ahm-adsaad/sdp-sensor-nodes/poster/poster-sustainability.html

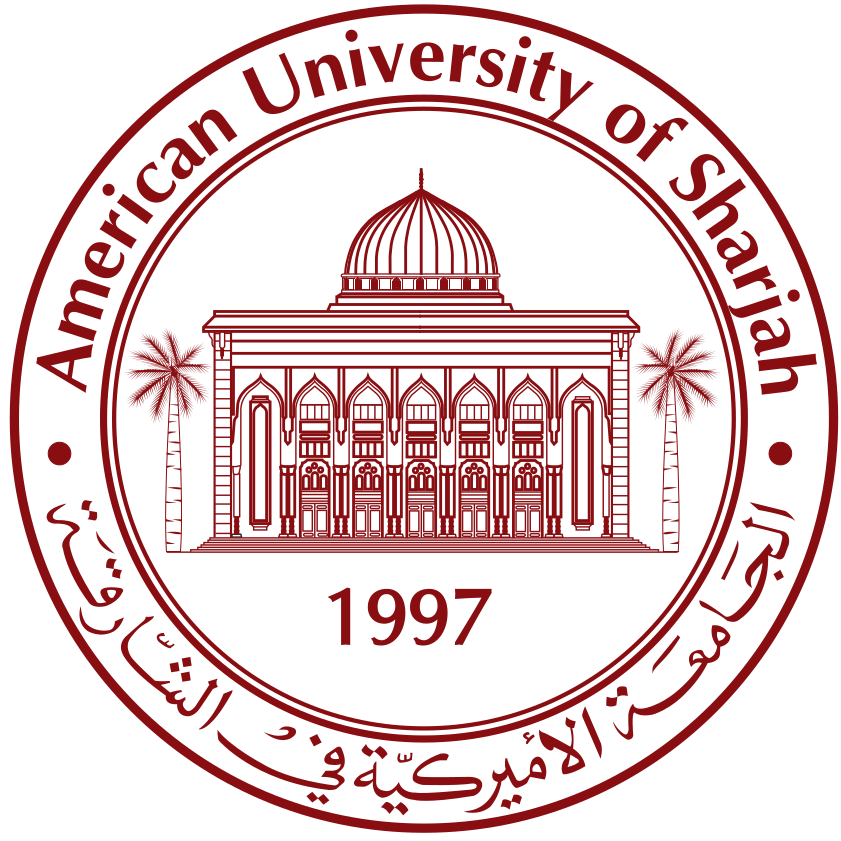
[picture p1: poster/assets/aus-seal.png]
American University of Sharjah seal


# A Practical Implementation of a Virtualized Energy Harvesting IoT

Ahmad Saad, Abdulrahman Hanifa, Mohammad Alatrash, Abdalrahman Al-Zaharna

Advisor: Dr. Anastassia Gharib
Department of Computer Science and Engineering, American University of Sharjah

## I. The Battery Problem

Sensor networks monitor the environment in many applications, but battery-powered deployments need periodic battery replacement, which hinders scalable long-term operation.

Most deployed sensor nodes run on batteries or a grid connection. Batteries degrade, and replacing them can be costly or dangerous [1]; nodes are often discarded once their batteries are depleted, even when the hardware still works.

As IoT deployments grow, so does the need for batteries, and periodic battery maintenance limits how far monitoring networks can scale and how sustainable they are.

Solar energy harvesting (EH) lets nodes recharge from ambient sources and extends network lifetime [2], but harvested energy is intermittent [3].

EH, node virtualization and dynamic task assignment have been explored separately; few works implement them together in hardware.

Goal: sustainable power without battery replacement, with every sensing task matched to the energy the nodes have stored.

## II. Battery vs. Harvesting

| Battery or grid node | Solar EH node, this work
Energy | Disposable battery or a grid connection | Ambient sunlight through a solar panel
Storage | Rechargeable battery: thousands of cycles [4] | Supercapacitor: millions of cycles [4], wide temperature range [5]
Upkeep | Periodic battery replacement | No battery to replace, lower maintenance cost [6]
Hazardous sites | Workers visit industrial, remote and high-rise sites | Fewer site visits: lower operating cost, safer workers
End of life | Often discarded with working hardware | Less battery and electronic waste
Grid | Grid-connected nodes need a power line | Grid-free nodes; one gateway covers power- and cellular-limited sites

## III. System Model

## IV. Resilience for Sharjah

Theme | Where the network serves
Resilient energy systems | Solar nodes with no grid dependency keep sensing where power access is limited
Water security | Remote wastewater plants: hazardous gases, temperature and humidity; water management
Climate and environmental resilience | Greenhouses in UAE sustainable cities: humidity and CO2
Smart and sustainable cities | Smart-city development such as Sharjah Sustainable City [7] and Masdar City [8]
Critical infrastructure | Industrial sites, remote infrastructure and high-rise installations, where access is difficult or unsafe

Energy-aware task assignment on battery-free nodes lays the groundwork for the large-scale adoption of sustainable IoT, enabling more resilient, efficient and environmentally conscious urban infrastructure.

## V. Energy-Aware Node

Harvesting charges the supercapacitor whatever the MCU state. A node sleeps, wakes to listen for tasks, powers its sensors through a load switch only while a task runs, then transmits readings with its energy status.

Virtualization lets one node serve different sensing tasks over time, so each node is used efficiently [9].

## VI. Energy-Aware Task Assignment

Each round, the VPS checks that the nodes’ stored energy ei covers every submitted task ej plus a reserve es=egas+etemp kept for future immediate tasks:

∑j∈Timm∪Tnonej+es≤∑i=1Sei (1)

If (1) fails, only immediate tasks enter. A MILP then favours costly tasks on nodes with a high remaining-energy share Pi, giving each task at most one node and keeping each node within its stored energy.

A two-phase heuristic is also defined: Phase 1 places each immediate task on the highest-energy node that can afford it; Phase 2 packs non-immediate tasks onto fewer nodes to reduce communication overhead, while each node keeps a reserve θ=egas+etemp. Unassigned tasks can be reconsidered once nodes report newly harvested energy.

Safety: a node must not start a task its stored energy cannot cover, and refuses high-power tasks when its supercapacitor runs low.

## VII. Low-Power Design Choices

Part | Chosen | Over | Deciding figure
MCU | ATmega4809 | ESP32 | 0.1 µA power-down [10] vs 10 µA deep sleep, RAM lost [11]
PMIC | AEM10330 | BQ25570 | Cold start from 275 mV [12] vs 600 mV [13]
Gas | ENS160 | SGP30 | 29 mA vs 48.8 mA active [14], [15]
Radio | LoRaWAN | BLE, Zigbee | 15 km line of sight vs 60 m and 75 m per hop [16]

## VIII. Evaluation Plan

Requirement | Target
Node to dashboard delay | ≤ 10 s
Data delivered, node to server | ≥ 95 %
Average node power when idle | < 10 mW
Nodes served at once, no packet loss | ≥ 4
Server and dashboard uptime | ≥ 95 %

The PPK2 will profile every node mode to confirm sustainable operation during sunlight hours; the scheme will be judged on task completion rate, latency and network lifetime.

## References

1. C. Delgado, J. M. Sanz, C. Blondia, J. Famaey, “Batteryless LoRaWAN communications using energy harvesting: Modeling and characterization,” IEEE Internet Things J., vol. 8, no. 4, 2021.
2. A. Singh, S. Redhu, B. Beferull-Lozano, R. M. Hegde, “Network-aware RF-energy harvesting for designing energy efficient IoT networks,” Internet of Things, vol. 22, 2023.
3. D. Ma, G. Lan, M. Hassan, W. Hu, S. K. Das, “Sensing, computing, and communications for energy harvesting IoTs: A survey,” IEEE Commun. Surv. Tutor., vol. 22, no. 2, 2020.
4. U. Tiwari, “What is the difference between supercapacitors and batteries?” 2024.
5. P. Matthews, “Supercapacitors vs. batteries: A comparison in energy storage solutions,” Knowles Precision Devices, 2024.
6. G. Avallone et al., “A comparative evaluation of IoT electronic solutions for energy harvesting,” Nano Express, vol. 5, no. 3, 2024.
7. Sharjah Sustainable City, “Sharjah Sustainable City reimagines future, vows healthy environment, sustainable development.”
8. Masdar City, “Net zero by 2050.”
9. I. Khan, F. Belqasmi, R. Glitho, N. Crespi, M. Morrow, P. Polakos, “Wireless sensor network virtualization: A survey,” IEEE Commun. Surv. Tutor., vol. 18, no. 1, 2016.
10. Microchip, ATmega4808/4809 Data Sheet, DS40002173C, 2021.
11. Espressif, ESP32 Series Datasheet, 2025.
12. e-peas, AEM10330 Datasheet, 2024.
13. Texas Instruments, BQ25570 Nano Power Boost Charger and Buck Converter for Energy Harvester Powered Applications, 2019.
14. ScioSense, ENS160 Digital Metal-Oxide Multi-Gas Sensor Datasheet, 2023.
15. Sensirion, SGP30 Indoor Air Quality Sensor Datasheet, 2020.
16. S. Sadowski, P. Spachos, “RSSI-based indoor localization with the Internet of Things,” IEEE Access, vol. 6, 2018.

We thank Dr. Zaid Haymoor for guidance on the hardware implementation.
