ahm-adsaad/sdp-sensor-nodes/poster/poster.html

American University of Sharjah seal

# A Practical Implementation of a Virtualized Energy Harvesting IoT

Ahmad Saad, Abdulrahman Hanifa, Mohammad Alatrash, Abdalrahman Al-Zaharna

Advisor: Dr. Anastassia Gharib
Department of Computer Science and Engineering, American University of Sharjah

## I. Motivation

Battery-powered sensor nodes need periodic battery replacement, which hinders scalable long-term operation; batteries degrade, and replacing them can be costly or dangerous [1]. Energy harvesting (EH) removes the battery, but harvested energy is intermittent.

EH, sensor-node virtualization and dynamic task assignment have been studied separately; few works implement them together in hardware.

Work | Covers | Lacks
[2] | Solar EH, deployed six months | One sensor per node
[3] | Solar EH, node virtualization | Reconfiguration across task types
[4] | Solar EH, task scheduling | Tasks fixed in advance
[5] | Virtualization, dynamic task arrival | Energy harvesting
Ours | Solar EH, node virtualization and dynamic task assignment on custom nodes

Goal: use harvested energy efficiently, maximize the task completion rate and minimize latency.

## II. System Model

## III. Sensor Node

Three power domains: 3V3_IN from the PMIC, joined to the core 3V3 rail through a header for the Nordic PPK2 power profiler, and VCC_SENS, which the load switch cuts during sleep to remove sensor quiescent draw.

## IV. Node Operation

Harvesting charges the supercapacitor whatever the MCU state. A node sleeps, wakes periodically to listen for tasks, powers its sensors only while a task runs, and transmits readings with its energy status before sleeping again.

## V. Task Assignment

### A. MILP

Each round, the VPS checks that the nodes’ stored energy ei covers every submitted task ej plus a reserve es=egas+etemp kept for future immediate tasks:

∑j∈Timm∪Tnonej+es≤∑i=1Sei (1)

If (1) fails, only immediate tasks enter. The MILP then favours costly tasks on nodes with a high remaining-energy share Pi:

max∑i=1S∑j=1TxijejPi (2)

s.t. ∑i=1Sxij≤1,∀j (3)

∑j=1Txijej≤ei,∀i (4)

with xij∈{0,1} set when task j goes to node i. Constraint (3) gives each task at most one node; (4) keeps each node within its stored energy.

### B. Heuristic

Phase 1 places each immediate task on the highest-energy node that can afford it. Phase 2 packs non-immediate tasks onto fewer nodes to reduce communication overhead, while each node keeps a reserve θ=egas+etemp.

Input: nodes S, tasks Timm, Tnon, cost C(t), reserve θ

1. sort Timm, Tnon by C(t), descending
2. for t ∈ Timm doPhase 1
3. sort S by energy E(s), descending
4. for s ∈ S do
5. if E(s) ≥ C(t) then
6. assign(s, t); E(s) −= C(t); break
7. sort S by E(s), descendingPhase 2
8. for s ∈ S do
9. for t ∈ Tnon do
10. if E(s) − C(t) ≥ θ then
11. assign(s, t); E(s) −= C(t)
12. return S and the unassigned tasks

Unassigned tasks can be reconsidered once nodes report newly harvested energy.

## VI. Design Choices

Part | Chosen | Over | Deciding figure
MCU | ATmega4809 | ESP32 | 0.1 µA power-down [6] vs 10 µA deep sleep, RAM lost [7]
PMIC | AEM10330 | BQ25570 | Cold start from 275 mV [8] vs 600 mV [9]
Storage | Supercapacitor | Battery | Millions vs thousands of charge cycles [10]
Gas | ENS160 | SGP30 | 29 mA vs 48.8 mA active [11], [12]
Radio | LoRaWAN | BLE, Zigbee | 15 km line of sight vs 60 m and 75 m per hop [13]

### Standards

LoRaWAN 1.0.4 Class A; ETSI EN 300 220-2 for 868 MHz, as required by the UAE TDRA; MQTT 3.1.1; TLS 1.3 between gateway and VPS; RoHS 2011/65/EU; IPC-2221; IEEE C95.1; ISO/IEC 14882; ISO 9241-11.

## VII. Evaluation Plan

Requirement | Target
Node to dashboard delay | ≤ 10 s
Data delivered, node to server | ≥ 95 %
Average node power when idle | < 10 mW
Nodes served at once, no packet loss | ≥ 4
Server and dashboard uptime | ≥ 95 %

The PPK2 will profile each mode: sleep, wake, SHT41 and ENS160 reads, LoRa Tx and Rx. The network will be judged on packet delivery ratio and energy per transmission; the scheme on task completion rate, latency, task distribution and network lifetime. Safety: a node must not start a task its stored energy cannot cover.

## VIII. Toward Resilient Infrastructure

- Grid-independent nodes and a single long-range gateway suit power- and cellular-limited sites: hazardous gases, temperature and humidity at remote wastewater plants, or humidity and CO2 in greenhouses.
- Fewer battery replacements at hard-to-reach or hazardous sites lower maintenance cost, keep workers safer and cut battery waste.
- Supports sustainable-city development such as Sharjah Sustainable City.

## References

1. C. Delgado, J. M. Sanz, C. Blondia, J. Famaey, “Batteryless LoRaWAN communications using energy harvesting: Modeling and characterization,” IEEE Internet Things J., vol. 8, no. 4, 2021.
2. K. Malek et al., “Design and implementation of sustainable solar energy harvesting for low-cost remote sensors equipped with real-time monitoring systems,” J. Infrastruct. Intell. Resil., vol. 2, no. 3, 2023.
3. L. Zhang, K.-W. Chin, M. Ros, “On virtualizing targets coverage in energy harvesting IoT systems,” IEEE Internet Things J., vol. 11, no. 2, 2024.
4. Y. Cui, K.-W. Chin, S. Soh, M. Ros, “Novel task scheduling approaches in energy sharing solar-powered IoT networks,” IEEE Internet Things J., vol. 10, no. 12, 2023.
5. V. Maleki Raee, A. Ebrahimzadeh, R. H. Glitho, H. Elbiaze, “Ensuring energy efficiency when dynamically assigning tasks in virtualized wireless sensor networks,” IEEE Trans. Green Commun. Netw., vol. 6, no. 1, 2022.
6. Microchip, ATmega4808/4809 Data Sheet, DS40002173C, 2021.
7. Espressif, ESP32 Series Datasheet, 2025.
8. e-peas, AEM10330 Datasheet, 2024.
9. Texas Instruments, BQ25570 Nano Power Boost Charger and Buck Converter for Energy Harvester Powered Applications, 2019.
10. U. Tiwari, “What is the difference between supercapacitors and batteries?” 2024.
11. ScioSense, ENS160 Digital Metal-Oxide Multi-Gas Sensor Datasheet, 2023.
12. Sensirion, SGP30 Indoor Air Quality Sensor Datasheet, 2020.
13. S. Sadowski, P. Spachos, “RSSI-based indoor localization with the Internet of Things,” IEEE Access, vol. 6, 2018.

We thank Dr. Zaid Haymoor for guidance on the hardware implementation.
