ahm-adsaad/sdp-sensor-nodes/enclosure/out/renders/body_back.png

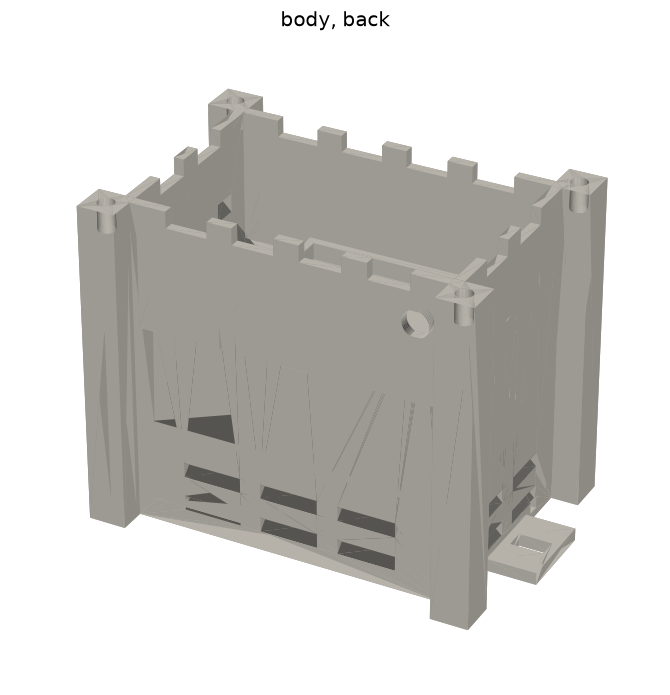
enclosure/out/renders/body_back.png
