ahm-adsaad/sdp-sensor-nodes/enclosure/out/renders/body_front.png

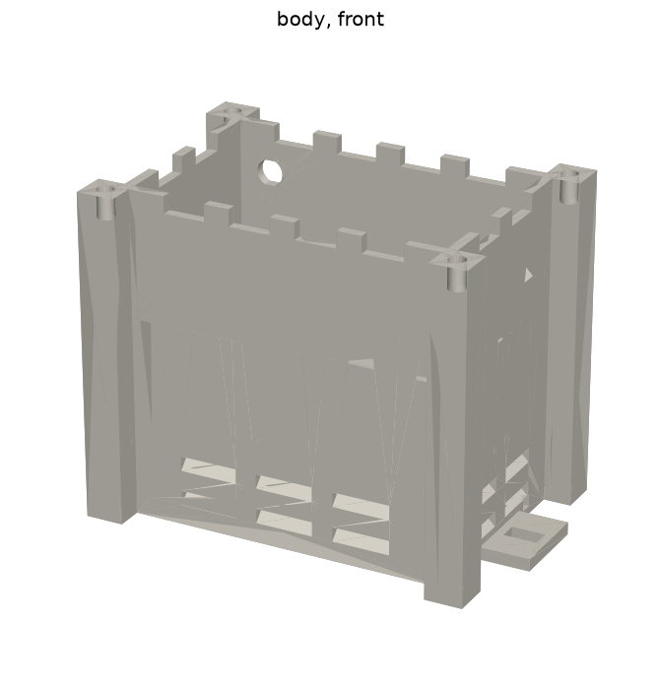
enclosure/out/renders/body_front.png
