ahm-adsaad/sdp-sensor-nodes/enclosure/out/renders/body_top.png

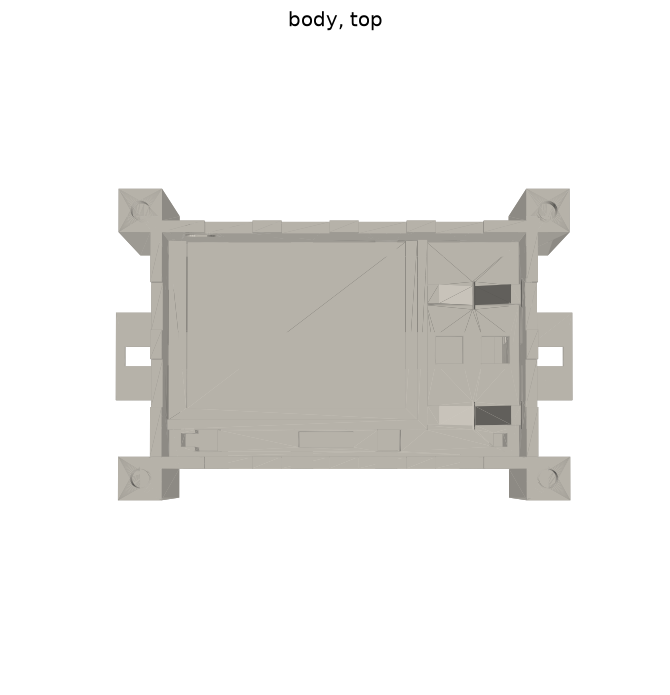
enclosure/out/renders/body_top.png
