ahm-adsaad/sdp-sensor-nodes/enclosure/out/renders/body_under.png

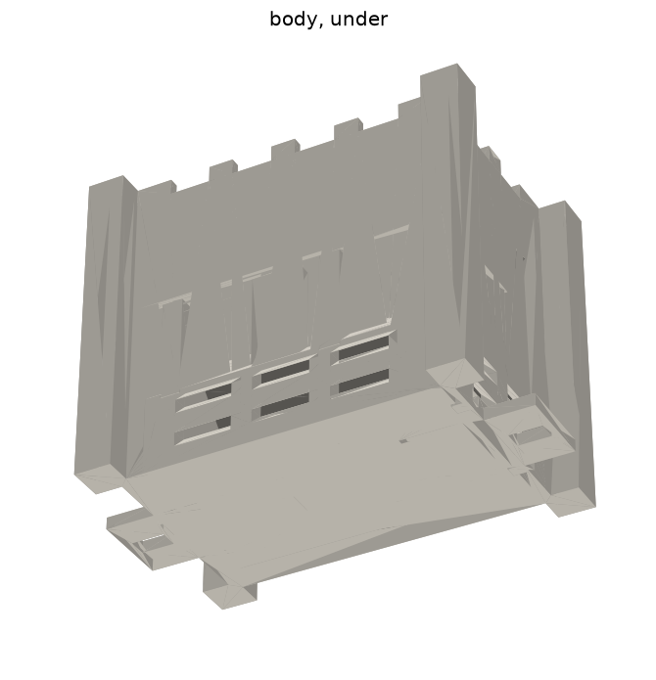
enclosure/out/renders/body_under.png
