ahm-adsaad/sdp-sensor-nodes/enclosure/out/renders/fit_coupon_back.png

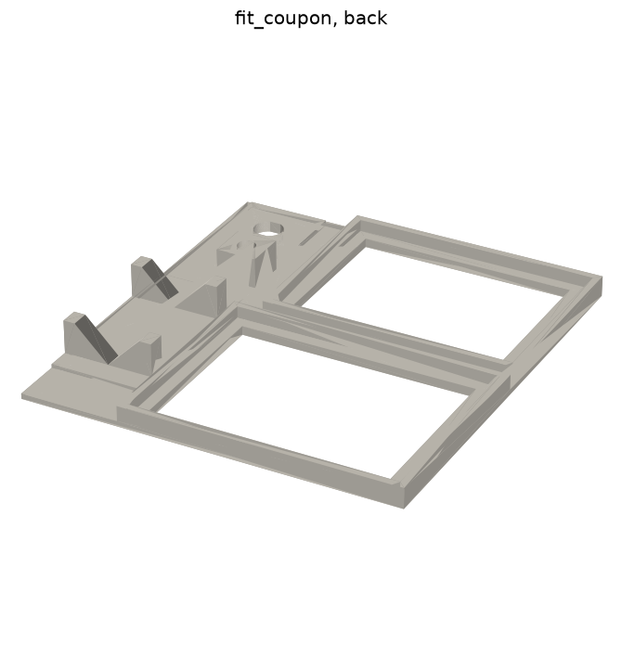
enclosure/out/renders/fit_coupon_back.png
