ahm-adsaad/sdp-sensor-nodes/enclosure/out/renders/fit_coupon_front.png

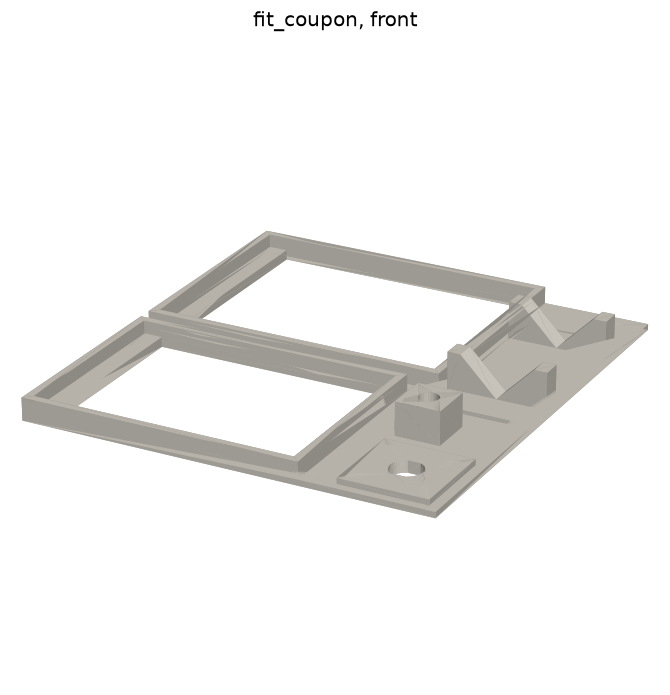
enclosure/out/renders/fit_coupon_front.png
