ahm-adsaad/sdp-sensor-nodes/enclosure/out/renders/fit_coupon_top.png

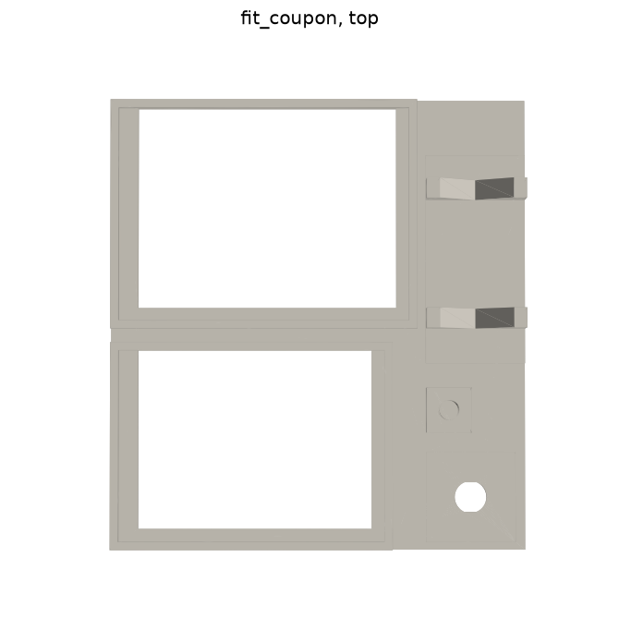
enclosure/out/renders/fit_coupon_top.png
