ahm-adsaad/sdp-sensor-nodes/enclosure/out/renders/fit_coupon_under.png

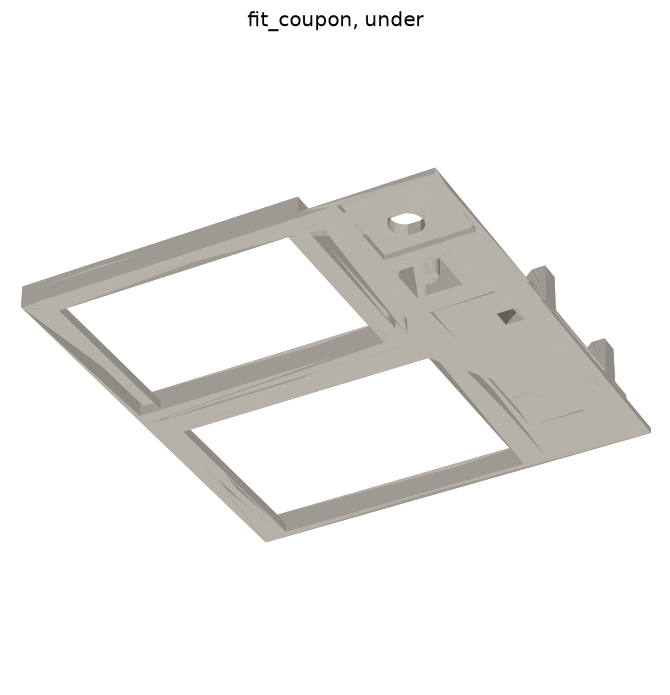
enclosure/out/renders/fit_coupon_under.png
