ahm-adsaad/sdp-sensor-nodes/enclosure/out/renders/lid_1panel_back.png

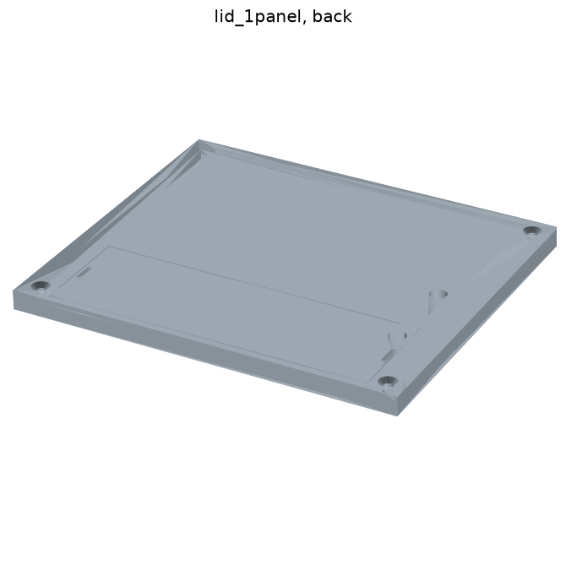
enclosure/out/renders/lid_1panel_back.png
