ahm-adsaad/sdp-sensor-nodes/enclosure/out/renders/lid_1panel_front.png

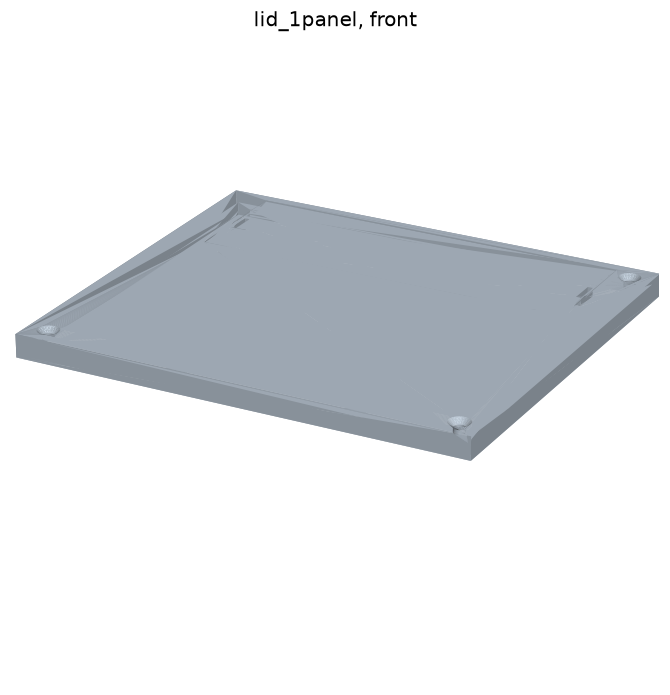
enclosure/out/renders/lid_1panel_front.png
