ahm-adsaad/sdp-sensor-nodes/enclosure/out/renders/lid_1panel_top.png

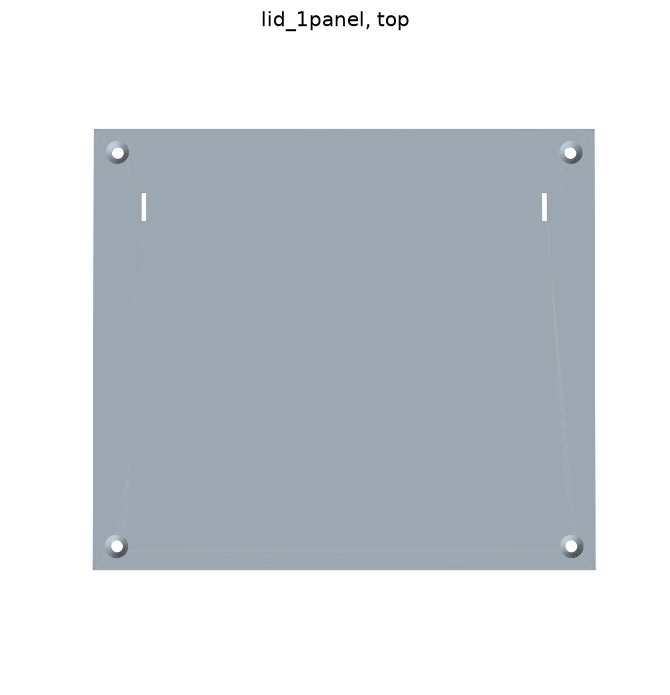
enclosure/out/renders/lid_1panel_top.png
