ahm-adsaad/sdp-sensor-nodes/enclosure/out/renders/lid_1panel_under.png

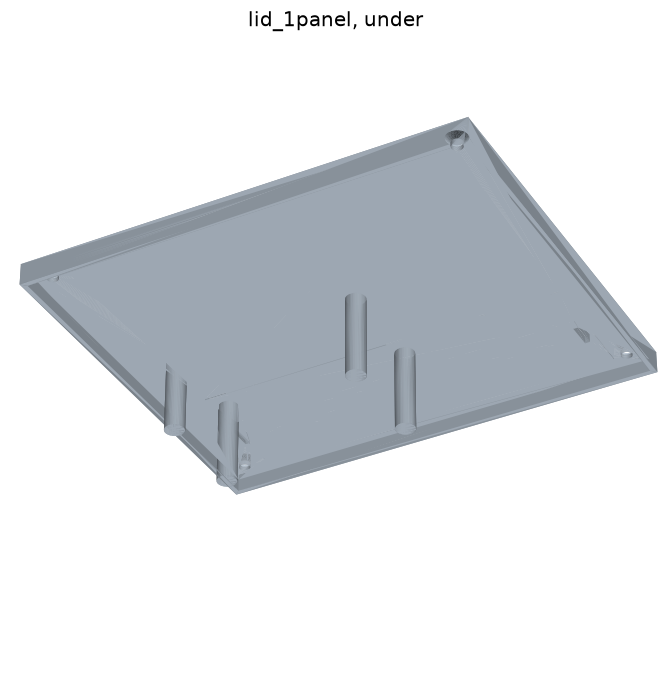
enclosure/out/renders/lid_1panel_under.png
