ahm-adsaad/sdp-sensor-nodes/enclosure/out/renders/lid_back.png

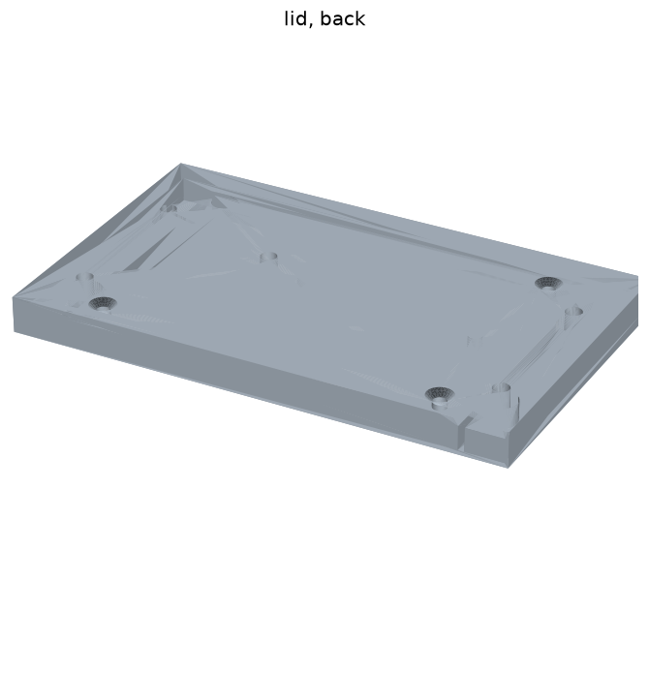
enclosure/out/renders/lid_back.png
