ahm-adsaad/sdp-sensor-nodes/enclosure/out/renders/lid_front.png

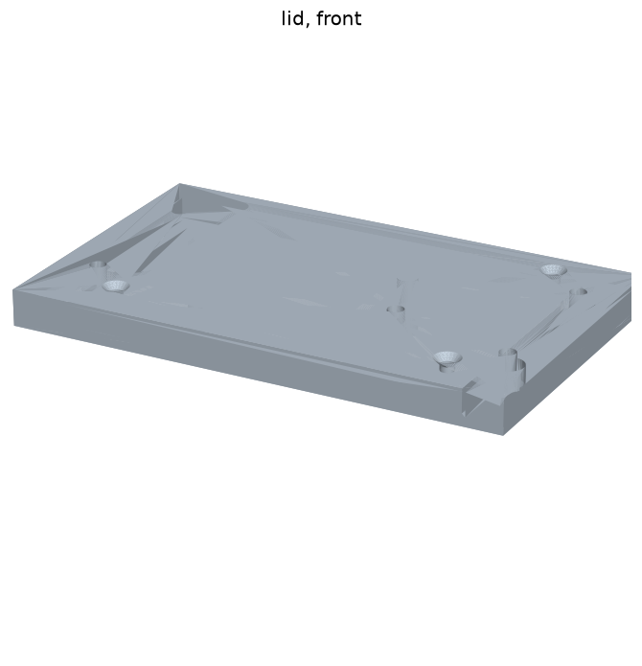
enclosure/out/renders/lid_front.png
