ahm-adsaad/sdp-sensor-nodes/enclosure/out/renders/lid_top.png

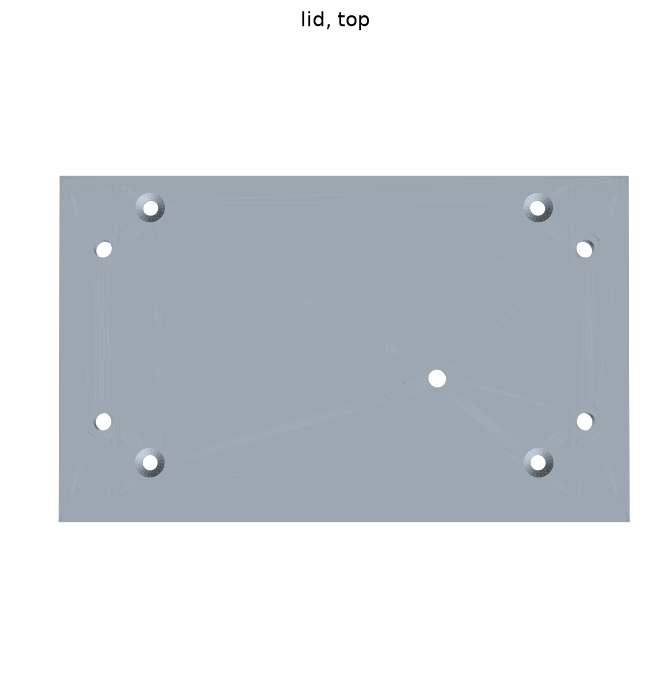
enclosure/out/renders/lid_top.png
