ahm-adsaad/sdp-sensor-nodes/enclosure/out/renders/lid_under.png

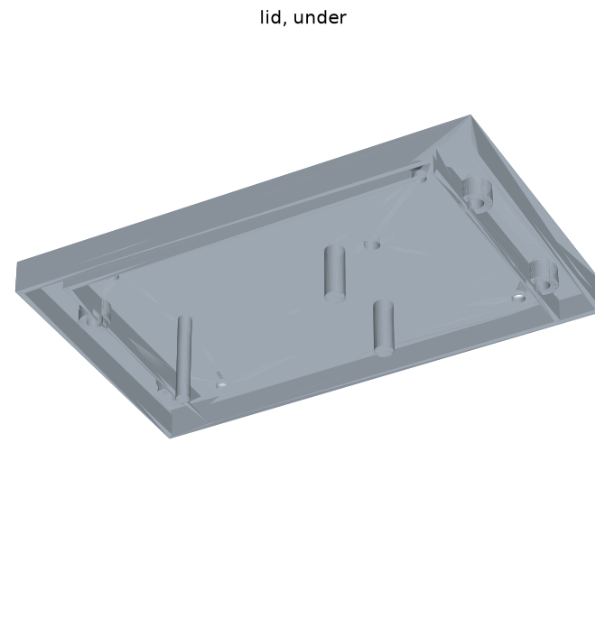
enclosure/out/renders/lid_under.png
