ahm-adsaad/sdp-sensor-nodes/enclosure/out/renders/wedge_back.png

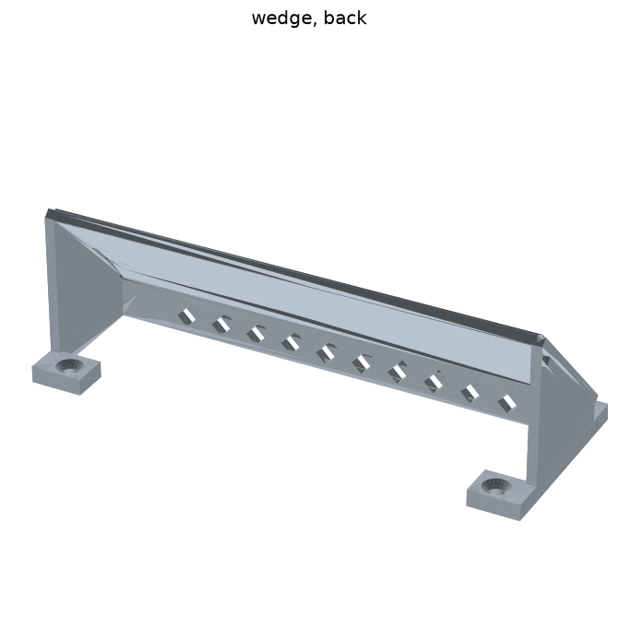
enclosure/out/renders/wedge_back.png
