ahm-adsaad/sdp-sensor-nodes/enclosure/out/renders/wedge_front.png

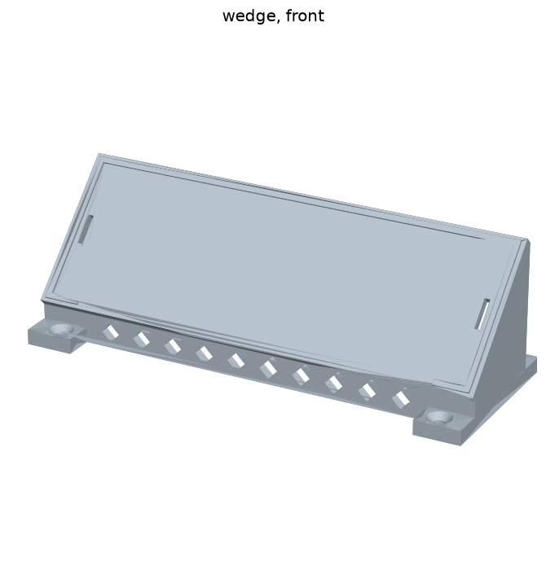
enclosure/out/renders/wedge_front.png
