ahm-adsaad/sdp-sensor-nodes/enclosure/out/renders/wedge_top.png

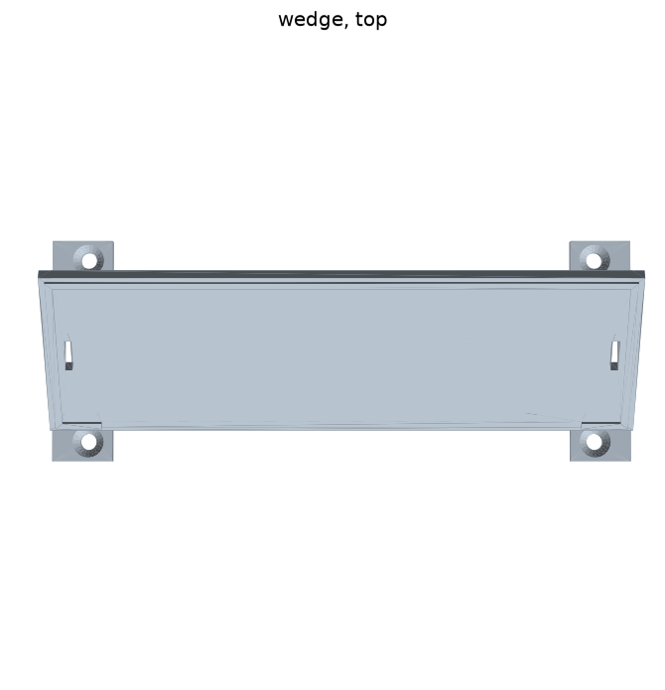
enclosure/out/renders/wedge_top.png
