ahm-adsaad/sdp-sensor-nodes/enclosure/out/renders/wedge_under.png

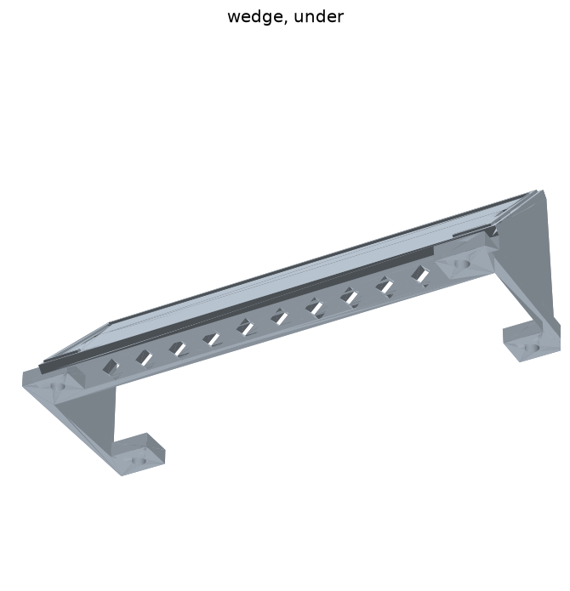
enclosure/out/renders/wedge_under.png
