ahm-adsaad/sdp-sensor-nodes/poster/poster-preview.png

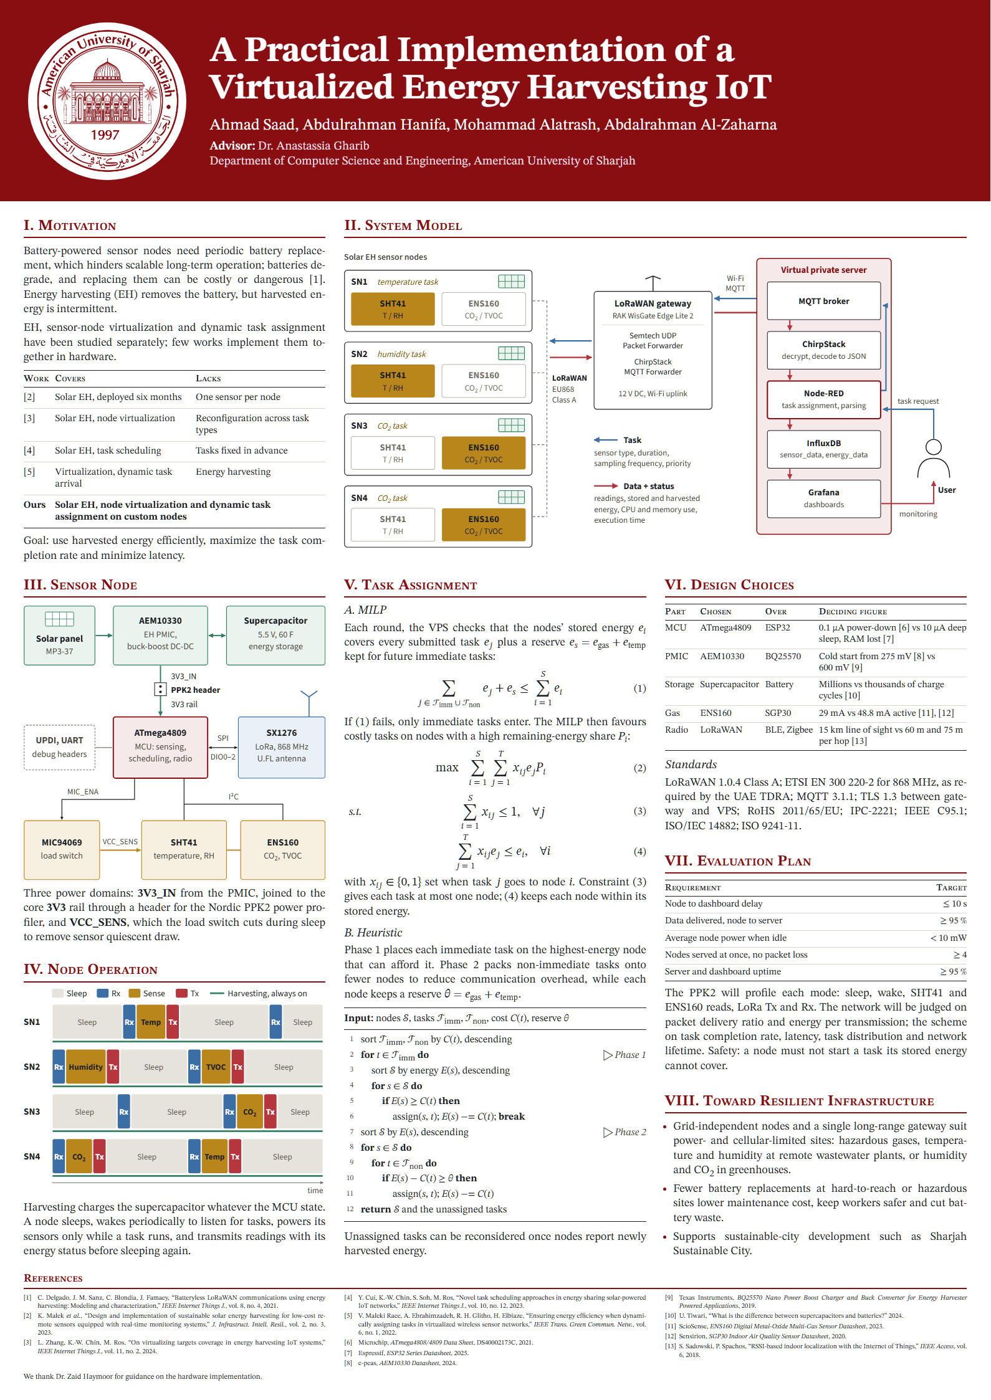
poster/poster-preview.png
