ahm-adsaad/sdp-sensor-nodes/poster/poster-sustainability-preview.png

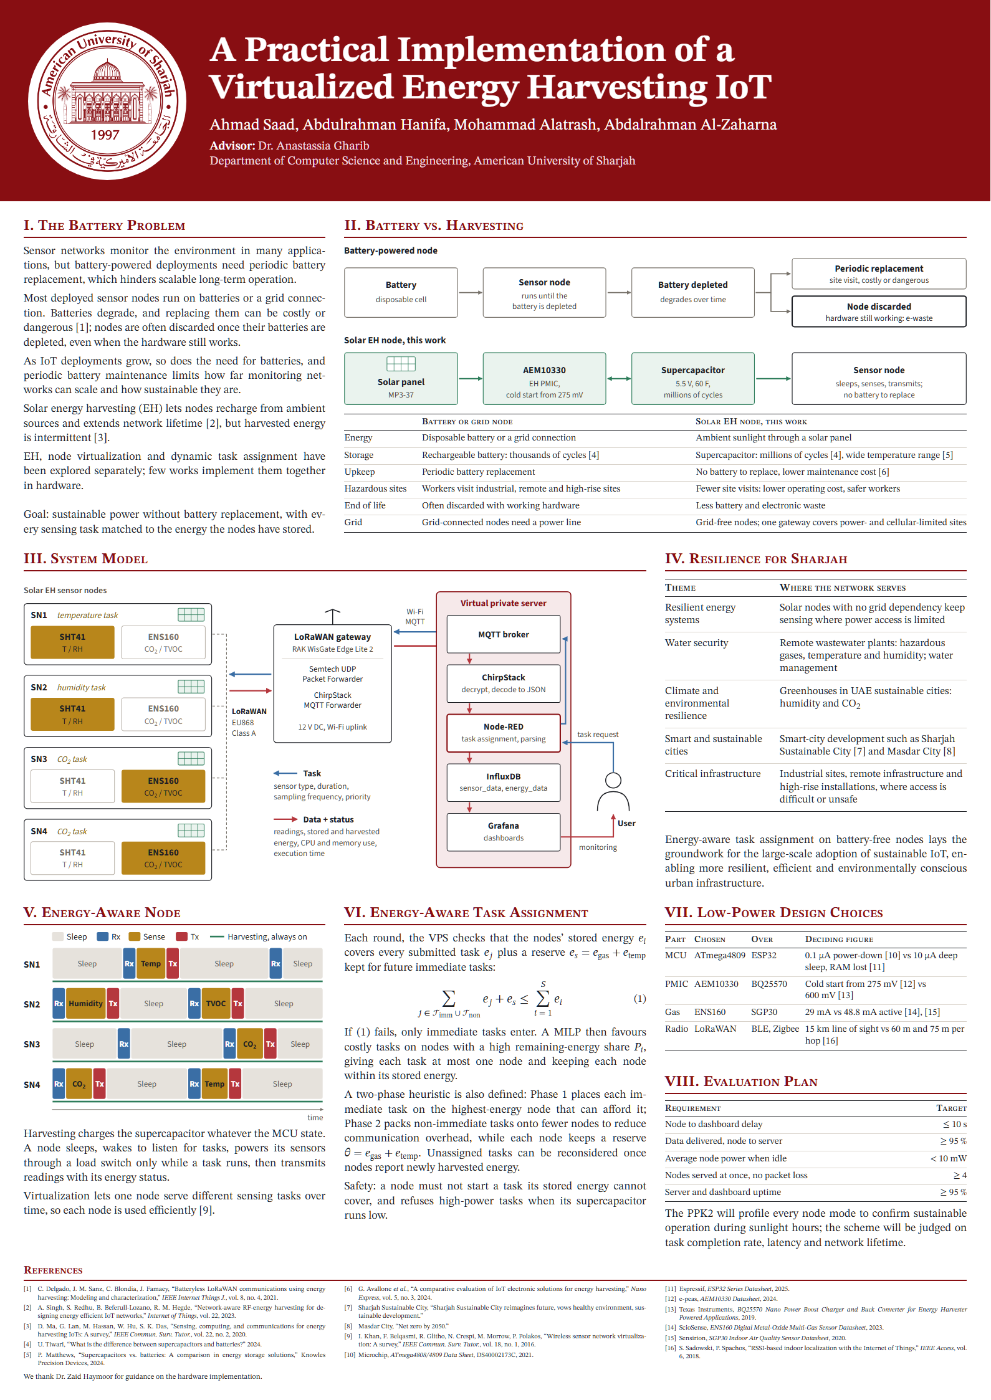
poster/poster-sustainability-preview.png
