ahm-adsaad/sdp-sensor-nodes/sensor-nodes-hardware/photos/Sensor Node.jpeg

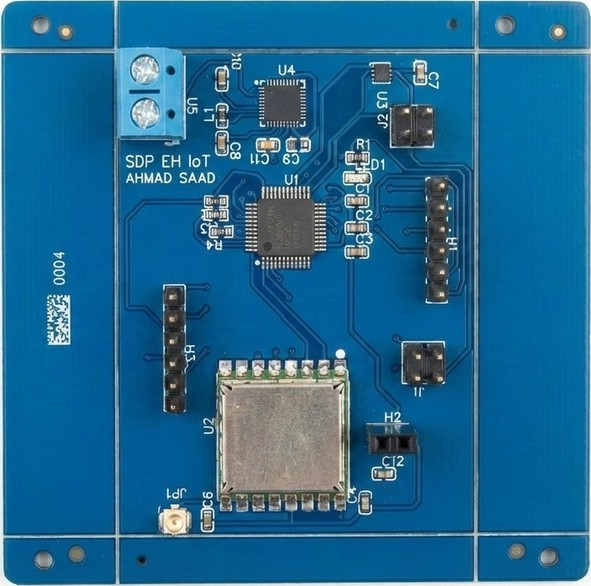
sensor-nodes-hardware/photos/Sensor Node.jpeg
