ahm-adsaad/sdp-sensor-nodes/docs/research/2026-09-20-energy-prediction-literature.UPDATED.xlsx

Sheet: Papers
# | Group | Paper | What they did | Main result | How the model works, and what it uses | Link
2 | A. Predicting harvest | Prediction and management in energy harvested wireless sensor nodes | Predicts the energy in the next 30 minute slot. The forecast blends the last measured slot with the average of that next slot over the last 4 days, scaled by how today is running against those days. Called WCMA (Weather-Conditioned Moving Average). Settings were tuned and tested against EWMA on 45 days of their own solar panel data. The forecast was then used to decide how much signal processing a Shimmer structural health monitoring node could afford around noon on four days. | Average error over all 45 days: 9.8 percent for WCMA against 28.6 percent for EWMA, predicting the next 30 min slot. The error is the mean of |1 - real/predicted| (Eq. 9), daytime only (samples under 10 percent of the maximum left out), on the same 45 days used to pick the settings. In the 30 min slot at noon on day 8, when the weather turned: 10.20 percent for WCMA against minus 90.99 percent for EWMA (real 284.63 J, WCMA 255.60 J, EWMA 543.60 J). Used to plan processing on a Shimmer node that day, WCMA gave 1.45 s of DSP time per path (oracle 1.63 s), while EWMA planned 3.22 s and the node ran out of energy before finishing the scan. | Day split into 48 slots of 30 minutes, with the last 4 days kept in memory. The forecast for the next slot is 0.7 times the last measured slot plus 0.3 times the plain average of the next slot over those 4 days, and that average is scaled by a GAP factor. GAP is a weighted average of today's last 3 slots divided by the average of the same slots on the stored days, with weights 1/3, 2/3 and 1 so the newest slot counts most. Published settings: weighting factor 0.7, 4 days, 48 slots, 3 slots for the GAP factor. Input is the node's own harvest history, nothing external. | https://doi.org/10.1109/WIRELESSVITAE.2009.5172412
3 | A. Predicting harvest | Evaluation and design exploration of solar harvested-energy prediction algorithm | Takes the WCMA predictor (cited as Recas et al., 2009; the paper does not use the name WCMA) and tests it on 365 days of public NREL data from six US sites with different solar profiles, at slot lengths from 5 minutes to 1 hour. The slot length is the prediction horizon. Proposes scoring the prediction against the slot's mean power, gives tuning guidelines for the parameters, measures the cost on an MSP430, and estimates how much an ideal choice of parameters at every prediction could gain. | MAPE against the slot's mean power, daytime only, with parameters tuned per site on the same data: 6.59 to 17.22 percent at 30 minutes (PFCI best, ORNL worst) and 8.88 to 21.43 percent at 1 hour (NPCS best, ORNL worst). Shorter slots were always more accurate: 3.45 to 8.31 percent at 5 minutes on the four 1 minute sites. A prediction costs 4 to 9 microjoules on top of 55 microjoules for the ADC reading. Choosing alpha and K ideally at every prediction, which needs the future, cut 30 minute error to 5.37 to 7.38 percent on four sites. | Prediction = alpha x the reading at the start of the current slot + (1 - alpha) x the mean of the next slot over the last D days x a factor for how bright today is. The factor averages today's last K readings divided by their past-day means, weighted towards the latest slot. For each site the paper sweeps slots per day (288, 96, 72, 48, 24), stored days D (2 to 20), recent slots K (1 to 6) and alpha (0 to 1), and keeps the set with the lowest MAPE. The data is public NREL irradiance from 6 US sites, not node measurements. Guidelines: D of 10 to 11 days, K = 2, alpha 0.7 to 0.8 for 48 to 96 slots a day, 0.5 to 0.6 at 24 and about 1 at 288. Also measures what a prediction costs on an MSP430. | https://doi.org/10.1109/DATE.2010.5457222
4 | A. Predicting harvest | Pro-Energy: a novel energy prediction model for solar and wind energy-harvesting wireless sensor networks | Keeps a pool of whole past days of harvest. Each slot it finds the stored day, or a weighted blend of several, whose last few slots best match today's, and forecasts the coming slots by mixing that day's values with the latest measured slot. The latest slot counts less the further ahead the forecast goes. | On the Rome solar nodes, error (MAPE) of 20.00 percent 30 minutes ahead, against 21.12 for WCMA and 35.21 for EWMA, and 26.18 against 35.51 and 35.21 one hour ahead, rising to 31.92 at 3 hours while EWMA stayed at 35.21. Slots below 10 percent of the day's peak power were left out of the MAPE, and past one slot WCMA was the authors' simplified version. On the Oak Ridge solar data, 60 percent better than EWMA and WCMA at 1 hour. The 2016 journal version reports up to 67 percent lower error (MADP) on the Oak Ridge solar data. | Day split into N equal slots (48 of 30 minutes), with a pool of D whole past days kept in memory. Similarity is the mean absolute error between each stored day and today over the last K slots. For a slot i steps ahead, the forecast is gamma_i x last measured slot + (1 - gamma_i) x that slot in the most similar stored day, or in a weighted blend of the P most similar days. gamma_i starts at alpha and falls linearly to zero after G slots. At the end of each day, today's profile replaces one stored more than A days ago, or one of two near-duplicate days. Input is the node's own harvest history only. | https://doi.org/10.1109/MASS.2012.6502504
5 | A. Predicting harvest | UD-WCMA: an energy estimation and forecast scheme for solar powered wireless sensor networks | Makes WCMA's weighting adapt as the weather changes, rather than being tuned in advance, by blending the latest measurement, the most similar stored day and the average of the stored days scaled by GAP. Tested on recorded irradiance and on the panel current of 10 solar-powered nodes. | On 6 test days of 30 min irradiance it had the lowest one-slot-ahead relative error (percent) on every day against EWMA, WCMA and Pro-Energy, each given its best alpha (0.2 to 0.8) after the fact; on 2 of the days the margin is too small to read from the chart. At 1 to 3 h ahead (mean absolute error) the authors report it best on 5 of 6 days, though their chart shows WCMA level or slightly lower at some horizons on 2 of those days; on the most variable day WCMA and Pro-Energy did better beyond 30 min. Over a year of 1 h KAUST data its absolute error peaked near 24 W/m2, lower than the others. On a 10 node deployment run for 6 months, the forecast of panel current for the day shown had an RMSE of 18.79 mA, and it ran in 1 ms; no other method was run on the nodes. An independent 2020 comparison (Herrería-Alonso et al., Sensors 20(5) 1391) found it beat Pro-Energy only at that method's low overhead setting, at 30 to 120 min ahead. | Keeps 6 hand-picked past days, chosen to cover low, medium and high levels with smooth and abrupt changes; no rule for updating them is given. The forecast blends today's last value, the matching slot in the most similar stored day, and the average of the stored days scaled by a GAP factor. The blend weights are recomputed every slot from standard deviations: of the stored days at the next slot, of their slot-to-slot changes, and of today's last 3 changes. By the formulas, the GAP-scaled average always gets at least half the weight, and when today's recent changes vary more, weight moves from the last reading to the most similar stored day. Uses 4 recent slots. No tuning. Input: panel current or irradiance every 30 minutes (1 h in a year-long test). | https://doi.org/10.1016/j.jnca.2017.04.003
11 | A. Predicting harvest | Cloudy computing: leveraging weather forecasts in energy harvesting sensor systems | Predicts harvest from a public weather forecast instead of the node's own history. Solar: a clear day power curve for the month, reduced by the forecast cloud cover. Wind: a fitted cubic of the forecast wind speed. Tested in simulation on two systems with fixed demand: a sensor testbed that accepts or rejects 24 h leases, and a five-node TelosB network that sets a fair sensing rate each day. | Between 3 hours and 3 days ahead, the forecast's error in the weather itself was under half that of assuming the past repeats: sky cover RMSE under 30 against about 60, wind speed under 6 against about 11 mph. In the simulated five-node network on solar, at least one node ran out of energy on under 5 percent of days with forecasts, against nearly 50 percent with history, while keeping 80 percent of the history-based sensing rate (the bar in Fig. 9a reads nearer 9 percent). No error figure is given for the harvest prediction itself. | Solar: power = alpha x MaxPower(month, time of day) x (1 - forecast cloud cover). MaxPower is a quadratic in time of day, fitted by least squares to one cloudless day per month. Wind: power = alpha x (0.01787485 x windspeed^3 - 3.4013). Alpha is a constant per forecast horizon, set from the forecast's RMSE at that horizon, smaller when the forecast is less accurate. Inputs: National Weather Service sky cover and wind speed forecasts, every 3 h from 3 to 72 hours ahead. No machine learning, only least-squares curve fits. | https://doi.org/10.1109/SECON.2010.5508260
19 | A. Predicting harvest | Power management in energy harvesting sensor networks | Defined energy-neutral operation and gave sufficient conditions for it from a burstiness model of harvest and load, with storage efficiency and leakage, leading to a minimum buffer size and a sustainable power level. Built an EWMA predictor of solar harvest per half-hour slot, a low-complexity duty-cycle optimiser and a per-slot correction algorithm, tested on 67 days of Heliomote solar data from Los Angeles. Also modelled workload allocation across a harvesting network. | EWMA weight 0.5 gave the lowest prediction error. Average prediction error per slot was near zero at night and at most 20 mW in the day, against daytime harvest near 150 mW. The dynamic duty-cycling algorithm reached 97.3, 96.2 and 97.8 percent of the optimal (future-knowledge) average duty cycle for minimum duty cycles 0.2, 0.4 and 0.05 (maximum 0.7, battery efficiency 0.7), against 82.5, 86.2 and 82.4 percent for a naive fixed daily duty cycle. | For each of 48 half-hour slots of the day, keep a stored average and update it at the end of that slot: new average = 0.5 x old average + 0.5 x energy just measured in the slot. The stored average is the prediction for the same slot tomorrow. | https://doi.org/10.1145/1274858.1274870
7 | B. Machine learning | A hybrid prediction model for solar radiation based on long short-term memory, empirical mode decomposition, and solar profiles for energy harvesting wireless sensor networks | Splits hourly solar radiation from a public database into components with empirical mode decomposition (EMD), trains an LSTM on each and adds the predictions up. Forecasts 1, 2, 6, 12 and 24 hours ahead, plus daily totals, and compares against EWMA, WCMA and a single LSTM. No sensor nodes are involved. | One hour ahead in 2008, the full model (EMD-LSTM with negative outputs set to 0) had an RMSE of 43.78 in Alabama, 46.82 in Michigan and 41.45 in Nevada, in the Wh per square metre units of the data. Across the three sites and three years it was 5.0 to 15.7 percent better than a single LSTM with negatives set to 0, and 25.0 to 48.7 percent better than EWMA and WCMA. On daily totals it beat the single LSTM by 30.1 to 40.2 percent. Never compared against tree models, persistence or methods that use weather forecasts. | Past solar radiation only, hourly, from the US NSRDB (modelled global horizontal radiation, 3 sites, 3 years): the previous 24 hours predict the next hour. EMD splits the series into components (10 in their Alabama 2008 example) plus a residual, each predicted by its own LSTM (2 LSTM layers and 1 dense layer, RMSprop, 200 epochs, 80/20 split), and the forecasts are summed; negative outputs are set to 0. A variant (Pro) trains only on days of the same year that fall in the same K-means cluster (10 clusters) as today's first 16 hours; it was tested in Alabama only. Layer sizes, learning rate and batch size are not given. | https://doi.org/10.3390/en12244762
8 | B. Machine learning | Predicting solar-harvested energy for resource-constrained IoT devices using machine learning | Estimates how much energy the device harvested during the sleep interval that just ended, from the light level at the start and end of that interval plus the time of day. It does not forecast the next interval. Compares quantile regression, random forest, gradient boosting (LightGBM and XGBoost) and a small neural network for wake-up gaps from 30 minutes to 5 hours, then runs the models on an ESP32. | Offline, the small neural network had the lowest sMAPE at every wake-up gap (21.07 percent at 30 minutes, 31.33 percent at 5 hours), with random forest close behind (21.49 to 32.53 percent). But the network's MSE was higher than all three tree models at every gap (for example 15.93 against 9.79 for random forest at 30 minutes). Quantile regression was worst (42.18 to 64.34 percent). In a field test from 20 to 25 January at 1 hour wake-ups, random forest (16.56 percent) and LightGBM (16.67 percent) beat the neural network (19.66 percent). XGBoost scored 154.92 percent, which the authors blame on a faulty conversion of the model to code. | Inputs: lux at the previous and the current wake-up, plus the time of day at both as sine and cosine (six features). No weather data. Target: energy in mWh over the gap, measured with an INA219 between the charger and the battery. Light is read by a MAX44009 aligned with the panel. Trained on 100 days of data from an indoor windowsill. Chosen random forest: 5 trees, depth 10, 5 samples per leaf. Neural network: 2 hidden layers of 16, ReLU. Trained on a computer; the tree models are converted to Python code with m2cgen and the network to TensorFlow Lite, and run on an ESP32. | https://doi.org/10.1109/DCOSS-IoT61029.2024.00103
20 | B. Machine learning | Predicting solar generation from weather forecasts using machine learning | Trained regression models that map National Weather Service forecasts (temperature, dew point, wind speed, sky cover, chance of precipitation, relative humidity) plus day of year to solar intensity 3 hours ahead at noon, for one rooftop weather station at UMass Amherst. Compared linear least squares, SVM regression with linear, polynomial and RBF kernels, and an RBF SVM after PCA, against their earlier sky-cover-only model (#11) and a previous-day baseline. | Test RMSE (September and October 2010, noon, 3 h ahead): previous day 261 W/m², sky cover only 175, linear least squares 130, RBF SVM on all seven inputs 163, RBF SVM on 4 PCA components 128. The authors report the last as 27 percent better than the sky cover model and 51 percent better than the previous day. Linear least squares was within 2 W/m² of it. Linear and polynomial SVM kernels were worse (201 and 228 W/m²). | Solar intensity = F(day of year, forecast temperature, dew point, wind speed, sky cover, chance of precipitation, humidity), with F learned from 8 months of paired forecasts and measurements. Inputs normalised to zero mean and unit variance. Best model: SVM regression (LibSVM) with an RBF kernel, cost 256, gamma 0.015625, epsilon 0.001953125 from a grid search, on the first 4 principal components. Output is solar intensity (W/m²), used as a proxy for panel power. Horizon 3 h, noon only. | https://doi.org/10.1109/SmartGridComm.2011.6102379
21 | B. Machine learning | Online machine learning for 1-day-ahead prediction of indoor photovoltaic energy | Simulated online learning on a public indoor PV data set (Sigrist et al., 961 days, 2017 to 2020). Every midnight a new random forest is trained on the last 10 or 30 days and predicts all 24 hourly slots of the next day. Three locations: a lab wall near a window (L14), an office with a curtain (L17) and a hallway lit only by weak artificial light (L18). Features were added in steps: power at the same hour the day before, workday, day of week and hour; then sun elevation and azimuth; then observed radiation from a weather station 1 km away (not usable in practice); then the MeteoSwiss COSMO-1 radiation forecast issued before midnight. | Baseline is persistence at 24 h (LAG). With the radiation forecast the best random forest cut mean STAPE by 32.9 percent at L14 (38.11 to 25.58 percent), 22.9 percent at L17 (58.54 to 45.12 percent) and 56.7 percent at L18 (31.52 to 13.65 percent); SMAPE fell by 23.9, 16.0 and 47.9 percent. At L18 the gain came from the basic features, as the model learns the weekend; weather added nothing there. At L14 and L17 time and sun-angle features gave only small gains and the weather forecast gave most of the rest. With observed radiation instead of the forecast, L14 STAPE fell to 13.57 percent, so most remaining error at L14 is weather forecast error. SVM, XGBoost and shallow and deep neural networks were tried and 'did in general not score better' than random forest; no numbers given. EWMA only slightly beat LAG on STAPE at L17 and was worse on SMAPE everywhere. | A scikit-learn random forest regressor is retrained every midnight on a sliding window of at most t_max days of hourly rows. Each row is one hour: power 24 h earlier, workday flag, day of week, hour of day, sun elevation and azimuth, and the forecast shortwave radiation for that hour. The forest averages its trees to give the average power for each of the next 24 hours. Data older than t_max is dropped, so the model follows seasonal and room changes. | https://doi.org/10.1109/ACCESS.2023.3267810
22 | B. Machine learning | Uncertainty-aware energy harvest prediction and management for IoT devices | Predicted solar harvest and its uncertainty for the next five 1-hour intervals with small neural networks: a classifier picks low, medium or high energy, then per-level networks output a mean and a variance, turned into Gaussian prediction intervals. An energy allocator re-solves a one-day budget every hour using a value inside the interval chosen from how recent actual harvest compared with past predictions. Simulated with NREL per-minute irradiance through an SP3-37 PV cell model and a 12 mAh battery: Golden, Colorado 2015 to 2020 (one year for training), Las Vegas 2017 to 2020 and Eugene 2018 to 2020. | Prediction MAE 3.43 J; next-interval MAE 1.9 J against 3 J for Q-learning (QL-SEP-EDA); lower MAE than EWMA, WCMA, Pro-Energy and QL-SEP-EDA. Prediction interval coverage 80 percent over five years in Golden. Allocations within 2.5 J MAE of an oracle; zero or one battery constraint violation on most days, against 19 or 20 violations on more than 100 days for the ICCAD'17 baseline. On a TI CC2652: prediction 33 ms and 319.4 microjoules, allocation up to 3 s and 2.65 to 36.54 mJ, about 6 KB memory. | Every hour, 17 features are built from the device's own harvest history: harvest in the same hour on the previous 3 days, harvest in the previous 4 hours today, the average 5-point derivative of harvested energy over the past 15, 30 and 60 minutes, the ratios of harvest in consecutive past hours, a 3-point derivative over the past three hours, and month, day and interval index. Days are split into mid-day hours and dawn and dusk hours, each with its own models. A level network (two hidden layers of 4 and 8 tansig neurons, 3 softmax outputs) labels the coming harvest low (cloudy), medium (partially cloudy) or high (sunny). The network for that level and time of day then gives the mean (4 tansig neurons, 5 linear outputs) and the variance (4 tansig neurons, 5 softplus outputs) of harvest for each of the next five hours. The interval is the mean plus or minus one predicted standard deviation (z = 1). The allocator re-solves a one-day budget each hour: maximise the discounted sum of log utilities of the hourly allocations, subject to a battery balance, a minimum battery level and an end-of-day battery target. For the next five hours it uses the inverse Gaussian CDF of each forecast at the average accuracy index of the last five hours (the probability level at which recent actual harvest fell). It is solved with an iterative gradient projection method, and only the current hour's allocation is applied. | https://doi.org/10.1145/3606372
13 | C. Using the prediction | Robustness of predictive energy harvesting systems: analysis and adaptive prediction scaling | Defines a robustness metric for how much a scheduler's performance drops as forecast error grows, and compares three schedulers (duty-cycle adaptation DCA, LT-ENO and the optimal scheduler OPT) on outdoor and indoor solar traces. Then scales the forecast down by a factor learned online and keeps an energy reserve. Checked on a supercapacitor prototype under replayed indoor light. | With the optimal scheduler, EWMA forecasts with only 6 percent mean relative error cut the weekly energy used to 66 and 73 percent of the perfect-forecast case in the worst periods (2 years outdoors). The scheduler that was best with accurate forecasts was the least robust; LT-ENO was barely affected by forecast error. Scaling EWMA down raised the optimal scheduler's minimum daily used energy to 3.54 Wh on a 1-year trace (TX1), 13 percent above the same scheduler fed by Pro-Energy, the most accurate predictor tested (3.14 Wh). Indoors it raised the minimum hourly used energy 12.2 and 13.8 times. | Sits between any predictor and the scheduler. The forecast is multiplied by a factor c between 0 and 1: start at 1 minus the predictor's error measured on other sites (0.831 outdoors with EWMA, 16.9 percent MAPE). When stored energy falls below a reserve (10 percent of capacity outdoors, 20 percent indoors), lower c in steps of 0.05 and re-run the recent past until the reserve would have held. Raise c by 0.01 x the predictor's recent accuracy after each horizon with no such event. Tested on the optimal scheduler fed by EWMA outdoors (compared with unscaled EWMA, WCMA and Pro-Energy) and by EWMA or last-hour persistence indoors. | https://doi.org/10.1049/cdt2.12042
15 | C. Using the prediction | Energy-aware packet schedulers for battery-less LoRaWAN nodes | Simulates one battery-less LoRaWAN node in ns-3 and compares seven packet schedulers, from an energy-unaware sender to an oracle that knows future harvest, using 4 recorded indoor solar traces and capacitors from 2 mF up to about 110 mF. Preprint, not peer reviewed. | Across the 4 traces with a 5 byte payload, the energy-unaware sender sent 20 to 40 percent fewer packets than the oracle, and the fixed 1.82 V threshold about 10 percent fewer. Assuming zero harvest (CS) or averaging the last 5 s (AS-5) came out almost as good as the oracle; CS never let the node switch off and performed best in all scenarios. Performance rose with capacitance up to about 40 mF; with 2 mF, CS sent nothing. Only the brightest trace reached 100 percent of the duty-cycle limit; the others stayed at or below 75 percent. | Seven schedulers in three groups. Benchmarks: the Unaware Sender (US) sends every 4 s whatever the energy; the Optimal Sender (OS, oracle) knows the true harvest during the coming cycle. Energy-aware: the fixed-threshold sender (FS) sends only if the capacitor is above 1.82 V. Energy-modelling: the other four send only if stored energy, plus estimated harvest, can complete the whole transmit and receive cycle, with a threshold set by payload, spreading factor and ACK; they differ in the harvest estimate: zero (Conservative Sender, CS), the mean of the last x s (AS-x, x = 1, 5, 30 s), the minimum of the last 5 s (MinS), or a smoothed mean minus a smoothed deviation (AVES, g = 0.1). Node settings: capacitor size, SF7, 1 percent duty cycle. | https://arxiv.org/abs/2212.09453
16 | C. Using the prediction | Optimal energy-aware task scheduling for batteryless IoT devices | Solves task scheduling exactly, as a mathematical optimisation that maximises priority weighted completed tasks while keeping capacitor voltage inside its limits. Compared in simulation with InK, a scheduler that ignores energy, on a batteryless BLE smart building node with nRF52840 figures. | Completed 36 of 41 tasks against 21 for InK, a scheduler that ignores energy (5 mW harvest, 4.7 mF, 15 s run; InK had 3 power failures). Zero power failures at every harvest level, but only because future harvest is known perfectly; the authors say some failures would occur otherwise. The abstract says a look ahead of 8 tasks was enough. In the results, about 4 tasks (a 1 s window) was enough to maximise the number of tasks, and 8 tasks were needed before power hungry tasks ran. | A mixed integer linear program. The variables are binary start and run flags for each task at each 0.01 s step, plus the capacitor voltage at each step. The objective maximises priority weighted started tasks, and a started task must run to completion. Constraints: one task at a time, each task at most once, task order, arrival times and deadlines, and capacitor voltage held between its minimum and maximum using an exponential RC charging model (linearised with an extra variable). Inputs: current and duration per task, capacitor size, and the harvest power across a look ahead window, which is assumed to be known exactly. | https://doi.org/10.1109/TETC.2021.3086144
17 | C. Using the prediction | Energy-aware adaptive scheduling for battery-less 6TiSCH routers in industrial wireless sensor networks | A central manager next to the border router collects topology, timing, capacitor voltage and harvest power telemetry from each battery-less router, predicts each node's energy use and capacitor voltage 15 minutes ahead, and throttles the nodes that would run flat by skipping some of their receive slots, which also steers child nodes to other parents. | Simulation only. In a 20 node network (10 runs of 9 h with and without the algorithm, indoor solar at 200 to 800 uW), successful reporting rose from 77.49 to 90.19 percent and uptime from 78.64 to 91.10 percent, about 12.5 percentage points each, against the same network without the algorithm. Average latency rose 32.28 percent, from 474 ms to 627 ms. The extra telemetry, decision messages and DIOs cost each node 87.94 nW. | The manager predicts each node's traffic for the next 15 minutes from topology and timing telemetry, turns it into energy using per timeslot costs built from the platform's datasheet currents, and predicts the capacitor voltage 15 minutes ahead with a capacitor model that includes the power converter's efficiency and a constant leakage term. Harvest is assumed to carry on at its present value. A node's receive schedule is thinned until its predicted voltage clears a threshold Vth, sized so the energy between Vth and the turn off voltage covers one whole prediction interval with no harvest at all. It is relaxed once the prediction is above Von, sized so the energy between Von and Vth covers one network join. Inputs per node: measured voltage, measured harvest power, topology and timing telemetry, and per timeslot energy costs. | https://doi.org/10.1109/ACCESS.2024.3508540
18 | C. Using the prediction | Energy-aware task allocation for energy harvesting sensor networks | Allocates a task graph (tasks with an order to respect) across several solar harvesting nodes from a central manager, in simulation. Tasks are queued by latest start time, then each goes to the node and slot with the lowest cost: task length divided by that node's available energy. Harvest is predicted with AR-WCMA, and nodes stretch a task with DVFS when harvest falls short. | On small cases (3 to 4 nodes, 7 to 10 tasks), the heuristic reached up to 70 percent and a genetic algorithm up to 82 percent of the MILP solution, as the performance ratio in Fig. 9 (the paper does not define the ratio further). On larger cases it gave lower energy variance across nodes than E-CNPT (0.23 against 0.37 with 30 nodes and 15 tasks) at about the same schedule length, but the genetic algorithm was lower still (0.19). AR-WCMA had 8.7 percent average prediction error, against 23.6 percent for WCMA and 28.6 percent for ARMA. At 40 percent prediction error the dynamic stage cut the missing ratio from about 70 to about 27 percent (read from Fig. 12). | A central allocator. The cost of putting task m on node n in slot t is task length divided by that node's available energy (Eq. 17). The objective (Eq. 11) is a weighted sum (weights w1, w2, values not given) of the schedule length, meaning the latest finish time, and the total cost. Constraints: task order with a communication delay (Eq. 12), each task assigned once (Eq. 14), at most one task per node per slot (Eq. 15), and energy causality capped at storage capacity B (Eq. 16). A node whose available energy has reached capacity (A at or above B) gets a cost of zero (Eq. 20) and takes the first task in the queue at once. Harvest is predicted one slot ahead with AR-WCMA: an autoregressive estimate from today's slots, weighted by alpha, plus the past-days average for that slot scaled by a conditioning factor. On the node, when the prediction error passes a threshold and a task's energy would fall short, the task is slowed with DVFS and the tasks after it are delayed. It is dropped only if the frequency needed falls below the minimum. | https://doi.org/10.1186/s13638-015-0490-3
23 | C. Using the prediction | Power subsystem design and management for solar energy harvesting embedded systems (doctoral thesis) | Doctoral thesis in four parts: sizing the battery and panel from an astronomical solar model with one weather parameter; LT-ENO, a daily duty-cycle controller that rescales that model by the ratio of measured to modelled harvest over recent weeks and plans over the whole year; OPT, a weekly energy allocator that maximises the minimum energy used, proven optimal when harvest is known and guaranteed a minimum when given a conservative estimate; and a battery state-of-charge estimate from voltage and current. Tested in simulation on NSRDB data from 3 and 8 US sites over 11 years, and on two alpine GPS stations over two years. | Against EWMA and WCMA predictive duty cycling (Kansal et al.) and the reactive ENO-MAX, LT-ENO had no downtime at three US sites, raised average sustainable performance by up to 177 percent and cut duty-cycle variance by up to three orders of magnitude. OPT came within 9.9 percent (best) and 29.5 percent (worst) of a clairvoyant optimum in minimum energy used across 8 sites. WCMA, though more accurate than EWMA, gave no significant system gain under the same allocator: a better minimum on only 2 of 8 sites. The thesis still names better prediction accuracy as the main way to close the remaining gap to optimal. | The forecast is long-term: an astronomical clear-sky model for the site's latitude and panel angles, scaled by an environmental parameter for average weather and by the ratio of measured to modelled harvest over a recent window (63 days for LT-ENO, 52 weeks for OPT). OPT also scales it down in late winter and spring with a fixed weekly curve so it stays below the real harvest. LT-ENO sets tomorrow's duty cycle so the battery can bridge the whole winter deficit. OPT re-plans each week over a one-year horizon from the current battery level and applies only the first week's budget; a look-up table of about 500 values replaces the optimisation on the node. | https://doi.org/10.3929/ethz-a-010476716
24 | C. Using the prediction | An energy-aware task scheduler for energy-harvesting batteryless IoT devices | Built an energy-aware task scheduler for batteryless devices. Each task runs only once the capacitor voltage reaches a threshold worked out for that task from its measured current and duration, the capacitor size and the harvest current. Tasks have priorities, deadlines and parent-child dependencies, and state is saved to flash. Tested on a real nRF52840 node, first with an environment emulator, then with an AEM10941 power board and a solar panel under a lamp, against energy-unaware scheduling in the style of InK. | On the AEM10941 board (4.7 and 10 mF, 20 and 40 µA harvest, 5400 s runs), both energy-aware versions stayed on for all 5400 s with zero power failures. The energy-unaware versions had 5 to 18 power failures and were on for 901 to 2987 s. At 40 µA the best energy-aware version (no flash, voltage check every 1 s) completed more application cycles: 1096 against 946 at 4.7 mF, 1069 against 849 at 10 mF. At 20 µA the energy-unaware version without flash completed about three times more cycles (494 against 155 at 4.7 mF; 515 against 188 at 10 mF) despite its power failures. The thresholds used a harvest current known in advance. | No harvest prediction. Before each task the node reads its capacitor voltage and compares it with that task's required voltage, Vreq = (Vmin - Ih x ρ(Is) x (1 - e^(-ts / (ρ(Is) x C)))) / e^(-ts / (ρ(Is) x C)). Here Vmin is the lowest voltage the task may end at, Ih the harvest current, Is and ts the task's measured current and duration, and C the capacitance; the equation comes from Sabovic et al. 2020. If the voltage is below Vreq, the node sleeps and checks again. Ih can be 0 (worst case, highest threshold), known exactly, or predicted; the paper did not use prediction. The highest-priority task runs first, the earliest deadline breaks ties, and a task that can no longer meet its deadline is dropped. | https://doi.org/10.1109/JIOT.2022.3185321
25 | C. Using the prediction | Managing task execution for unknown workloads in batteryless IoT: a hardware-agnostic evaluation | Simulated a batteryless solar LoRa node that must decide every 30 s whether to transmit, when the energy of each transmission is unknown and changes. Proposed a reinforcement learning agent (PPO) and an Approximated Prediction (AP) method, and compared them with AsTAR, fixed voltage thresholds and a short-term oracle across capacitors from 0.5 to 10 F, driven by 45 days of real solar data from Iceland. Preprint, not peer reviewed. | Simulation only. No method was best on every measure. The short-term oracle, the optimised static threshold, a 1.9 V threshold and AP all passed 1,000 transmissions per 24 h from 1 to 1.5 F upward, but failed more often. A conservative 3.45 V threshold had no off time from 1 F upward, and the off-time RL agent from 2 F, both with fewer transmissions. The 1.9 V threshold, 0.1 V above the 1.8 V cut-off, struggled to stay alive from 0.5 to 5.5 F. AsTAR had the lowest average execution rate but, above 2.5 F, was the only method to keep sending at night. The authors conclude that above about 5.5 F static thresholds are enough, and small capacitors need dynamic methods. | No harvest forecast. Every 30 s each method decides to send a LoRa packet or sleep. Static threshold: send if capacitor voltage is at or above a fixed value. AsTAR: raise or cut the task rate to hold the voltage near a target. AP: from the voltage just before and after the last task, solve the RC capacitor equation for the load by Newton-Raphson, predict the voltage after the next task using the harvest current measured now, and send only if it stays above 1.8 V plus 1.5 V/A times the estimated task current; recalibrate after a failure or a large prediction error. RL: a PPO network trained offline in simulation, with capacitor size randomised, that sees the last 10 steps of voltage, harvest current, task duration and parameters, time since failure, capacitor size and stored energy. | https://arxiv.org/abs/2606.24340
26 | D. Reinforcement learning | ACES: automatic configuration of energy harvesting sensors with reinforcement learning | Table-based Q-learning picks the sleep time of indoor light-harvesting BLE nodes every 15 minutes, to send data as often as possible without the supercapacitor running flat. The policy is trained on a local server, in a simulator that replays each node's logged light, and the chosen action is sent to the node. Three training schemes: one-time (15 days of logged data), day-by-day (retrain every night on the data so far) and transfer learning (start from another node's table). Tested in simulation and in real deployments of up to 60 nodes in a university building. | One-time learning, 5 nodes, 31 days: 0 percent dead time. Average duty-cycle period ranged from 35 s (window) to 136 s (door), against 60 s for a battery node. Day-by-day learning from scratch, 5 nodes, 15 days: 2 of 5 nodes (conference room, door) depleted their supercapacitor in the first days, giving 4 percent dead time. Starting from a general table cut deaths in the first 3 days from 1 to 0 (conference room) and from 2 to 1 (door). 60-node, 2-week deployment: nodes stopped 0.1 percent of the time. PIR nodes caught 73 to 99 percent of the events that battery nodes caught. One-week simulation, average duty-cycle period excluding the door location: 71 s, against 100 to 112 s for three earlier RL methods and 107 s for a rule-based method. The paper reports this as 33 percent lower on average than the RL methods. No comparison with an optimal or oracle planner. | Table-based Q-learning with epsilon-greedy exploration. State: light (0 to 10, where 10 means 2000 lux or more), supercapacitor voltage (0 = 2.1 V to 10 = 5.5 V) and weekday or weekend. That makes 242 states. Action: one of 4 sleep times (15 s, 60 s, 300 s or 900 s). Reward: the action index (0 to 3) at each 15-minute step, and -300 if storage runs out (below 3 V in the simulator). The learned table, at most 25 kB, is looked up to pick the next sleep time. | https://doi.org/10.1145/3404191
27 | D. Reinforcement learning | Adaptive power management in solar energy harvesting sensor node using reinforcement learning | A table-based SARSA(λ) power manager picks the node's duty cycle each hour, so that the battery ends each day where it started (energy neutral operation). Simulation only: a scaled-up TMote Sky node with an ideal 40,000 mWh battery and a 6 W panel, driven by hourly solar radiation data from the Japanese Meteorological Agency. Trained on Tokyo 2010 and tested on Tokyo and Wakkanai 2011, including a halved battery, halved panel output and 2.5 times node power. | The baseline is an offline linear-programming policy (Kansal et al. 2007) that knows the day's harvest in advance, with its duty cycles rounded to the same 5 levels. The metric is the RMS of the end-of-day distance from energy neutrality, as a percentage of battery capacity. Over 2011: Tokyo 6.61 percent for SARSA against 5.70 percent offline; Wakkanai 7.17 against 5.94 percent. Over 30 days in Tokyo: offline 3.46, SARSA 5.27, offline with a 30-day window 10.47, constant duty cycle 19.44 and a battery-proportional rule 23.82 percent. With half the battery: 10.75 against 11.55 percent. With half the panel output or 2.5 times the node's power, after 1000 iterations of relearning: 1.62 percent against 3.03 and 5.12 percent, on one day each. Adding the weather class to the state lowered deviation (Fig. 7); no number given. | Table-based SARSA(λ) with eligibility traces and epsilon-greedy exploration. State: battery band (3), distance of the battery from the start-of-day target (40 bands, 1000 mWh apart), energy harvested this hour (7 bands) and the day's weather class (6 bands, from the day's total harvest). Action: duty cycle of 20, 40, 60, 80 or 100 percent for the next hour. Reward: given once at the end of each day. It is highest when the battery ends within ±1000 mWh of its start level, near zero out to ±5000 mWh, and -500 beyond. Q-table initialised high to encourage exploration. | https://doi.org/10.1145/3126495
28 | E. Context | A meta-analysis of solar forecasting based on skill score | Meta-analysis of deterministic solar forecasts that report a skill score (SS) on RMSE against persistence, smart persistence or a mix of smart persistence and climatology (ClimPer). Journal version: 2,068 unique records from Google Scholar and Web of Science, 500 full texts screened, 250 papers from 2006 to 2025 kept, giving 5,277 observations. SS was regressed on climate zone, horizon, six input types, model class, reference model, resolution, test and train length, forecast type and year: first with MARS splines, then with a linear regression for each horizon class. | Horizon dominates and decides which inputs and models help. Change in SS in percentage points against a time series baseline (intra-hour / intra-day / day-ahead, Table V): a single ML model 0.3 / -1.0 / -0.4, none significant; ensemble-hybrid +8.3 / +26.6 / +7.0. Inputs: NWP -4.8 / -4.0 / +11.5; historical data +6.2 / +5.8 / -10.2; local measurements 0.0 / +4.4 / +6.0; sky or satellite images +5.0 / +8.4; neighbour sites +5.5 / 0.0 / -6.4. Persistence as reference gives 14 to 22 pp higher SS than ClimPer. Arid zone B scored 5.2 pp above temperate zone C intra-hour. Preprint versions give other numbers but the same pattern. | Not a forecasting model. Skill score SS = 1 - RMSE of forecast / RMSE of reference; each reported SS is one observation. MARS fits piecewise linear hinge functions and pairwise interactions to find which study features change SS; it placed horizon breaks at 75 and 420 minutes. A linear regression is then fitted separately for intra-hour (up to 1 h), intra-day (1 to 6 h) and day-ahead (over 6 h). Each coefficient is the change in SS from that feature with the others held fixed. | https://doi.org/10.1063/5.0300682
29 | E. Context | Impact of dust on the performance of solar photovoltaic (PV) systems under United Arab Emirates weather conditions | Collected dust from PV panels on the University of Sharjah roof and characterised it (SEM, EDS, XRF). Indoors, sieved weighed dust onto a 5 W polycrystalline module under a 1000 W/m² lamp and traced I-V curves (3 trials, 20 steps up to 0.34 g, about 8 g/m²). Outdoors on the W12 building roof, exposed south-facing modules at 0°, 25° and 45°, each beside a clean reference module, and measured I-V weekly from 21 January to 5 July 2018. A glass slide beside the 25° module was weighed weekly for dust density. | Indoors, normalised maximum power fell linearly by 1.7 percent per g/m² (about 15 percent at 8 g/m²); Isc fell 8.78 percent and Voc 4.25 percent. After two weeks outdoors the efficiency drop against a clean module was 37.63 percent for the horizontal (0°) module, 14.11 percent at 25° and 10.95 percent at 45°. At 25° over more than 5 months, soiling loss rose from 0.29 to 12.7 percent as dust density rose from 0 to 5.44 g/m². It fell after rain and rose in sandstorms, and one May rain only cut dust from 4.32 to 3.36 g/m². Outdoor normalised power followed the indoor line within 4.5 percent. | No forecasting model. The result is an empirical straight line: normalised maximum power (P_dusty / P_clean) falls by 0.017 per g/m² of deposited dust. Outdoors, power soiling loss = (P_clean - P_dusty) / P_clean and efficiency drop = (E_clean - E_dirty) / E_clean, with E = I_mpp x V_mpp / (G x A) from the measured irradiance G and module area A. The authors propose the line for predicting soiling loss in the UAE. | https://doi.org/10.1016/j.renene.2019.04.004

Sheet: Implementation details
# | Paper | What was measured, and on what hardware | Sampling and time slots | Inputs the model uses | Parameters and their values | Output | How it runs, step by step | What must be stored, and cost | Not stated in the paper | To use it on our nodes (our analysis) | Read from
2 | WCMA (Recas Piorno et al., 2009) | Energy available from a PowerFilm solar panel (OEM component, model not given), recorded every minute for 45 consecutive days. The measuring circuit, panel size, site and dates are not given. Their own recording, not a weather station. A Shimmer structural health monitoring node (supercapacitor storage, solar panel, ZigBee-compatible radio, DSP, 16 PZTs giving 240 paths) is the case study for the energy management test. The paper does not say whether that test ran on a Shimmer or was calculated from its task power figures, or whether the 45 days of panel data came from a Shimmer. | 1 min raw readings 30 min slots, 48 per day, chosen from experiments on real sensor nodes as a trade-off between accuracy, wake-ups and memory How minute readings become a slot value: not stated Units vary: mW in Table I, J per 30 min slot in Table II | E(d,n): energy in today's last slot Today's last K slots The same slots, and slot n+1, on each of the past D days No weather or other external data | alpha = 0.7: weight on the last measured slot D = 4: past days kept K = 3: recent slots used for GAP N = 48: slots per day (30 min) alpha, D and K chosen by sweeping values on the same 45 days the 9.8 percent was reported on; no separate test set alpha: Fig. 2 sweep (K = 6, N = 48, D axis 2 to 6); 0.7 gave the lowest error whatever D D and K: Fig. 3 sweep (alpha = 0.7, N = 48, D axis 2 to 8, K axis 0 to 30) N: chosen from experiments on real sensor nodes; no sweep shown EWMA baseline settings: not stated | Energy in the next 30 min slot, E(d,n+1), recomputed every slot A single value, no range | 1. M(n+1) = plain average of slot n+1 over the past D days (Eq. 3) 2. For k = 1 to K: v_k = E(d, n-K+k) / M(n-K+k), today against normal (as in the Table I worked example; printed Eq. 4 has n-K+k-1) 3. p_k = k / K, so newer slots count more 4. GAP = sum(v_k x p_k) / sum(p_k) 5. Forecast = alpha x E(d,n) + (1 - alpha) x GAP x M(n+1) 6. Each measured slot is stored in the D x N matrix, and M always uses days d-1 to d-D; the update step itself is not written out Worked example (Table I, D = 4, K = 3, mW): V = 1.12, 0.84, 0.75; P = 0.33, 0.67, 1.00; GAP = 0.84; forecast = 0.7 x 230 + 0.84 x (1 - 0.7) x 313 | A D x N matrix (4 x 48 = 192 values) plus today's slots Memory and compute cost not measured. The paper only calls WCMA 'very low overhead' and says using fewer days lowers its computational cost | How minute readings are combined into a slot What to do at night, when M = 0 (division by zero) What to do before K slots or D days exist The printed Eq. 4 has an index off by one; the paper's own worked example (Table I) uses the form in step 2 Night samples under 10% of the maximum are left out of the error, but which maximum is not defined EWMA baseline settings Site, dates, season, panel model, size and tilt, measuring circuit A separate test set: settings were tuned on the same 45 days used for the 9.8 percent The energy manager's exact allocation rule, supercapacitor size and starting charge Memory and run time on a node | Needs harvested energy per 30 min slot for each node. Our board can't read panel power yet, so either estimate it from the supercap voltage change plus the known load, or add a current sensor. | Full text (author copy on EPFL Infoscience, record 134722; same text as the twiki.di.uniroma1.it copy)
3 | WCMA evaluation (Ali et al., 2010) | No node measurement Public NREL MIDC solar irradiance from 6 of 10 available US sites: SPMD (CO), ECSU (NC), ORNL (TN), HSU (CA), NPCS (NV), PFCI (AZ), 365 days each Used directly as the solar power signal; no panel or conversion model is described An MSP430F1611 (3 V, 5 MHz) on an MSP-TS430PM64 test board, code built with Code Composer Essentials 3.2, was used only to measure the energy of an ADC reading and a prediction | 5 min raw data at 2 sites (SPMD, ECSU), 1 min at the other 4 Slots per day tested: 288, 96, 72, 48, 24 (5, 15, 20, 30 and 60 minute slots); the slot length is the prediction horizon 288 slots not defined for the two 5 minute sites The predictor uses the reading at the start of each slot, and is scored against the slot's mean power Days 21 to 365 are scored, so a 20 day history exists for every D Only samples at least 10% of the peak value are scored, which leaves out night and the low start and end of the day | Same as WCMA: the reading at the start of the current slot n, today's last K slot readings, and the D x N table of the same slots on past days No other inputs (Eq. 1 to 5) | N (slots per day): 288, 96, 72, 48, 24 tested; more slots per day was always more accurate alpha (weight on the latest reading): 0 to 1 tested; tuned values 0.5 to 0.7 at 24 slots, 0.6 to 0.7 at 48, 0.6 to 0.8 at 72, 0.7 to 0.8 at 96, 0.9 to 1 at 288 alpha guideline: 0.7 to 0.8 for 48 to 96 slots, 0.5 to 0.6 at 24, about 1 at 288 D (past days): 2 to 20 tested; tuned value 18 to 20 at 48 slots and above, 10 to 20 at 24; guideline 10 to 11 days K (recent slots): 1 to 6 tested; tuned value 1 to 5; guideline K = 2, which added at most 0.30 points of MAPE Tuned per site and per N by searching these ranges for the lowest MAPE on the same days that are scored (days 21 to 365); no held-out test data is described | Predicted power at the start of the next slot, in the units of the input data (units not stated) Multiplied by the slot length, it is used as the energy of the slot whose start reading was just taken, and scored against that slot's mean power One value per slot; no range or uncertainty | 1. At the start of slot n, sample the power 2. For each of the last K slots, divide today's reading by the mean of that slot over the past D days 3. Average those K ratios with weights k/K (weight 1 on the latest slot) to get the brightness factor 4. Take the mean of slot n+1 over the past D days 5. Prediction = alpha x the current reading + (1 - alpha) x that mean x the brightness factor On the MSP430: a timer wakes the chip, the voltage reference is switched on and left 45 ms to settle, one ADC reading is taken (a few microseconds), the reference is switched off, the prediction runs, and the chip sleeps again | D x N table of past slot readings plus today's readings; memory not quantified Measured on an MSP430F1611 at 3 V and 5 MHz: 55 uJ per ADC reading; with the prediction 58.6 uJ (K = 1, alpha 0.7), 63.4 uJ (K = 7, alpha 0.7) and 61.5 uJ (K = 7, alpha 0) So the prediction adds 4 to 9 uJ; 5 uJ taken as typical 48 readings and predictions a day at 60 uJ = 2,880 uJ, 0.8% of the 356 mJ a day used in sleep at 1.4 uA 288 a day = 17.28 mJ, 4.85% of sleep energy; 1.62% at 96, 1.21% at 72, 0.40% at 24 The ADC reading, not the prediction, dominates the cost | Which irradiance component was used, and which year Units of the power values How irradiance would become panel power Step size of the alpha search (all reported values are multiples of 0.1) Whether alpha and D were retuned for the K = 2 results Which peak sets the 10% night cut-off How the predictor handles night, when the past-day means it divides by are zero How the history table is updated How missing data was handled Memory use, code size and run time How the MSP430 energy was measured | Can run on public irradiance for Sharjah (Open-Meteo or NSRDB) before our own data exists, then have D, K and alpha retuned on our nodes' data. | Full text (EPFL Infoscience, author copy of the DATE 2010 paper)
4 | Pro-Energy (Cammarano et al., 2012) | TelosB nodes with solar cells, logging harvested energy every 30 s: 10 nodes at windows of a Rome university building (inside and outside, in offices facing west, east and south) for 46 days, 3 to 220 J per day. Also TelosB nodes with micro wind turbines outdoors in Bologna (75 days) and 90 days of NREL Oak Ridge solar and wind data at 1 min. The circuit appears only in the 2016 journal version: POW112D2P panel (7 x 5.5 cm, 450 mW typical peak), 50 F Panasonic Gold supercaps or Duracell NiMH 2450 mAh batteries, MPPT, TPS63001 DC/DC converter. Panel and supercap voltages are read on two ADC inputs, and a lookup table turns panel voltage into power. The 2016 version puts its Rome motes outdoors on the department roof terrace, not at windows; the same board photo appears in both papers. The 2016 version also converts NREL irradiance and wind speed to power (cell 22 x 7 mm² at 17 percent efficiency; 5 cm rotor with Cp 1.5 percent). | 30 s raw (their nodes), 1 min (NREL) Energy per 30 min slot, N = 48 per day Forecasts made once per slot How readings are summed into a slot: not stated (Fig. 1 plots 30 min average power) 2016 version: forecasts requested every 5 min for windows of 5 to 120 min, built from slot power x slot length | Energy in today's last K slots The last slot's energy, C_t A pool of D stored day profiles (whole days of slot energies) No weather data or other outside input | N = 48 slots per day D = 9 to 18 stored days in the best settings (10 in the cost table, 20 in the 2016 memory example) K = 1 to 6 slots used to find the matching day (7 in the cost table); tested 1 to 10, changes MAPE by about 0.5 points at most alpha = 0.40 to 0.60 (0.50 at 30 min); tested 0.40 to 0.85 G = 5 to 7: for how many slots ahead the latest reading still counts (not used at 30 min) P = 9 profiles blended at every horizon except 1 h 30 min (7); tested 1 to 10 F = 1 to 6 slots ahead Best values per horizon (alpha, D, K, G, P): 30 min 0.50, 14, 2, -, 9; 1 h 0.40, 14, 2, 5, 9; 1 h 30 min 0.45, 9, 6, 5, 7; 2 h 0.45, 14, 1, 6, 9; 2 h 30 min 0.60, 14, 3, 6, 9; 3 h 0.55, 18, 3, 7, 9 A (maximum profile age, called x in 2016) and the duplicate threshold (Ts in 2016): not given All tuned to minimise MAPE on the same traces used to score them, reported for Rome solar only | Energy in each of the next F slots (30 min to 3 h ahead), recomputed every slot A single value per slot, with no uncertainty range | 1. At each slot, for each stored day: mean absolute difference from today over the last K slots 2. Take the closest day, or the P closest: WP(t + i) = 1/(P - 1) x sum of w_j x profile_j(t + i), with w_j = 1 - (its error / total error of the P days) 3. gamma_i = alpha x (1 - (i - 1) / G) for i up to G, otherwise 0 4. Forecast(t + i) = gamma_i x C_t + (1 - gamma_i) x profile(t + i), for i = 1 to F 5. At the end of the day: replace any profile stored more than A days ago with today; if two stored days are near duplicates (mean absolute difference over the whole day below a threshold), replace the one more like today; with several such pairs, use the pair most like today | D x N profile table (for example 10 x 48), today's N slot values, and the age of each profile 2012 cost, multiplications over the whole Rome solar dataset (D = 10, K = 7, F = 1): 4,369 with one profile, 12,917 with two, 17,047 with three, 21,081 with four, 25,019 with five; WCMA 27,931; EWMA 4,416 2016 cost, average per day at N = 48: 1,083 multiplications and 2,592 bytes (WCMA 335 and 1,732; EWMA 94 and 96) 2016: with 16-bit samples, N = 48 and D = 20 the profile table takes about 2 KB, 20 to 50 percent of TelosB or Mica2/MicaZ RAM 2016: running the predictor on a TelosB cost about 3 J per day at N = 48 | Values of A, the duplicate threshold, and the correlation threshold behind G How the pool is filled at the start, and whether forecasting waits until it is full What happens in the first K slots of a day, and where the day starts What the predictor does at night (the MAPE simply leaves out slots below 10 percent of the day's peak) Which end-of-day rule wins when both apply How the parameter search was run Parameter values for the wind and Oak Ridge data How 30 s readings become slot energy The 2012 index ranges are off by one (Eq. 1 sums K + 1 slots, Eq. 4 starts at j = 0); the 2016 version corrects both | Needs a stored pool of each node's own past days, so it only becomes usable after one to two weeks of logging. | Full text of the 2012 paper (author copy), plus the 2016 IEEE Sensors Journal version (Online energy harvesting prediction in environmentally powered wireless sensor networks, 16(17), 6793 to 6804, https://doi.org/10.1109/JSEN.2016.2587220) for the hardware, memory and energy cost
5 | UD-WCMA (Dehwah et al., 2017) | Simulation: solar irradiance (W/m2) every 30 min from an unnamed weather station, 6 reference days and 6 test days, plus a year of 1 h data from the KAUST meteorological station. Hardware: 10 nodes over 6 months, part of a traffic and flash flood monitoring network, each with a 32-bit ARM Cortex-M4 (168 MHz, adjustable down to 8 MHz, 192 kB RAM), a 20 Wp / 20.8 Voc panel, a single-cell 10 Ah LiFePO4 battery, MPPT, a DS2745 battery monitor (current, voltage, battery temperature) and an MP2635 charger with power path management. On the nodes the model ran on the panel's output current in mA, recorded every 30 min; the part that measured it is not named. | 30 min slots, 48 per day; 1 h for the year-long test Whether each value is a single reading or an average: not stated Works directly on current or irradiance, with no conversion to energy | Today's last K values (for GAP, the similar-day match and sigma2) The d stored day profiles at those slots (for GAP and the match) and at slots n and n+1 (for mu, sigma and sigma1) | d = 6 stored day profiles, picked to cover low, medium and high levels with smooth and abrupt changes; no update rule given K = 4 recent slots at 30 min (1 to 6 stated as tested, 2 to 6 plotted; improvement insignificant from 4) Year-long 1 h test: 6 reference profiles and a 2 h comparison window G1, G2 and G: recomputed every slot from standard deviations, never tuned; G1 and G2 each carry a fixed factor of 0.5 GAP weights p = [1/K, ..., k/K, ..., 1], heaviest on the latest slot No pre-calibration Baselines were each given their best alpha from 0.2 to 0.8 after the fact, per test day; in the year-long test they ran at alpha = 0.3, 0.5 and 0.7 | The next slot, 30 min ahead, in the input's units (W/m2 or mA). 30 min to 3 h were evaluated, but how multi-step forecasts are made is not stated. | 1. mu(n+1) = average of slot n+1 over the d profiles 2. GAP = weighted ratio of today's last K slots to the profile averages, weights k/K so the latest slot counts most, as in WCMA 3. Most similar profile i* = smallest mean absolute difference over the last K slots 4. sigma = standard deviation of the profiles at slot n+1 5. sigma1 = standard deviation, across profiles, of the change from slot n to n+1 6. G1 = 0.5 x sigma / (sigma + sigma1) 7. sigma2 = standard deviation of today's last K - 1 slot-to-slot changes 8. G2 = 0.5 x sigma / (sigma + sigma2), and G = G1 + G2 9. Forecast = G1 x [G x today(n) + (1 - G) x profile_i*(n+1)] + (1 - G1) x GAP x mu(n+1) | 6 x 48 profile table, kept on a micro SD card and read during each prediction, plus today's values Runs in 1 ms on the Cortex-M4 Each node predicts for itself, because sending the data to a central node would cost more energy, and sends the prediction to a sink connected to a database | An exact procedure for choosing the 6 profiles (only the aim is given), and how to refresh them What to do at night, when the standard deviations are 0 (0/0) and the profile average in GAP is 0 What to do before K slots exist today The error formulas (relative error in percent, MAE and RMSE are named but not defined) How multi-step forecasts (1 to 3 h) are made Which part measured panel current Over how many days and nodes the 18.79 mA RMSE was computed (the figure shows one day) Where and when the 30 min reference and test days were recorded, and which year the KAUST data covers | No tuning, which suits five nodes, but each node needs 6 representative days first, and we would have to write our own rule for refreshing them. | Full text (KAUST repository accepted manuscript)
11 | Cloudy computing (Sharma et al., 2010) | Their own rig on the roof of the Computer Science Building, UMass Amherst: Kyocera 65 W panel (17.4 V), Air-X wind turbine rated 400 W at 28 mph, 1,260 Wh deep-cycle battery, TriStar T-60 charge controller, and a second T-60 with a 60 W automotive bulb that bleeds the battery (on at 13.6 V, off at 12.1 V) so it never fills. A HOBO U30 logger recorded battery voltage and each source's current through a current transducer. A weather station gave solar radiation and wind speed. Sky cover observations and forecasts (National Weather Service, National Digital Forecast Database) were for Chicopee Falls, the closest NWS site, 20 miles away. The panel had run only about 4 months, so the clear day curves were built from the weather station's 2008 radiation, converted to panel power. | Logger: a reading every 30 s, stored as 5 min averages, uploaded hourly Weather station: every 5 min Weather service: observations hourly; forecasts issued every 3 h, with values every 3 h from +3 to +72 h One prediction per 3 h forecast interval Case studies: one decision per day (24 h leases; sensing rates recomputed every 24 h) | Forecast cloud cover (%) for the target 3 h interval The month The time of day (hours after midnight) For wind: forecast wind speed (mph) Nothing from the node's own recent history | Radiation to panel power: P = 0.0444 x radiation - 2.65 (W, W/m²) Clear-day curve per month: MaxPower = a x (Time + b)^2 + c, Time in hours after midnight, with 12 fitted (a, b, c) sets, for example January (-1.15, -12.75, 21.45) and June (-1.1, -13.5, 43.4) Wind: P = 0.01787485 x windspeed^3 - 3.4013 (W, mph); the turbine produces power only above 7 mph, and the function ramps down to 0 near 28 mph where the turbine stops alpha: a correction per forecast horizon, based on the forecast RMSE at that horizon, smaller when forecasts are less reliable; values not given | Power (W) for each 3 h interval from +3 to +72 h. The paper calls this an energy prediction but does not state how power is converted to energy. | 1. Fit a straight line from measured radiation to panel power 2. For each month, fit the quadratic clear-day curve to one cloudless day 3. Solar forecast = alpha(horizon) x MaxPower(month, time of day) x (1 - cloud cover) 4. Wind forecast = alpha(horizon) x wind formula(forecast wind speed) 5. Testbed case study: accept a 24 h lease only if battery energy plus forecast harvest covers the load at every point of the lease. Fair-rate case study: recompute rates every 24 h with Fan et al.'s algorithm | Table I: 12 x 3 coefficients (a, b, c per month). The radiation to power line (only needed to build the table). The wind cubic. One alpha per forecast horizon (values not given; whether solar and wind use separate alphas is not stated). Compute and memory are not stated. | The alpha values, and the rule that turns forecast RMSE into alpha Whether night values are clipped at 0 Time zone and daylight saving handling How 3 h forecasts map onto finer scheduling The weather station model The RMSE formula (the procedure is described only in words) Any error figure for the harvest prediction itself (Fig. 6 is a plot only) The length of the simulated periods, and which forecast dates drove the case studies The window used for the history-based (PPF) baseline in the case studies | The easiest model to reuse: a clear-day curve for Sharjah per month (from pvlib or our own sunny days), times (1 - Open-Meteo cloud cover), times a per-node factor learned from what each panel actually harvests. | Full text (two UMass author copies, lass.cs.umass.edu and ecs.umass.edu/irwin; they differ in a few sentences)
19 | EWMA and energy-neutral operation (Kansal et al., 2007) | Heliomote solar harvesting node with NiMH battery storage, measuring solar panel current and voltage and battery flows. Load: Mica2 mote at a fixed 40 percent duty cycle. Deployed in a residential area of Los Angeles, June to August 2005, 67 days. A separate 9-day solar trace gave the harvest model: average 23.6 mW, burst bounds 1.4639 x 10^3 J and 1.8566 x 10^3 J (Table I). | Battery voltage and net solar current sampled every 10 s. Prediction slots of 30 minutes over a 24 hour window: Nw = 48. | Energy harvested in each slot, measured at the end of the slot. No weather or other external inputs. | Weight alpha = 0.5 on the stored average (1 - alpha on the new value), chosen as the minimum-error value from a sweep of 0.1 to 1 (Fig 7). Slot length 30 minutes, 48 slots. For duty cycling: Dmin 0.05 to 0.4, Dmax 0.7, battery efficiency 0.5 to 1 (0.7 for NiMH). | Predicted harvested energy (power) for each of the 48 slots of the next 24 hours. Used to set a duty cycle for every slot. | 1. At the end of each slot, update that slot's stored value: x_avg = alpha x x_avg + (1 - alpha) x x_measured. 2. Use the 48 stored values as the forecast for the next day. 3. Allocate duty cycles: Dmax in sun slots, Dmin in dark slots, then add or remove energy by sorting slots by cost (no LP solver needed). 4. After each slot, compare actual with predicted harvest and move the surplus or shortfall into future slots (Algorithm 1). | One stored value per slot: a vector of 48 values. One multiply and add per slot for the predictor. The allocation needs simple arithmetic and one sort. Memory in bytes and run time on the node: not stated. | Exact definition of the prediction error in Figs 7 and 10 (Fig 7 in mA, Fig 10 in mW). Which days were used to choose alpha. Initial values of the slot averages. Comparison with any other predictor. Behaviour during runs of cloudy days. Results with a supercapacitor (leakage is ignored in the analysis). Code size and execution time. | The cheapest baseline for the server: one stored value per 30 min slot per node, updated from the harvest each node reports. It is the floor our clear sky baseline has to beat. | Full text, ACM TECS 6(4) Article 32 (2007): Sections 1, 2.1, 3.1, 3.2, 4.1 to 4.4 and 7; Figures 2, 7, 10 and 11; Tables I and II. Priority checked against DAC 2006 Section 3.
7 | EMD + LSTM (Ge et al., 2019) | Nothing measured on a node, and no hardware. Hourly global horizontal solar radiation (Wh/m2) from the US National Solar Radiation Database, which is modelled data, for 3 sites (one each in Michigan, Alabama and Nevada; stations not named) and 3 years (1999, 2004, 2008). All code in Python; the computer used is not stated. | 1 h values, '8760 or 8764' records per year, night zeros kept 1 h ahead: about 6988 training and 1747 test records per site and year A separate test on daily totals (365 or 366 per year) Time-of-day MAPE test on 7 am to 5 pm only Pro version test: 30 randomly chosen days, Alabama only | Past radiation only, with no weather or calendar inputs, although the database also holds meteorological data 1 h ahead: the previous 24 hourly values 6 h ahead: the 24 values from 30 to 7 hours before EMD splits the series into components (10 in the Alabama 2008 example) plus a residual, each modelled on its own The 'Pro' version trains only on days in the K-means cluster that matches today's first 16 hours | 2 LSTM layers + 1 dense layer; units per layer not given 200 epochs (chosen because it 'can achieve relatively low RMSE'); '300 iterations' (meaning not given) RMSprop optimizer; learning rate, batch size, loss and activation functions not given MinMax scaling to 0..1 80/20 train/test split (split rate 0.8) K-means: 10 clusters, Euclidean distance on 24-hour day vectors; random initial centroids Negative forecasts set to 0 Baselines EWMA and WCMA: D = 4, K = 3, alpha = 0.7 | Hourly global horizontal radiation (Wh/m2) at +1, +2, +6, +12 and +24 h Separately, daily totals (horizon not stated in the experiment; the conclusion calls it one day ahead) Scored by RMSE; MAPE only for the time-of-day test | 1. Clean the hourly series and scale it to 0..1 2. Split 80/20 into training and test records; each record is a target hour and 24 earlier values 3. (Pro version only) cluster the year's days into 10 groups and train on the group that matches today's first 16 hours 4. EMD: split the series into components and a residual 5. Train one LSTM per component 6. Predict each component, add them up and set negatives to 0 The text lists clean, normalise, split, build network; Figure 2 puts profile selection before EMD. Where EMD sits relative to scaling and splitting is not stated No retraining or online updating is described | One LSTM per EMD component (about 10, plus a residual) for each site and year, plus a single LSTM for comparison, written in Python. Model size, memory, hardware and training time not given. The authors say training on similar-profile days should improve convergence and reduce computation time, but report no timings. | Most network settings (units, learning rate, batch size, loss, activations, software library) Whether the split is by time or random Whether EMD ran on the whole series before splitting (Figure 5 shows a whole year decomposed); if so, future data leaked into training (our inference) Windows for the 2, 12 and 24 h forecasts and for the daily totals Which stations Whether EWMA and WCMA were scored on the same test period as the LSTMs Site, year and horizon of the time-of-day MAPE table (Table 7) How a 16-hour partial day is matched to 24-hour cluster centres, and whether test days were left out of the clustering Their Table 9 'EMD-LSTM-Truncated' values (49.24, 37.70, 50.45) are Table 4's LSTM-Truncated values for Alabama; against Table 4's EMD-LSTM-Truncated values (45.89, 34.61, 43.78) the Pro version (47.34, 36.29, 45.18) is not better, so its gain is doubtful (our inference) The text's gain ranges over EWMA (25.0 to 44.3 percent) and WCMA (29.0 to 48.7 percent) match Tables 4 to 6 only with the two swapped (our check) | Would run on the server using public Sharjah radiation history. It forecasts sky radiation, not what a given panel harvests, so it still needs a per-node conversion. | Full text (MDPI publisher PDF)
8 | Tree models on an ESP32 (Khamitov et al., 2024) | Their own prototype on an indoor windowsill, panel tilted 45 degrees facing west, with direct sun in the room only after about 13:30 to 14:00: 110 x 80 mm panel, TP4056 charger, 2,500 mAh 3.7 V Li-ion battery, GY-49 MAX44009 light sensor (lux, aligned with the panel), INA219 current sensor between the TP4056 positive pin and the battery positive pin, and an ESP32. The paper says the INA219 measures the current flowing from the panel. It sits on the battery side of the charger, and the target includes negative values from passive battery discharge. The charger stops at 4.2 V, which gave false zeros. They discharged the battery periodically when it was full and filtered these points out. Field test: a second copy without the current sensor, placed next to the first. | Lux, current and voltage every 1 min for 100 days from 8 October 2023 (sunny, cloudy, rainy and snowy days) Cut into 6 sub-datasets with wake-up gaps of 30 min, 1, 2, 3, 4 and 5 h How the minute readings are integrated into energy: not stated How wake-up pairs are drawn from the minute data (step, overlap): not stated Field test: 1 h wake-ups, 20 to 25 January | Lux at the previous wake-up (prev_lux) Lux at this wake-up (lux) Time of day at both wake-ups, as normalised sine and cosine (time_sin, time_cos, prev_time_sin, prev_time_cos) No weather or position data Target: energy in mWh accumulated over the gap between wake-ups; it can be zero or negative when the battery passively discharges | Random forest (scikit-learn RandomForestRegressor, chosen on 1 h data): 5 trees, max depth 10, at least 5 samples per leaf (searched 5 or 10 trees, depth 5, 10 or 15, leaf 5 or 10) LightGBM (LGBMRegressor): boosters tried were random forest, plain gradient boosting and DART; plain gradient boosting trees chosen XGBoost (XGBRegressor): plain gradient boosting and DART tried; plain gradient boosting trees chosen Other boosting settings: not given Neural network (MLP): 2 hidden layers of 16, ReLU, 100 epochs; layers, neurons, activation and optimiser were tuned, but the chosen optimiser and the search ranges are not given Quantile regression baseline (scikit-learn QuantileRegressor): quantiles 0.25, 0.5 and 0.75 tried; the median was best | Energy (mWh) accumulated over the gap that just ended, once per wake-up. In the paper's words, the model 'predicts the stored energy throughout the last sleep-time period'. It estimates the past interval; it does not forecast the next one. | 1. Log lux, current and voltage every minute 2. Drop charger cut-off zeros and outliers 3. For each gap length, pair wake-ups, build features from both ends and compute the energy in mWh between them 4. Train and tune on a computer (cross-validation shown for random forest on 1 h data) 5. Convert the tree models to Python code (m2cgen) and the network to TensorFlow Lite, and load them on the ESP32 6. At each wake-up, read lux and time, combine them with the stored previous reading, and output the energy of the gap just ended No learning on the device | The device keeps the previous lux reading and time. Model code (m2cgen Python output, average over the six datasets): random forest about 501 kB, LightGBM about 460 kB, XGBoost about 584 kB. The chosen random forest on 1 h data was 449 kB; the grid ranged from 19 kB (depth 5) to 3,945 kB (10 trees, depth 15). Neural network size, run time and energy on the ESP32 not given. | How energy was integrated from the minute readings How outliers were removed How wake-up pairs were sampled from the minute data, and how many samples each sub-dataset has Train/test split behind Tables II and III; cross-validation folds, and whether they respect time order Boosting settings (learning rate, number of trees) and network optimiser and batch size Which city (the paper only says 'city of the deployment') Run time, memory use and energy per prediction on the ESP32; size of the neural network Their dataset link (https://py-client-sub.herokuapp.com/csv) returned HTTP 503 (Heroku application error) when checked on 21 September 2026 Their text quotes the 1 h MSE values of LightGBM and XGBoost (30.96 and 29.67) as 30 min sMAPE; Table II gives 21.49 and 22.18 percent The abstract pairs the field-test scores the other way round from Table IV (Table IV: LightGBM 16.67, random forest 16.56 percent) | Suggests a cheap harvest sensor for us: a light sensor plus a trained model, instead of a current sensor on every node. Training it still needs a period of real current measurements, which a PPK2 in ampere-meter mode can log. It estimates the interval that just ended, not the next one, and our nodes have no light sensor yet. | Full text (authors' copy on ResearchGate; abstract matches the published version)
20 | Weather forecasts plus ML (Sharma et al., 2011) | A weather station on the roof of the Computer Science Building, UMass Amherst, reporting solar intensity (W/m²). No solar panel measured: solar intensity is used as a proxy for generation, citing their earlier finding that panel power is proportional to it. Forecasts: NWS historical textual forecasts for Amherst from weather.gov. Weather station model not stated. | Weather station: every 5 min NWS forecasts: hourly values from +1 h to +6 days Models use the forecast from 3 h earlier (t - 3) for the target time t Only noon predictions are evaluated Data: 10 months from January 2010 | Forecast temperature (°F) Forecast dew point (unit not stated) Forecast wind speed (mph) Forecast sky cover (%) Forecast chance of precipitation (%) Forecast relative humidity (%) Day of year (0 to 365) All normalised to zero mean and unit variance No past solar measurements as inputs | Linear least squares: 1.18 x Day + 77.9 x Temp + 33.11 x DewPoint + 22.8 x WindSpeed - 96.9 x SkyCover - 49.15 x Precipitation - 43.4 x Humidity (intercept not given) SVM (LibSVM) kernels tried: linear, polynomial, RBF RBF from the LibSVM grid search: cost = 256, gamma = 0.015625, epsilon = 0.001953125 PCA: first 4 principal components (highest eigenvalues) | Solar intensity (W/m²) at noon, 3 hours ahead. Used as a proxy for panel power; no conversion to W or J is given. | 1. Collect NWS forecasts and weather station solar intensity 2. Pair each noon reading with the forecast made 3 h earlier 3. Normalise all inputs to zero mean and unit variance 4. Train on January to August 2010: least squares; SVM with linear, polynomial and RBF kernels (RBF settings by grid search) 5. Reduce the inputs to 4 principal components and retrain the RBF SVM 6. Test on September and October 2010 against the sky cover model and the previous-day baseline | Not stated in the paper. The linear model is 7 coefficients. The SVM uses LibSVM; the number of support vectors, memory and training time are not stated. | Intercept of the linear model Number of training and test samples (the test plots show 52 points) Cross validation scheme (folds) Whether the linear and polynomial kernel errors (201, 228) are cross validation or test errors Polynomial kernel degree, and settings for the linear and polynomial kernels How the sky cover baseline's clear-sky maximum was computed for this site and period Forecast issue times used Results at other times of day or other horizons Any panel power or energy result Compute, memory and training time | The same idea as our ML challenger: weather forecast inputs, trained on each site's measured output. For us the labels would be each node's measured harvest from the uplinks, and the forecasts would come from a weather API on the server. Their test covers noon only, 3 h ahead, at one site. | Full text (UMass author PDF, ecs.umass.edu/irwin)
21 | Online ML for indoor PV (Kraemer et al., 2023) | Indoor PV power traces from the public Sigrist et al. data set, 961 days from 2017 to 2020 L14 'Window': lab, wall mounted at 2.1 m, strong natural light, direct morning sun; mean 140 µW L17 'Curtain': office, wall mounted at 2.4 m, natural light, no direct sun, curtain sometimes blocks the window L18 'Hallway': wall mounted at 2.2 m, no natural light, weak indirect artificial light; mean 3.1 µW Observed radiation: MeteoSwiss station Zürich Fluntern, about 1 km away Forecast radiation: MeteoSwiss COSMO-1, computed retroactively for the building coordinates PV cell type and harvesting circuit: not stated | 24 hourly slots per day; each slot is the average power in that hour One prediction run at midnight for all 24 slots of the next day Weather forecasts issued 8 times a day, every 3 hours from midnight; only those available at or before midnight used Raw sampling rate of the data set: not stated | power_lag24: power in the same hour the day before workday: 1 or 0 dayofweek: 0 (Monday) to 6 (Sunday) timecount: hour slot 0 to 23 elevation and azimuth of the sun radiation_forecast: forecast downward shortwave radiation flux at the surface radiation_observation: measured radiation, used only as an upper bound (not available at prediction time) Cloud cover at several levels also tried, results not reported | Training window t_max: 10 and 30 days (Table 2); 1 to 100 days (Fig. 7) Table 2 forest: 40 trees, unlimited depth (deepest tree observed 31) Sweep for L14 with t_max 10: 1 to 40 trees, depth 1 to 6; depth 2 already close to best; depth 4 with 5 trees a good trade-off (STAPE 25.8, SMAPE 38.9 in Fig. 8) EWMA of daily mean power for scaling the metrics: alpha 0.095 (mainly the last 20 days) Other hyperparameters: not stated | Average harvested power (µW) for each of the 24 hours of the next day Point forecast, no uncertainty | 1. At midnight of day d, take all hourly rows from the last t_max days 2. Build the features, using the radiation forecast available before midnight 3. Train a new random forest 4. Predict the 24 hourly slots of day d 5. Score the day with STAPE and SMAPE 6. Repeat daily; 873 to 926 days evaluated per run | Computational effort not addressed by the authors Forest is 'certainly more resource-intensive' than LAG, which stores one value per slot (24 values) Training data: 10 to 30 days of hourly rows; best at about 20 days for L14, no gain beyond 7 days for L17 Data and code public: github.com/falkr/indoor-photovoltaic-energy-prediction | Numbers for the SVM, XGBoost and neural network runs Hyperparameters other than trees, depth and training window PV cell type, area and harvesting hardware Raw sampling rate Training time, prediction time, memory Outdoor performance Any scheduling or energy-management result using the forecasts | Its daily retrain on the last few weeks of hourly data is cheap on a VPS (5 nodes x 30 days x 24 rows). It used indoor, microwatt data and a next-day horizon; the weather forecast input is the part worth testing for us, and only if it helps under 6 hours (see #28). | Full text, IEEE Access open-access PDF, including Table 2 and Figs. 1 to 8
22 | Uncertainty-aware prediction and allocation (Yamin and Bhat, 2023) | No harvest was measured on hardware; harvest was simulated. Irradiance: NREL per-minute solar irradiation data; Golden, Colorado 2015 to 2020 (NREL SRRL Baseline Measurement System), Las Vegas, Nevada 2017 to 2020, Eugene, Oregon 2018 to 2020. Harvester: SP3-37 flexible PV cell (FlexSolarCells datasheet); irradiance was converted to harvested energy using the cell's area and current-voltage characteristics. The area and I-V values used are not stated. Storage: 12 mAh battery; the 100 J end-of-day target is described as about 60 percent of battery capacity. Battery voltage and harvester efficiency (eta) values: not stated. Device model: TI CC2652 with an ARM Cortex-M3, inertial motion unit, temperature, humidity and pressure sensors. The prediction networks and the allocation algorithm were run on the CC2652 to measure time and energy. Utility curve shape taken from human activity recognition and gesture recognition accuracy against normalised energy (Fig 4). | Input irradiance: one sample per minute. Decision interval: 1 hour; horizon 1 day, T = 24 intervals (the method is said to also apply to 15 or 30 minute intervals, not tested). Prediction: made at the start of each interval for the next five intervals (t to t + 4). Fine-grained features use the minute data over the past 15, 30 and 60 minutes. Accuracy index: averaged over the past five intervals. Initial day-ahead estimate for all 24 intervals: mean of the energy predictions over the past three days. | 17 features, all from the device's own harvest record plus the calendar: 1 to 3. Harvest in the same interval t on each of the previous 3 days (E_t^(d-3), E_t^(d-2), E_t^(d-1)). 4 to 7. Harvest in each of the previous four intervals of the current day (E_(t-4)^d to E_(t-1)^d). 8 to 10. Average 5-point derivative of harvested energy over the past 15, 30 and 60 minutes. 11 to 13. Ratios of harvest in consecutive past intervals: E_(t-1)^d / E_(t-2)^d, E_(t-2)^d / E_(t-3)^d, E_(t-3)^d / E_(t-4)^d. 14. 3-point derivative of energy over the past three intervals. 15 to 17. Current month, day and interval index. No weather forecast or other external data. Allocator inputs: predicted mean and variance for the next five intervals, the accuracy indices of the past five intervals, the initial day estimate, current battery level, Emin and Etarget. | Level networks: two (mid-day, and dawn and dusk); two hidden layers of 4 and 8 neurons, tansig activation; 3 softmax outputs; categorical cross-entropy loss. Structure chosen by design space exploration that minimised input-layer neurons. Level classes: low (cloudy days), medium (partially cloudy), high (sunny). Thresholds between classes and which hours count as mid-day: not stated. Mean networks: six (3 levels x 2 time-of-day sets); one hidden layer of 4 tansig neurons; 5 linear outputs. Variance networks: six; one hidden layer of 4 tansig neurons; 5 softplus outputs. Training: PyTorch; three-phase mean-variance estimation training (phase 1 mean networks on set D1, phase 2 variance networks on set D2 with the mean fixed, phase 3 both fine-tuned); variance trained with the Gaussian negative log-likelihood loss (Eq 10); the text also says the energy and uncertainty networks use mean squared error. Gradient descent; learning rate 0.0001, reduced by 10 percent every 10 iterations. Optimiser name, epochs, batch size and the D1/D2 split: not stated. Training data: one year of Golden, Colorado data (which year not stated); all other data for testing. Level network accuracy: 96 percent (dawn and dusk) and 84 percent (mid-day) on training data; 97 and 86 percent on unseen data. Interval: z = 1 in Eq 8, 'to ensure that the PIs encompass two standard deviations from the mean'. Allocator (Table 1): T = 24, M_E = 8 (minimum-allocation term in the utility, Eq 15), Emin = 10 J, Etarget 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 | Level class (low, medium or high) for the coming interval. Mean and variance of harvested energy (J) for each of the next five 1-hour intervals, and a prediction interval of mean plus or minus one standard deviation. Adjusted harvest estimate per interval (Eq 20). Energy allocation E_t^c for the current hour: the energy budget (J) the device may use in that interval. | Offline: characterise harvest, build labelled feature and energy pairs, train the level, mean and variance networks, load them onto the device. Start of day: set an initial harvest estimate for all 24 hours as the mean of the predictions over the past three days. Start of each hour t: 1. Compute the 17 features; run the level network for the time-of-day set; run that level's mean and variance networks for hours t to t + 4. 2. Accuracy index for each past hour: lambda_t = Phi(actual harvest; predicted mean, predicted variance), the Gaussian CDF value (Eq 19). 3. Adjusted estimate for hours t to t + 4: inverse Gaussian CDF at the mean of the last five accuracy indices (Eq 20); replace those hours in the day estimate. 4. Solve for hours t to T: maximise the sum over t of beta^t ln((E_t^c / M_E)^gamma) subject to E_(t+1)^B = E_t^B + eta x harvest_t - E_t^c, E_(t+1)^B >= Emin and E_T^B >= Etarget (Eqs 15 to 18). 5. Solver: Lagrangian dual with KKT conditions (Eq 23), iterative gradient projection (Algorithm 1): set allocations from the inverse utility gradient, update the multipliers by a projected step, stop at the tolerance or Itermax. 6. If infeasible, relax the minimum energy constraint and solve again (Algorithm 2). 7. Apply only the allocation for hour t; discard the rest. End of each hour: record actual harvest, update the accuracy index and the battery level. | Memory for features and network weights: about 6 KB. Each network inference about 11 ms (Table 2: level 0.01 s, mean 0.01 s, variance 0.01 s), 33 ms per prediction; CC2652 draws about 4.4 mA at 3.3 V; 319.4 microjoules per prediction. Allocation, worst case T = 24 and 200 iterations: 3.00 s (gradient inversion and allocation 1.80 s, vector-matrix multiplication and multiplier update 1.00 s, exit check 0.01 s, initialisation and context switching 0.19 s); 8 intervals take about 563 ms. Energy 2.65 to 36.54 mJ per allocation, stated as less than 0.4 percent of the mean hourly harvest; the Introduction states total overhead is less than 0.15 percent of typical harvest in Golden. Complexity: O(Itermax x T^2). Training hardware and time: not stated. | Thresholds that define the low, medium and high classes. Which hours count as mid-day and which as dawn and dusk. SP3-37 area and I-V values used, and any converter or MPPT losses. Harvester efficiency eta, battery voltage and initial battery level. Optimiser name, epochs, batch size and the D1/D2 split sizes. Which year of Golden data was used for training. Solver tolerance and step size values. Meaning of sigma = 5, alpha = 1 and lambda = 0.001 in Table 1. How features are handled at night, when harvest and the ratio denominators are zero. Any test on real hardware harvesting real light (stated as future work). | The nearest published design to our allocator: forecast a range, then budget energy with it. The networks are tiny and would run trivially on the server. Their allocator plans a whole day around a 12 mAh battery, which our 0.22 F store cannot bridge, so only the hour-ahead part carries over. | Full text, ACM TODAES 28(5), Article 87 (2023): Sections 3 to 6, Eqs 1 to 27, Figs 1 to 4, Table 1 (p. 87:20), Table 2 (p. 87:30), Algorithms 1 and 2, references [1], [14], [22], [25], [27], [50].
13 | Adaptive prediction scaling (Stricker et al., 2022) | Simulation on outdoor NSRDB traces from 8 US sites (AK, CA, MD, MI, ON, OR, TX1, TX2; 1961 to 1972 or 1998 to 2009) and on indoor traces from the indoor solar harvesting dataset of Sigrist et al. (2019): one laboratory (1 month) and two offices (August 2017 to June 2019). Prototype: Panasonic AM-5412 panel (50 x 33 mm), 0.95 F supercap used between 2.7 and 3.7 V, bq25505 harvester chip (passive MPPT), MSP432 on the Dual Processor Platform. Stored energy is estimated as 0.5 x C x V^2 from the sampled supercap voltage. A RocketLogger measured voltages and currents, and an LED testbed replayed recorded light levels. Measured: harvest = 3.55e-7 W per lux (11 levels, 0 to 10 klux), charging efficiency 0.888, discharging 0.993. Leakage neglected. | 1 h intervals indoors and for the duty-cycle scheduler (DCA) Outdoor results reported per day; the outdoor interval for OPT and LT-ENO is not stated Outdoor adaptive scaling runs over 10 years (ON, OR, TX1, TX2); the WCMA and Pro-Energy comparison uses 1 year at TX1 On the prototype, 1 h of data is replayed in 2 min (5-day trace from office LOC 1) | The forecast from whatever predictor is used, over the scheduler's horizon The harvest actually observed The current stored energy b(t) and the capacity B The scheduler itself, re-run when the recent past is re-simulated | c: the factor the forecast is multiplied by, between 0 and 1, learned online Starting value c0 = 1 - the predictor's error on other sites: 0.831 outdoors (EWMA, 16.9% MAPE over AK, CA, MD, MI), 0.47 indoors with EWMA (53% MADP), 0.63 indoors with 'same as last hour' (37% MADP) gamma: reserve that triggers a correction, 10% of capacity outdoors, 20% indoors Step down 0.05; step up 0.01 x accuracy over the last horizon (MAPE outdoors, MADP indoors) Storage: 143 Wh outdoors (discharge efficiency 0.7), 3 J indoors Indoor EWMA alpha 0.5; minimum duty cycle 0.01; indoor maximum power 1 mW | The scaled forecast, c x forecast, handed to the scheduler. It does not add a new predictor. | 1. Start with c = c0 2. Each interval: if stored energy drops below gamma x capacity, lower c by 0.05 and replay the recent past (from when storage was last full) until storage stays above the reserve 3. After each horizon with no correction: raise c by 0.01 x accuracy, never above 1 4. Give the scheduler c x forecast instead of the raw forecast Storage model: b(t+1) = b(t) + harvest - used, kept between 0 and capacity; used = scheduled energy, or all that is available if less Shortcut: during the replay, where the scaled forecast was below the actual harvest the scheduler is not re-run and the previous schedule is reused | Forecasts and harvest since storage was last full, plus a running accuracy (one number per interval). Outdoors the longest history was 27 to 37 intervals, under 400 bytes per site at 32 bits per value, with 9 to 18 extra scheduler runs over 10 years. Indoors with EWMA about 309 intervals of history and under 2% extra scheduler runs; with last-hour persistence no extra runs, but about 9000 and 4000 intervals kept (never replayed, compressible). | The horizon length for the step up, and the scheduler horizon used in the case studies Whether 'accuracy' in the step up is the error itself (MAPE or MADP) or 1 minus it The outdoor EWMA alpha and the outdoor interval length for OPT and LT-ENO How outdoor irradiance was turned into harvested energy (Table 1 gives panel area, maximum consumption and an environmental parameter per site, following Ref. [8]) WCMA's D and other WCMA and Pro-Energy settings, and the unit of their mean absolute errors What to do if storage has never been full | Fits our server directly: we already plan stored energy as 0.5 x C x V^2 from the supercap voltage. Start c near 0.8 with their step sizes, then check the reserve level against our real brown-out margin. | Full text (open access published version, PDF from ETH Research Collection)
15 | LoRaWAN packet schedulers (Capuzzo et al., 2022, preprint) | Only harvested power was measured: 4 indoor solar traces from a 6-cell monocrystalline 4 x 2 cm panel on windowsills. 2 were recorded by the authors in Antwerp (west-facing; a sunny and a cloudy day in September 2020; mean 7.2 ± 8.2 and 4.0 ± 2.0 mW). 2 come from Gorlatova et al., INFOCOM 2011, Setup C (north-facing; 12 June 2010 and 12 December 2009; mean 27.5 ± 8.1 and 3.8 ± 3.3 mW). A constant harvest of 1 to 8 mW was also simulated. The node, radio and capacitor voltage are simulated in ns-3. The load is a resistance per device state, with a power profile 'derived from empirical measurements', but those values are not given. The logger and sampling rate are not stated. | Simulated in ns-3; the scheduler sits in the end device and uses only local information A packet is generated at most every 4 s; a newer packet overwrites one not yet sent The 1% duty cycle allows one 5 byte packet every 5.15 s at SF7 Harvest estimates look back 1, 5 or 30 s (AS-x), 5 s (MinS) or 4 s (AVES) | Capacitor voltage (stored energy) Estimated harvest during the coming cycle, from harvested power measured over the last x s (none for CS) Payload size, spreading factor, and whether an ACK is expected The energy profile of a whole Class A cycle The turn-off voltage Duty-cycle state | Turn-off 1.8 V, turn-on 3 V Fixed-threshold policy: 1.82 V Packet at most every 4 s; SF7; EU 868 MHz channels, 1% duty cycle; RX1 at +1 s on the uplink channel and SF, RX2 at +2 s on 869.525 MHz at SF12 Payload 5 bytes (0 to 200 tested) plus 13 bytes MAC and PHY overhead; 51.46 ms on air at 5 bytes, SF7 Capacitor from 2 mF up to about 110 mF (Fig. 7); 20 and 100 mF in Fig. 5; 40 mF recommended Look-back windows: 1, 5 and 30 s for averages, 5 s for the minimum; AVES window 4 s and smoothing g = 0.1 Constant harvest 1 to 8 mW with 100 mF (Fig. 4) Runs of 9 h (10:00 to 19:00), capacitor starting empty | For each packet: send now, or hold it until the stored energy is enough (a newer packet replaces it); packets blocked by the duty cycle are dropped At most one packet per 4 s, and never faster than the duty cycle allows | Energy model: harvester = voltage source E with series resistance ri(t), so the maximum harvest power is Ph = E^2 / ri(t); load = resistance RL(s) per device state s; capacitor voltage v(t, s) = E x Req / ri x (1 - e^(-t / (Req x C))) + V0(s) x e^(-t / (Req x C)), where Req = RL x ri / (RL + ri) 1. A packet is generated at most every 4 s, overwriting any unsent packet; drop it if the duty cycle forbids sending 2. Estimate harvest for the coming cycle: zero (CS), mean of the last x s (AS-x), minimum of the last 5 s (MinS), or max(A - D, 0), where A and D are the smoothed mean and deviation of the 4 s average (AVES) 3. Work out the stored energy needed to finish the whole cycle (transmit, RX1, RX2) from payload, spreading factor, ACK and that estimate; the paper does not give the method 4. Transmit only if the capacitor can finish the cycle without falling below 1.8 V; otherwise wait | A few seconds of harvest history on the node; none for CS. The authors note that short averaging windows need less computation and memory. The energy cost of running the scheduler is not given. | Current or resistance per device state The source voltage E Receive window lengths Transmit power Wake-up energy (said to be non-zero), leakage and converter efficiency The formula for the energy check itself (only its inputs are listed) How often the check runs while a packet waits How a real node would measure its harvested power Logger and sampling rate of the traces | The conservative rule (assume zero harvest, check the voltage survives the whole job) maps straight onto our ENS160 check, using job energies measured with the PPK2. | Full text (arXiv 2212.09453v1, preprint submitted to IEEE; no journal version found)
16 | Optimal scheduling as a MILP (Delgado and Famaey, 2022; online 2021) | Nothing measured. Harvest power is assumed known and constant within each experiment (the optimiser and simulator can take time varying harvest, but it was not used). Task currents and durations come from the nRF52840 datasheet (BLE radio). Capacitor voltage is simulated in an event based C++ simulator. As future work they suggest a resistor divider for the capacitor voltage and periodic open-circuit voltage and short-circuit current readings of the panel, which means disconnecting it and costs energy, or harvest prediction instead. | One device, no telemetry Time step of 0.01 s Runs of 15 s (comparison with InK) and 25 s (look-ahead study) Solved offline over the whole run, or re-solved at the start of each look-ahead window | For every task: priority, run time, arrival time, deadline, current, and which tasks must finish first Capacitor size, voltage limits and starting voltage Operating voltage (3.3 V), to turn task current into a load resistance Harvest power at every step Sleep current | Off voltage 1.8 V, maximum 3.3 V, start 2.2 V (also 1.9 V) C = 4.7 mF (also 0.47 mF) Harvest 0.1, 0.5, 1 and 5 mW, constant within a run (indoor light levels, in the authors' words) Sleep 0.1 mA; turning on after a power failure 3 mA for 0.1 s Tasks as (priority, run time, current, deadline): Sense (1, 0.03 s, 1.7 mA, a third of its period); Compute (3, 0.01 s, 1 mA, 1 s); Transmit (3, 0.19 s, 4.36 mA, 1 s); Request (8, 0.21 s, 4.61 mA, 0.2 s); Response (10, 0.19 s, 4.36 mA, 0.02 s); Receive (8, 0.21 s, 4.61 mA, 0.2 s); Actuate (8, 0.05 s, 9 mA, 1 s) Sense every 1 s from 0 s; Compute and Transmit after every 5 Sense tasks; Request from 1 s every 2 s (the text also says Y = 3); Receive from 3 s every 5 s InK turn-on thresholds 1.9, 2.2 and 2.8 V (2.2 V used after the first comparison) Look-ahead windows from 0.25 to 25 s tested (0.25, 0.5, 1, 2.5, 5, 12.5 and 25 s) | For every 0.01 s step: which task to start, which is running, or sleep Capacitor voltage at every step | Energy model: harvester = current source I = Vmax / rh with parallel resistance rh = Vmax^2 / P_harvest; load RL = E / I_task with E = 3.3 V; Req = RL x rh / (RL + rh); v(t) = I x Req x (1 - e^(-t / (Req x C))) + V0 x e^(-t / (Req x C)); sleep uses the sleep current Mixed integer linear program: Maximise the sum of priority x tasks started Subject to: one task at a time; each task at most once; a started task runs to completion; only between its arrival and deadline; parents before children; capacitor voltage within its limits at every step The product of the run flag and the previous voltage is linearised with an extra continuous variable Solve with Gurobi, then replay the schedule in the C++ simulator Look-ahead study: re-solve at the start of each window (consecutive windows: 0.25 s means 100 windows over the 25 s run) | Solved with the Gurobi solver, off the device; the authors say the MILP cannot be solved in real time on a batteryless device. Solve time not given. A longer look ahead needs more memory (no figure given). | Any way to predict harvest Measurement hardware Solve time, solver settings and the computer used What happens when harvest isn't known exactly (they say power failures would occur) Energy cost of running the scheduler itself (left to future work) The text gives two different periods for the Request task (2 s and 3 s) | Use it as the upper bound in our evaluation: give it the harvest that actually happened, and see how close our rule gets. At their 0.01 s step a day is 8.64 million steps, so we would need a much coarser step. Gurobi is commercial, so an open solver may be needed on the VPS. | Full text (arXiv 2402.05319v1)
17 | Central manager for battery-less routers (Van Leemput et al., 2024) | Each node reports its capacitor voltage and current harvest power, with a timestamp (the ASN at which both were read). In the evaluation both came from a Python battery-less simulator connected over a serial link to each simulated node in Cooja (Contiki-NG); there was no real hardware, and the paper doesn't say how a real node would measure harvest power. The authors simulated because Contiki-NG on real hardware keeps a 16 MHz timer running in low power mode (6.3 mA instead of 3.16 uA). Consumption isn't reported to the manager; the manager predicts it from traffic and per slot energy costs, using nRF52840 datasheet currents. In the simulator, each node's Energest timings drive the simulated capacitor, using the same capacitor model as the prediction. | Telemetry is piggybacked on RPL DAO routing messages: on average every 15 min with the default 30 min Prefix Lifetime, and also whenever the topology changes Energy telemetry per node: capacitor voltage (2 bytes), harvest power (2 bytes), timestamp (Energy ASN, 2 bytes) Traffic telemetry per node: neighbours (N bytes), preferred parent (1 byte), routing table (2R bytes), time source (1 byte); optional ETX (2 bytes), TX ASN (2 bytes), EB ASN (4 bytes) All of it must fit in one DAO: 127 bytes minus the DAO itself (typically 86 bytes in storing mode) Back to the node: a 1 byte divisor in a UDP message, sent only when it changes; the node then broadcasts one DIO carrying it Prediction interval 15 min; timeslot length not stated | Last reported capacitor voltage (V0) Last reported harvest power, used for the whole next 15 min Predicted consumption over the 15 min, from the traffic model and per timeslot energy costs Capacitance, converter efficiencies, leakage power and reference voltage Vref Thresholds Vth and Von, and the maximum divisor | C = 200 mF, operating range 1.8 to 5 V (Fig. 8 marks 1.8 V as turn off and 5 V as maximum) Leakage 2 uA at 5 V, assumed constant Converter efficiency 80% in both directions Prediction interval 15 min Maximum divisor 6 Thresholds in the text: Vth 2.5 V, Von 3.5 V (Table 4 prints them as Von 2.5 V and Voff 3.5 V) Sized from 0.47 J to join the network (average from their earlier work on the same platform) and 0.45 J per 15 min (preliminary simulation with divisor 1) nRF52840: sleep 3.16 uA, CPU 6.3 mA, receive 6.53 mA, transmit 6.4 mA at 0 dBm Schedule: Orchestra TSCH-RB-397-62-17 (two router test), TSCH-RB-397-62-21 (20 node test); 2 advertisement channels, 16 channels Routing: RPL MRHOF, parent switch threshold 1.5, link metric ETX + divisor - 1 Harvest: 200 to 1,200 uW changing every 20 min (two router test); 200 to 800 uW per node, varied by -100 to +100 uW every 5 min (20 node test) | A divisor from 1 to 6 for each node. The node then runs one unicast receive slot every Ssf x divisor slots instead of every Ssf (eq. 9), which cuts idle listening. Neighbours add divisor - 1 to their ETX towards it, which pushes its children to other parents. Recomputed after each prediction interval, and sooner when a topology change triggers telemetry. | Energy per timeslot = sum over states of duration x current x Vref (eq. 1); total over the interval from predicted slot counts (eq. 3); idle receive slots from the schedule (eq. 4, 5) Voltage after Tp, eq. (6) as printed: Vp = V0 x e^((-Ec'/Vref^2) x C) + (Vref x Tp x Ph' / Ec') x (1 - e^((-Ec'/Vref^2) x C)) Eq. (7) as printed: Ec' = Ec x eta_PMU,l + Pleak / Tp Eq. (8): Ph' = Ph x eta_PMU,h Thresholds: Vth ~ sqrt(2 x Ep / C + Voff^2) (eq. 11); Von ~ sqrt(2 x Ejoin / C + Vth^2) (eq. 12) 1. divisor = 1; predict Vp for that divisor 2. While Vp < Vth and divisor <= max_divisor: divisor + 1, predict again 3. While Vp > Von and divisor >= 1: divisor - 1, predict again 4. Return the divisor; if it changed, the border router sends it to the node in a UDP message 5. The node broadcasts a DIO with the new divisor; neighbours that receive it skip the matching transmit slots and raise their ETX towards it | Not stated explicitly; the manager works from each node's latest topology, timing, voltage and harvest telemetry Overhead per node 87.94 nW average power for the telemetry bytes, decision messages and extra DIOs (Table 5) Compute time and memory of the manager: not stated | How a real node would measure harvest power The value of Vref and the timeslot length How accurate the voltage prediction was (predicted against simulated voltage is not reported) Compute time and memory of the manager Their printed Vth doesn't follow from their own eq. (11): with Ep = 0.45 J, C = 0.2 F and Voff = 1.8 V it gives about 2.78 V (our check). Von = 3.5 V follows from eq. (12) only when starting from 2.78 V (3.53 V); from the printed 2.5 V it gives 3.31 V (our check) Between 1.8 V and the printed 2.5 V a 0.2 F capacitor holds about 0.30 J, less than the 0.45 J per interval the threshold is meant to cover (our check) Eq. (6) and (7) as printed are not dimensionally consistent: C sits in the numerator of the exponent, and (7) multiplies consumption by the efficiency and divides leakage power by Tp. A consistent form is exponent -Ec'/(Vref^2 x C) with Ec' = Ec / efficiency + Pleak x Tp (our check) As printed, step 2 can push the divisor to 7 and step 3 to 0; clamp it to 1 to 6 As printed the divisor restarts at 1 on every run, so step 3 only acts when divisor 1 already predicts above Von or step 2 overshoots (our reading) | The closest match to our architecture: voltage and harvest go up in the status uplink, and a decision comes back down. Their threshold formulas can run on our server with PPK2-measured task energies. Use the dimensionally consistent voltage equation noted under 'Not stated', not the printed eq. 6 and 7, and check it against PPK2 data, because their simulator used the same capacitor model as their predictor. | Full text: IEEE Access open access PDF (publisher version), identical to the Ghent University repository copy; tables and equations read from the rendered pages
18 | Multi-node task allocation (Edalat and Motani, 2016) | Nothing measured on hardware; simulation only. Solar irradiance per 1 h slot from an NREL trace (California Solar Initiative data, 4 days from 26 October 2011, sunny and cloudy days). The unit is W/m2 in Section 3 and the figures but mW/m2 in Section 7.1. Irradiance is converted linearly to energy using a 9.6 x 6.4 cm panel, 10% cell efficiency and 80% harvesting efficiency, and energy is given in Ah at a fixed 1.2 V. Node power consumption is taken from the Mica-2 datasheet; the resulting energy per busy slot (E0) is not given. Each node's stored energy is modelled, not measured. | Predictor: 24 slots per day (1 h), one slot ahead, run once per slot Allocation: equal-length slots; slot length not stated; schedule lengths are reported in ms A central manager (for example a Stargate-class node) predicts the next period's harvest, assigns tasks and a per-slot energy budget, and sends them to the nodes; nodes send harvest statistics back for the next period Communication between the manager and the nodes is ignored; the delay between dependent tasks on different nodes is a constant Tc | The task graph: task lengths in slots, which tasks must come first, communication delay Tc Earliest and latest start time for each task (Eq. 18, 19) Predicted harvest and available energy per node per slot Storage capacity B, discharge efficiency, energy per busy slot E0 Predictor: today's irradiance per slot and the last D days per slot On the node: actual harvest and actual stored energy | Predictor (AR-WCMA): T = 24 slots per day, alpha 0.7, D = 4 days, K = 4 slots, slot weights k/K; the AR order is not given, nor how its coefficients are estimated (only that they are recalculated daily from the last D days) Panel 9.6 x 6.4 cm, 10% cell efficiency, 80% harvesting efficiency, 1.2 V Not given: storage capacity, discharge efficiency (only that it is below 1), energy per busy slot, the two objective weights, communication delay, the prediction error threshold, the DVFS levels and minimum frequency Genetic algorithm baseline: population 10, single point crossover with probability 0.6 to 0.9, roulette wheel or binary tournament parent selection, delete-worst survivor selection, fitness-dependent mutation (rates not given), stops after 10 generations without improvement Test sizes (Table 1): 7 to 30 tasks, 2 to 50 nodes, at most 2 or 3 predecessors per task | A node and a start slot for every task, and an energy budget per slot, once per planning period On the node: a slowdown factor for any task whose energy falls short, and later start times for the tasks after it | Stored energy: A(t+1) = A(t) + H(t) - efficiency x E0 (when busy), kept between 0 and capacity B (Eq. 16) 1. Earliest and latest start time for each task from the task graph (Eq. 18, 19) 2. Queue tasks by latest start time 3. Update each node's available energy from the harvest forecast 4. For each task, node and slot between its earliest and latest start: if the node's available energy has reached B, assign the task there at once (cost 0, Eq. 20); otherwise cost = task length / available energy (Eq. 17) 5. Give the task the node and slot with the lowest cost 6. On the node, each slot: compare the budget with actual harvest; if the error passes the threshold and stored plus harvested energy is below the task's demand (Eq. 22), slow the task (DVFS) until they balance (Eq. 23) and delay the tasks after it; the task is missed only if the frequency needed is below the minimum | Manager: the last D days of per-slot readings (4 x 24) plus the current day, the task graph, and each node's forecast and energy budget for the planning period Node: its per-slot energy budget and a baseline error margin Compute: O(m) to order the tasks and O(n m e) worst case to assign them, where e is the largest gap between a task's latest and earliest start; dynamic stage O(k l) for k affected tasks and l successors Run times and memory not stated | Most constants (listed in the parameters column) The allocation slot length and the planning period length How the one-slot-ahead forecast is extended over the planning period The AR order and how its coefficients are fitted What the nodes send back (only 'energy harvesting statistics') How prediction error was injected in the dynamic test, and how random task graphs and task lengths were generated Whether each node used its own harvest trace How the MILP was linearised; run times for any method Exactly which quantity the Fig. 9 performance ratio compares Several typos in the printed equations and figure references (the cost is cited as equation (3.10); stored energy is written C in the text for Eq. 22; Figs. 5 and 6 are swapped in the text; the text says Fig. 11 compares with CNPT but the legend says E-CNPT) | Its cost rule (task length / available energy, with a node whose storage is already full taking the task first) is a ready-made 'which node gets the task' score for our allocator. | Full text (SpringerOpen, journal version)
23 | Long-term planning, doctoral thesis (Buchli, 2015) | Model check: 30 W mono-crystalline panel (cleversolar CS-30, 0.1725 m2) on an ETH Zurich roof (47.37 N, 8.55 E; azimuth 170, inclination 70 degrees), resistive load, sampled at 1 Hz for 41 days (July to August 2013). Simulation: hourly global radiation from NSRDB for CA, MI, ON (1999 to 2009) for sizing and LT-ENO, and for 8 US sites (TX2, TX1, CA, MD, MI, OR, ON, AK), 12 years each, for OPT. Panels 5 to 20 cm2 at 10% efficiency, battery charge efficiency 0.9 and discharge 0.7, no leakage. Field: two X-Sense CoreStations in the Swiss Alps (DH and GG, about 46.1 N, 7.8 E), 2012 to 2014, each with a CS-30 panel, SunSaver SS-6L PWM charge controller, 54 Ah Lifeline AGM lead-acid battery and about 6 W load at full performance (u-blox LEA-6T GPS). No panel current sensor: harvest was inferred from the battery state-of-charge algorithm (voltage and drain current, 30 s sampling). | Input data hourly (NSRDB), summed to daily or weekly energy Sizing: daily energy over a one-year cycle LT-ENO: one duty-cycle update per day, window W = 63 days (10 days in the field study) OPT: one update per week (1, 2, 4, 6 and 8 weeks tested), horizon 1 year, window 52 weeks Baselines EWMA, WCMA, ENO-MAX: 24 slots per day (1 h) Model check panel: 1 Hz for 41 days | Site latitude, panel azimuth and inclination, calendar day Environmental parameter Omega (average weather), from a year of data or from an estimate of how often skies are clear, hazy, overcast or blocked Panel area, efficiency and maximum power; charge controller and battery charge and discharge efficiencies Measured daily (or weekly) harvested energy, or harvest inferred from the battery state of charge Battery capacity; current battery level (OPT) System power at full duty cycle | Astronomical model: diffuse sky k = 0.1, ground reflectance R = 0, optical thickness replaced by Omega Omega = weighted sum of 0.1, 0.4, 0.7 and 1 by the share of days above 75, 50, 25 and 0 percent of clear-sky energy (example 0.51) Omega per site from the first year: 0.2242 to 0.4855 (8 NSRDB sites); 0.6 assumed for the alpine sites, 0.83 and 0.8 would have been safer Panel efficiency 10% in simulation, 21.5% for the roof panel; battery efficiencies 0.9 in and 0.7 out; charge controller efficiency 1 Low-voltage reconnect at 30% (sizing) or 60% (runtime control) of capacity LT-ENO: W = 63 days; minimum duty cycle 50% in the comparison OPT: 1-week interval, 1-year horizon, start battery 50%, W = 52 weeks, fixed weekly down-scaling curve g(t), battery 100 Wh, target duty cycle 40%, look-up table in 1% battery steps Baselines: EWMA alpha 0.5; WCMA K = 3, D = 4, alpha 0.3; ENO-MAX constants 1/24 and 0.25, battery target 65% | Sizing: battery capacity (or panel size) and the supported duty cycle LT-ENO: the duty cycle for the next day OPT: the energy budget for the next week, in Wh State-of-charge algorithm: battery fill level and remaining runtime | 1. Offline: compute each day's expected harvest from the astronomical model, Omega and the panel and efficiency factors; size the battery so it bridges the winter deficit and the summer surplus can refill it 2. LT-ENO, each evening: lambda = measured harvest over the last W days / modelled harvest over the same days; scale the whole year's model by lambda 3. LT-ENO: find the surplus and deficit periods where the battery constraint holds (Algorithm 1); tomorrow's duty cycle = (min(battery, surplus) + harvest in the deficit period) / (system power x 24 h x deficit days) 4. Emergency: if harvest falls below a threshold, the duty cycle decays exponentially towards the minimum 5. OPT, each week: estimate = astronomical model x lambda x g(t); solve the maximin allocation over the next 52 weeks from the current battery level (iterative shortest-path method, Algorithm 2), ending at the planned periodic battery level; use only the first week's budget 6. On the node: read the budget from a precomputed table indexed by week and battery level, interpolating between 1% steps | LT-ENO: W stored daily harvest values plus 365 modelled values (or compute them); computation linear in the number of days, once per day. OPT look-up table: 454 to 580 floats (mean 515) of non-volatile memory and a few operations once per week. The full iterative OPT algorithm is suggested for resource-rich platforms or server-controlled devices; its runtime is not reported. | Runtime of the iterative OPT algorithm (announced for Section 4.7 but not given) The values of the weekly down-scaling curve g(t) (shown only as a figure) Units of the minimum utilisation values in Table 4.3 Forecast error figures (MAE, RMSE) for any predictor; accuracy is judged only through system results, apart from the roof check and the MAPE-based window choice Any machine learning predictor Supercapacitor or batteryless operation (named as future work) | Its estimator (a clear sky model scaled by the recent ratio of measured to modelled harvest) is close to our planned baseline and cheap to run on the server. The weekly and yearly planning assumes a battery that bridges weeks, so it does not carry over to a 0.22 F supercapacitor. | Full text (thesis PDF, ETH Zurich)
24 | Per-task voltage thresholds (Sabovic et al., 2022) | Node: Nordic nRF52840 DK running a Bluetooth mesh application, TX power 8 dBm; a second, mains-powered nRF52840 DK receives the data Task current and duration measured with a Nordic Power Profiler Kit II (Tables I and II) Setup 1: Environment Emulator (De Mil et al.) emulating the capacitor and a constant or switched harvest current; task profile measured at 3.3 V Setup 2: e-peas AEM10941 evaluation board, 1.8 V LVOUT to the node, capacitor on BATT, Panasonic AM5608 panel (6 amorphous silicon cells) lit by a Philips 5.5 W white LED lamp (470 lm) in a dark room Capacitor voltage read through a resistor divider switched by MOSFETs, about 1.5 mA while measuring Application: temperature every 1 s, store, average of 3 samples, transmit, 500 ms LED blink | Runs entirely on the node Temperature task every 1 s Voltage check every 1 s (emulator); every 1 s or 10 s (AEM10941) Emulator runs 160 to 250 s; harvest switched every 35 s in the non-constant run AEM10941 runs 5400 s | Capacitor voltage, read before each task and at each check Per-task current and duration, measured beforehand with the PPK2 Capacitance Harvest current (the known value, or 0 for the worst case) Vmin, the lowest voltage a task may end at Task metadata in JSON: priority, deadline, periodicity, constraints, parent-child flow | Emulator: turn-off 1.8 V, Vmin 2 V (safety margin), maximum 3.5 V; C = 4.7, 10, 20 mF; harvest 17.09, 34.19, 51.28, 68.38, 85.47 µA AEM10941: turn-off 2.8 V, turn-on 3.67 V, maximum 4.5 V; C = 4.7 and 10 mF; harvest 20 and 40 µA Voltage check period 1 s (emulator); 1 and 10 s (AEM10941) Sensing every 1 s; 3 samples before the compute task Priorities: temperature 3, store 5, compute 8, transmit 10, LED 4 Task currents about 0.2 to 6 mA, durations about 1 ms to 508 ms (Tables I and II) Sleep between checks about 10 µA; each voltage check about 110 µA (emulator) | Per task: run now, or sleep and check the voltage again; drop the task if its deadline can no longer be met Reported: capacitor voltage traces, application cycles completed, time the device is on, number of power failures | 1. Measure each task's current and duration with the PPK2; write task parameters and task flow in JSON 2. Work out each task's Vreq from Eq. 1 with Vmin, C and the chosen harvest current 3. On boot, reload task instances from flash, or parse the JSON and store it 4. Pick the highest-priority task instance (earliest deadline breaks ties); drop it if its deadline cannot be met 5. Sleep until its earliest start time, then read the capacitor voltage; while below Vreq, sleep for the check period and read again 6. Run the task if Vreq is reached and the deadline still holds; add child tasks whose constraints are met; save to flash (EAS+FLASH version) | Task list and task instances kept as C structs in flash (EAS+FLASH), or only in RAM (EAS-FLASH) Scheduler and flash raise each task's current and time: the temperature task takes 0.61 mA for 1.15 ms alone, and 1.38 mA for 12.31 ms with scheduler and flash (emulator, Table I) Each voltage check about 110 µA (emulator); the divider adds about 1.5 mA while measuring (AEM10941) Code size and RAM use: not stated | The meaning of ρ(Is) in Eq. 1 (defined only in the cited 2020 paper) Vmin or any safety margin for the AEM10941 runs Which harvest current was used for the thresholds in the switched-current emulator run Any result labelled as the zero-harvest (worst case) threshold, although the text says it was tested How the 20 and 40 µA harvest currents were measured Number of repeated runs The temperature sensor used | Their threshold equation could run on the server with PPK2-measured job currents and durations and the voltage in the uplink, taking harvest as zero for safety. The node should still check its own voltage just before starting, since the uplink can be 60 s old. Their loads and capacitors are far smaller than an ENS160 run. | Full text (accepted author version, University of Antwerp repository)
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
