ahm-adsaad/sdp-sensor-nodes/docs/research/2026-09-20-energy-prediction-literature.xlsx

Sheet: About
Predicting harvested energy on solar sensor nodes: literature review
Prepared | September 2026, for the senior design project (sdp-sensor-nodes).
The question | Our server should decide which node gets the next task, based on how much energy that node will have. Do we predict that with a statistical method or with machine learning?
Scope | 24 papers, all on energy harvesting nodes, solar prediction for those nodes, or scheduling tasks on them. Two general forecasting papers sit on the Background sheet because they are about retail and business data, not energy.
How to read the Papers sheet | Group says why the paper is here. What they did is the method in plain words. Setup says hardware or simulation and at what scale. Main result gives the numbers the paper reports. Why it matters says what we take from it.
Evidence labels | Full text means we read the paper. Abstract only means we read the abstract or publisher record and nothing more. Preprint means not peer reviewed.
Empty cells | An empty cell means we could not confirm that item from what we read. Nothing is filled in by guesswork.
Comparing numbers | Metrics, sites and horizons differ between papers. Compare figures within a paper, not across papers.
Our own figures | Rows marked as ours on the What we found sheet come from our hardware and datasheets. They are calculations, and PPK2 measurements will replace them.
Checking | Every DOI and arXiv identifier was checked against its Crossref or arXiv record for title, authors, venue and year.
AI disclosure | Searching, extraction and drafting used AI assistance (Claude). Verify any figure against the original before quoting it.

Sheet: Papers
# | Group | Paper | What they did | Main result | How the model works, and what it uses | Link
1 | A. Predicting harvest | Prediction and management in energy harvested wireless sensor nodes | Predicts the next 30 minutes by averaging the same slot over the last 4 days, then scaling that by how today is running against those days. Called WCMA. | Average error 9.8 percent, against 28.6 percent for EWMA. On a day the weather turned: 10.20 percent against minus 90.99 percent. | Day split into 48 slots of 30 minutes, with the last 4 days kept in memory. The forecast for the next slot is a weighted sum of the last measured slot and the average of that same slot over those 4 days, and that average is scaled by a GAP factor comparing today's last 3 slots against the same slots on the stored days. Published settings: weighting factor 0.7, 4 days, 48 slots, 3 slots for the GAP factor. Input is the node's own harvest history, nothing external. | https://doi.org/10.1109/WIRELESSVITAE.2009.5172412
2 | A. Predicting harvest | Evaluation and design exploration of solar harvested-energy prediction algorithm | Takes the WCMA method above and tests how it holds up across different climates, slot lengths and prediction horizons. | Error 6.59 to 17.22 percent at 30 minutes and 8.88 to 21.43 percent at 1 hour, depending on site. Costs 4 to 9 microjoules per prediction. | Treats the WCMA parameters as a design space and sweeps them: slot length from 5 to 60 minutes, how many past days are stored, how many recent slots feed the GAP factor, and the weighting factor. Also counts the energy each prediction costs on an MSP430. The finding that matters is that the best parameter set differs by site, so published defaults do not transfer. | https://doi.org/10.1109/DATE.2010.5457222
3 | A. Predicting harvest | Pro-Energy: a novel energy prediction model for solar and wind energy-harvesting WSNs | Stores whole days of past harvest, then finds the stored day that most resembles today so far and uses the rest of that day as the forecast. | Reported as up to 60 percent more accurate than EWMA and WCMA. | Day split into slots, with a pool of whole past days kept in memory. For a future slot the forecast blends the last measured slot with that slot's value in the stored day, or days, most similar to today, where similarity is the error over the last few slots. Parameters: number of slots per day, how many day profiles are pooled, how many recent slots decide similarity, and the blending weight. Input is the node's own history. | https://doi.org/10.1109/MASS.2012.6502504
4 | A. Predicting harvest | UD-WCMA: an energy estimation and forecast scheme for solar powered wireless sensor networks | Makes WCMA's weighting adapt as the weather changes, rather than being tuned in advance, by blending the latest measurement, the most similar stored day and the multi-day average. | The authors report it beating EWMA, WCMA and Pro-Energy on real irradiance data, and validate it on real low power nodes. We could not read the numbers, the full text is paywalled. An independent comparison in 2020 found it improved on Pro-Energy only at that method's low overhead setting. | Keeps a pool of past day profiles like Pro-Energy, but makes the weights adapt instead of being tuned in advance. The forecast for a future slot combines three things: the last measured value, the value of that slot in the most similar stored day, and the multi-day average scaled by a GAP factor for how today is running. The weight shifts between them using standard deviations, of that slot across past days, of the slot to slot changes on those days, and of today's own recent changes, so a settled day leans on history and a volatile one leans on the latest measurement. Recommended settings reported elsewhere: 6 stored day profiles and 4 recent slots. The authors state it needs no pre-calibration. Input is the node's own history. | https://doi.org/10.1016/j.jnca.2017.04.003
5 | B. Machine learning | A hybrid prediction model based on LSTM, empirical mode decomposition and solar profiles for energy harvesting WSNs | Splits the harvest signal into components, then trains an LSTM on them together with profiles of similar past days, predicting an hour ahead. |  | Empirical mode decomposition splits the harvest series into simpler components, an LSTM is trained on those, and profiles of similar past days are used alongside it, predicting one hour ahead. Inputs are past harvest values only, with no weather feed. Network size, training length and hyperparameters: not confirmed from what we could read. | https://doi.org/10.3390/en12244762
6 | B. Machine learning | Predicting solar-harvested energy for resource-constrained IoT devices using machine learning | Predicts harvested energy from time of day and the device's own light readings, with no weather input, comparing quantile regression, random forest, gradient boosting and a small neural network. | Random forest and gradient boosting were best: 21.49 percent sMAPE at 30 minutes, rising to 32.53 and 36.33 percent at 5 hours. | Inputs are time of day and the device's own ambient light readings. No weather feed, and no data from other nodes. Four model types compared on the same inputs: quantile regression, random forest, gradient boosting and a small neural network, at prediction spacings from 30 minutes out to 5 hours, with the models run on an ESP32. | https://doi.org/10.1109/DCOSS-IoT61029.2024.00103
7 | B. Machine learning | Cloudy computing: leveraging weather forecasts in energy harvesting sensor systems | Predicts harvest by taking a clear day profile and shading it by the cloud cover in a public weather forecast, instead of using the node's own history. | Forecast error about half that of history based prediction between 3 hours and 3 days. Nodes ran out of energy on under 5 percent of days, against nearly 50 percent with history based prediction. | The forecast is a clear day power profile for that month, reduced in proportion to the cloud cover in a public weather forecast, then multiplied by a constant fitted for each prediction horizon. Inputs: National Weather Service sky cover forecasts plus the site's own clear day profile. Horizons of 3 to 72 hours. The node needs network access to fetch forecasts, which ours has through the gateway. | https://doi.org/10.1109/SECON.2010.5508260
8 | C. Using the prediction | Robustness of predictive energy harvesting systems: analysis and adaptive prediction scaling | Measures how much system performance is lost as forecast error grows, then deliberately scales the forecast down by a factor learned online and keeps an energy reserve. | A forecast with only 6 percent mean error still cost about a third of weekly usable energy. A scaled down EWMA beat the most accurate predictor tested by 13 percent. | Wraps around whatever predictor you already use. The forecast is multiplied by a scaling factor below 1, learned online by comparing what was predicted against what actually arrived, and the scheduler keeps an energy reserve on top. Parameters are that scaling factor and the size of the reserve. Tested by feeding several predictors, EWMA and Pro-Energy among them, into three different schedulers. | https://doi.org/10.1049/cdt2.12042
9 | C. Using the prediction | Energy-aware packet schedulers for battery-less LoRaWAN nodes | Compares seven ways of deciding whether a LoRaWAN node can afford to transmit, from an oracle that knows future harvest down to a fixed voltage threshold. | Ignoring energy cost 20 to 40 percent of packets against the oracle. Assuming zero harvest, or averaging the last 5 seconds, came out almost as good as the oracle. | Every policy decides transmit or wait from the capacitor voltage plus an estimate of incoming harvest, and they differ only in that estimate: an oracle given the true future, a fixed voltage threshold at 1.82 V, an assumption of zero harvest, a moving average of the last few seconds, the minimum over recent seconds, and a running mean minus a deviation. Node settings: capacitor size, spreading factor SF7, 1 percent duty cycle. | https://arxiv.org/abs/2212.09453
10 | C. Using the prediction | Optimal energy-aware task scheduling for batteryless IoT devices | Solves task scheduling exactly, as a mathematical optimisation that maximises completed work while keeping capacitor voltage inside its limits. | Completed 36 of 41 tasks against 21 for a scheduler that ignores energy. Zero power failures, but only when future harvest is known perfectly. A look ahead of 8 tasks was enough. | A mixed integer linear program. The variables are binary start and run flags for each task at each time step. The objective maximises priority weighted completed tasks. Constraints: one task at a time, task order, arrival times and deadlines, and capacitor voltage held between its minimum and maximum using an exponential charging model. Inputs: energy and duration per task, capacitor size, and the harvest profile across a look ahead window, which is assumed to be known exactly. | https://doi.org/10.1109/TETC.2021.3086144
11 | C. Using the prediction | Energy-aware adaptive scheduling for battery-less 6TiSCH routers | A central manager collects voltage and harvest telemetry from each node, predicts each node's capacitor voltage 15 minutes ahead, and throttles the ones that would run flat. | Reporting success and uptime both improved by 12 percent, reaching about 90 percent. The algorithm itself cost 87.94 nW, and latency rose 32.28 percent. | The manager predicts each node's capacitor voltage 15 minutes ahead from a capacitor model that includes the power converter's efficiency and a constant leakage term. Harvest is assumed to carry on at its present value. A node is throttled until its predicted voltage clears a threshold, and that threshold is sized so the energy between it and the turn off voltage covers one whole prediction interval with no harvest at all. Inputs per node: measured voltage, measured harvest power, and known energy costs per task. | https://doi.org/10.1109/ACCESS.2024.3508540
12 | C. Using the prediction | Energy-aware task allocation for energy harvesting sensor networks | Allocates tasks across several harvesting nodes from a central point, scoring each node by task length divided by the energy it has available. | A simple greedy version of the rule reached up to 70 percent of what exact optimisation achieved, and a genetic algorithm reached 82 percent. | A central allocator. Each node and task pair is scored by task length divided by the energy that node has available, and the objective is a weighted sum of total completion time and total score. Constraints: task order, one task per node per slot, and energy causality with a cap on storage. A node about to overflow its storage is given a score of zero so it gets picked first. Harvest is predicted with a combined autoregressive and WCMA model, and when prediction error passes a threshold the node slows the task down rather than dropping it. | https://doi.org/10.1186/s13638-015-0490-3

Sheet: Background
Cross-domain evidence: does machine learning beat statistical forecasting in general?
These two are not energy harvesting papers. They are business and retail forecasting competitions, and they are the standard citation for whether machine learning beats statistical methods when data is short or plentiful. They are kept off the Papers sheet for that reason. Drop this sheet if it distracts from the domain review.
Paper | Authors, year | What it tested | Result | What we take from it
Statistical and machine learning forecasting methods: concerns and ways forward | Makridakis, Spiliotis and Assimakopoulos, 2018 | Eight statistical methods against ten machine learning ones, an LSTM among them, on 1,045 monthly business series. | One step error was 7.19 percent for ARIMA, 8.39 percent for a neural network and 11.67 percent for the LSTM. The ML methods lost at every horizon. | With short series, an LSTM is a poor first choice. Business data, not solar, so treat it as a statement about data hunger.
M5 accuracy competition: results, findings and conclusions | Makridakis, Spiliotis and Assimakopoulos, 2022 | 42,840 related retail sales series with price and promotion data, forecast by thousands of entrants. | Every top entry was pure machine learning and beat all statistical benchmarks, the winner by 22.4 percent. Most used gradient boosting. | ML wins when you have many related series and useful extra inputs. Five nodes at one site is nowhere near that, but pooling nodes and adding weather is the same idea.

Sheet: What we found
# | What we found | Which papers say so | How sure we are
1 | No paper in our domain shows deep learning beating simpler methods. The one LSTM study here only compared itself against EWMA and WCMA. | Ge 2019 (row 7). Cross domain: Makridakis 2018 on the Background sheet. | Supported, though the domain evidence is thin in both directions.
2 | Where machine learning does win on harvesting data, tree models win, not neural networks. | Khamitov 2024 (row 8), Kraemer 2023 (row 9). | Two papers, both clear on this.
3 | Inputs beat algorithms. Adding a weather feed halved error where a fancier model changed almost nothing. | Sharma 2010 (row 11), Sharma 2011 (row 12), Nguyen and Musgens 2022 (row 24). | Well supported.
4 | How the scheduler uses the forecast matters more than the forecast's accuracy. | Stricker 2022 (row 13), Capuzzo 2022 (row 15), Buchli 2015 (row 6). | Well supported, and it shapes our design.
5 | A voltage threshold with a margin, and no prediction at all, already avoids power failures on hardware like ours. | Sabovic 2022 (row 14), Nasser 2026 (row 19). | Demonstrated on hardware in row 14.
6 | Reinforcement learning matches a planner that knows the future, but drains supercapacitors while it learns. | Fraternali 2020 (row 20), Shresthamali 2017 (row 21). | Clear enough that we are not attempting it now.
7 | Error grows fast with horizon, so predict over minutes to a couple of hours, not days. | Ali 2010 (row 3), Khamitov 2024 (row 8), Nguyen and Musgens 2022 (row 24). | Consistent across three papers.
8 | Our hardware is the binding limit, not the model. One ENS160 reading needs about 21 J from storage, and the 0.22 F supercapacitor holds about 0.56 J between the PMIC thresholds as rev 1 is wired. | Ours, calculated from the ENS160 datasheet and the stored energy formula. Not from any paper. | Calculation only. PPK2 measurements will replace it.
9 | The ENS160 has no cheap measuring mode, so the cost per reading cannot be tuned away in firmware. | ScioSense ENS160 datasheet v1.3: 0.01 mA deep sleep, 2 mA idle, 29 mA standard, 79 mA peak under 5 ms. Warm up is needed after idle as well as after power off. | From the datasheet.
10 | Each ENS160 needs one 24 hour burn in on a bench supply, or every duty cycled reading comes back at start up quality. | ScioSense ENS160 datasheet v1.3: status is stored in non volatile memory only after 24 hours of continuous operation. | From the datasheet.
11 | Dust is the local variable worth modelling here, and our flat panel mounting is the worst case for it. | Hachicha 2019 (row 22), plus our own enclosure design. | Paper read at abstract level. The mounting is our choice.

Sheet: Decision
Item | Detail
The question | Do we continue with a statistical approach, or move to machine learning?
Our answer | Statistical baseline plus a rule based allocator first. One machine learning model as a challenger, judged on the same test. No LSTM, no reinforcement learning.
Why | At our horizon and our data volume, the domain papers show simple methods are hard to beat, and the safety margin matters more than the forecast.
The baseline | A clear sky curve for Sharjah, scaled by the clear sky index measured over recent slots, plus a per node factor learned from predicted against achieved harvest. That factor absorbs soiling, shading and ageing.
The allocator | Two gates. The SHT41 reading is an energy question: run it if stored energy leaves a reserve. The ENS160 reading is a power question until a larger capacitor is fitted: run it only if predicted harvest power holds through the warm up, judged on a low quantile rather than an average.
The ML challenger | A quantile gradient boosting model shared across all five nodes, with clear sky, dust and aerosol inputs from the free Open-Meteo air quality feed. Scored on completed ENS160 runs, not on RMSE.
What would change our minds | If the rule is tuned and ENS160 runs still abort often, or if error tracks dust loading more than anything else, the gradient boosting model becomes worth building.
How we judge it | Completed against aborted ENS160 runs, brown outs and missed uplinks, on the same replayed data for every method. Forecast error in joules or watts as a secondary measure, never MAPE, which breaks down at night.
For the report | Comparing a statistical baseline against an ML challenger on our own data is a result either way. If the baseline wins, that is a finding, and rows 6, 13 and 15 predict it.

Sheet: Terms
Term | What it means | Why it appears here
Persistence | The no change forecast. Either the next slot equals the last measured slot, or today's 09:00 equals yesterday's 09:00. | The floor every method is measured against. Free, and harder to beat than people expect.
EWMA | Exponentially weighted moving average. Keeps one running average per time of day, updated each day with a decay factor, so it reflects many past days. | The original predictor for harvesting nodes, from row 1.
WCMA | Weather conditioned moving average. The EWMA style profile, scaled by how today's recent slots compare with the same slots on past days. | Rows 2 and 3. The standard statistical baseline in this field.
Pro-Energy | Stores whole past days and predicts using the stored day that best matches today so far. | Row 4.
Clear sky index | Measured output divided by what a clear sky would give at that moment. Strips out the sun's daily arc so only the weather is left. | The basis of our planned baseline, and standard practice per row 23.
Skill score | How much better a forecast is than a reference, usually persistence. Zero means no better than doing nothing. | How rows 23 and 24 compare methods across studies.
MAPE and sMAPE | Average percentage error. Both break down when the true value is near zero, which is every night for solar. | Why we will report errors in joules or watts instead.
Quantile forecast | A forecast that gives a range, for example the value harvest will exceed 90 percent of the time, instead of a single number. | What the allocator should use, per row 10.
Oracle | A method given the true future, used as an upper bound. Not something you can deploy. | Rows 15, 16 and 21 measure against one.
Energy neutral operation | Spending on average no more energy than the node harvests, so it runs indefinitely. | The goal set out in row 1.
Batteryless | A node storing energy only in a capacitor, so it loses power regularly and must survive that. | Rows 14 to 19, and our own node.
Duty cycle | The fraction of time a node is awake or sensing. The usual thing these papers control. | Most of group C tunes this.
Reinforcement learning | Learning a policy by trying actions and receiving rewards, rather than predicting a value. | Rows 20 and 21.
