ahm-adsaad/sdp-sensor-nodes/docs/research/ml_energy_predcition_lr.xlsx

Sheet: About
Energy prediction for our harvesting sensor nodes: literature review
Prepared | 20 September 2026, for the senior design project (sdp-sensor-nodes).
Question behind it | We want the VPS to predict how much energy each node will have, so it can decide which node gets the next task. Before building that, we wanted to know whether the field uses statistical methods or machine learning, and which one we should pick.
What is in here | The Papers sheet summarises 14 studies. What we found records the conclusions we drew across them, including our own hardware numbers. Decision states what we plan to do and what would change our minds.
How the papers were found | Searches across IEEE Xplore, the ACM Digital Library, arXiv, MDPI, Semantic Scholar and publisher pages, using AI research assistance. Every DOI and arXiv identifier was then checked against its Crossref or arXiv record for title, authors, venue and year.
Evidence labels | Full text means we read the paper itself. Abstract only means we read the abstract or the publisher record, and nothing more. Preprint means it has not been peer reviewed.
Empty cells | An empty cell means we could not confirm that item from what we read. We did not fill gaps with guesses.
Numbers | Figures are quoted as each paper reports them. Metrics, sites and horizons differ between papers, so compare within a paper rather than across them.
Our own figures | Rows marked as ours in What we found come from our hardware and datasheets, not from the papers. They are calculations, and the PPK2 measurements will replace them.
AI disclosure | The search, extraction and drafting used AI assistance (Claude). Check any figure against the original before quoting it in the report.

Sheet: Papers
# | Paper title | Authors and year | Published in | What they covered | Numbers they report | What they concluded | Evidence | DOI or link
1 | Prediction and management in energy harvested wireless sensor nodes | Recas Piorno, Bergonzini, Atienza and Simunic Rosing, 2009 | Wireless VITAE 2009, pages 6 to 10 | Introduces WCMA, a weather conditioned moving average. It predicts the next 30 minute slot of solar harvest from the last sample and the mean of the same slot over the previous four days, scaled by how today is running compared with those days. Tuned and tested on 45 days of one minute measurements from a PowerFilm panel on a supercapacitor node. | Average prediction error 9.8 percent for WCMA against 28.6 percent for EWMA. On a day with a sudden weather change, the noon slot error was 10.20 percent for WCMA and minus 90.99 percent for EWMA. | A small amount of recent history, weighted by how the current day is running, predicts the next slot far better than an exponentially weighted average, at negligible cost on the node. | Full text | https://doi.org/10.1109/WIRELESSVITAE.2009.5172412
2 | Evaluation and design exploration of solar harvested-energy prediction algorithm | Ali, Al-Hashimi, Recas and Atienza, 2010 | DATE 2010, pages 142 to 147 | Stress tests WCMA at six US measurement sites with a year of data each, at slot lengths from 5 minutes to 1 hour, and measures what a prediction costs on an MSP430. | MAPE of 3.45 to 8.31 percent at 5 minutes, 6.59 to 17.22 percent at 30 minutes and 8.88 to 21.43 percent at 1 hour, with night excluded. A prediction costs 4 to 9 microjoules, and sampling plus prediction is 2.880 mJ per day, about 0.8 percent of sleep energy. | Accuracy depends on the site and on the horizon, and the best parameters differ from one site to another. | Full text | https://doi.org/10.1109/DATE.2010.5457222
3 | Online machine learning for 1-day-ahead prediction of indoor photovoltaic energy | Kraemer, Asad, Bach and Renner, 2023 | IEEE Access, volume 11 | Predicts indoor photovoltaic energy 24 hours ahead at six locations in one building, using 961 days of measurements and online learning with calendar, lag, sun angle and weather forecast inputs. Compares a random forest against persistence and EWMA, and against SVM, XGBoost and neural networks. | Persistence gave mean total daily errors of 31.52 to 58.54 percent. The random forest improved on persistence by 32 and 23 percent at one window location, 22 and 16 percent at another, and 56 and 47 percent at a hallway lit only by artificial light. EWMA beat persistence at one location only. | Relatively simple machine learning beats a persistence predictor (carrying value from prev day forward) indoors. SVMs, XGBoost and neural networks did not in general score better than the random forest. | Full text | https://doi.org/10.1109/ACCESS.2023.3267810
6 | Robustness of predictive energy harvesting systems: analysis and adaptive prediction scaling | Stricker, Da Forno and Thiele, 2022 | IET Computers and Digital Techniques, volume 16, issue 4 | Measures how prediction error propagates into scheduler and system performance for solar harvesting nodes, defines a robustness metric, and proposes scaling the forecast down by a factor learned online while holding an energy reserve. Simulated on outdoor and indoor traces, with the model validated on hardware using a 0.95 F supercapacitor. | An EWMA forecast with only 6 percent mean error still cut weekly usable energy to 66 and 73 percent of what a perfect forecast allowed. EWMA with adaptive scaling reached 3.54 Wh minimum daily energy against 3.14 Wh for the most accurate predictor tested, 13 percent higher. Indoors, persistence had 38 and 56 percent error where EWMA had 54 and 73 percent. | How the scheduler uses a prediction matters more than how accurate the prediction is. A less accurate predictor that is scaled down can beat a more accurate one used at face value. | Full text | https://doi.org/10.1049/cdt2.12042
8 | Predicting solar generation from weather forecasts using machine learning | Sharma, Sharma, Irwin and Shenoy, 2011 | IEEE SmartGridComm 2011 | Predicts solar generation 3 hours ahead at noon from six weather forecast variables plus day of year, comparing linear least squares, support vector regression with and without PCA, a sky cover only model and past predicts future. Trained on January to August 2010 and tested on September and October. | Test RMSE in W per square metre: 128 for SVR with PCA, 130 for linear least squares, 163 for SVR with an RBF kernel, 175 for the sky cover model and 261 for past predicts future. | Machine learning on several weather variables predicts generation considerably better than a sky cover model or the node's own history. | Full text | https://doi.org/10.1109/SmartGridComm.2011.6102379
9 | An energy-aware task scheduler for energy-harvesting batteryless IoT devices | Sabovic, Sultania, Delgado, De Roeck and Famaey, 2022 | IEEE Internet of Things Journal, volume 9, issue 22 | A task scheduler for batteryless devices. Each task gets a required start voltage from a capacitor model, and the device sleeps and re-measures until it can finish the task before its deadline. Tested on real hardware with an e-peas harvester and an amorphous silicon panel under controlled light, with capacitors from 4.7 to 20 mF. | The scheduled device stayed awake for the entire experiment and avoided power failures completely, and executed more cycles than the energy unaware scheduler at 10 mF or less with 40 microamps of harvest. The measurement divider drew about 1.5 mA while sampling. | Checking measured storage voltage against a per task threshold is enough to avoid power failures. The authors state that they did not consider a predictive approach. | Full text | https://doi.org/10.1109/JIOT.2022.3185321
10 | Energy-aware packet schedulers for battery-less LoRaWAN nodes | Capuzzo, Delgado, Famaey and Zanella, 2022 | arXiv preprint 2212.09453 | Compares seven packet scheduling policies for a batteryless LoRaWAN node that differ only in how they estimate harvest: an oracle with true future harvest, a fixed voltage threshold, an assumption of zero harvest, short moving averages, and an energy unaware baseline. Simulated in ns-3 on four real indoor solar traces. | The energy unaware scheduler sent 20 to 40 percent fewer packets than the oracle, and the fixed threshold about 10 percent fewer. Assuming zero harvest and averaging the last 5 seconds were both almost optimal. With a 2 mF capacitor the zero harvest policy sent nothing at all, because its threshold could never be reached. | Energy aware scheduling raises how many packets a batteryless LoRaWAN node can send, and simple harvest estimates come close to an oracle that knows the future. | Preprint, full text | https://arxiv.org/abs/2212.09453
11 | ACES: automatic configuration of energy harvesting sensors with reinforcement learning | Fraternali, Balaji, Agarwal and Gupta, 2020 | ACM Transactions on Sensor Networks, volume 16, issue 4 | Uses tabular Q learning on a server to set the sensing period of indoor light powered supercapacitor nodes. The state is light level, supercapacitor voltage and a weekday flag, and training uses a simulator built from datasheets plus 15 days of each node's own light data. Deployed on 60 nodes for two weeks. | Nodes stopped operating 0.1 percent of the time in the deployment. In simulation the mean sampling period was 71 s against 107 s for the authors' own rule based manager and 100 to 112 s for three earlier RL methods. Learning day by day ran two nodes flat in the first days until transfer learning was added, and a four day server outage killed three nodes. | Reinforcement learning can configure harvesting sensors better than hand written rules, as long as it is trained on a simulator first and protected while it learns. | Full text | https://doi.org/10.1145/3404191
12 | History and trends in solar irradiance and PV power forecasting: a preliminary assessment and review using text mining | Yang, Kleissl, Gueymard, Pedro and Coimbra, 2018 | Solar Energy, volume 168, pages 60 to 101 | A text mining review of the solar irradiance and PV forecasting literature, covering how methods are grouped, how they are evaluated, and what the field treats as standard practice. |  | Quoting the review: the proper implementation of any of these methods yields similar forecasting skills, as long as overfitting is prevented. It also notes that in their simplest forms, ML methods are statistical methods, and that almost every statistical and machine learning solar forecasting paper removes the diurnal cycle. | Full text | https://doi.org/10.1016/j.solener.2017.11.023
13 | A meta-analysis of solar forecasting based on skill score | Nguyen and Musgens, 2022 | arXiv preprint 2208.10536 | A meta analysis of deterministic solar forecasting. The authors screened 1,447 papers, read 320 in full, and analysed 4,687 reported results for what drives forecast skill. | 4,687 data points from 320 papers. Overfitting appeared once training sets ran longer than about 2,000 days. | Forecast horizon has a central impact and dominates the other factors. Ensemble and hybrid models were the most accurate at every horizon, sky and satellite images were the most useful inputs intra day, and numerical weather predictions with local measurements were the most useful day ahead. | Preprint, full text | https://arxiv.org/abs/2208.10536
14 | Impact of dust on the performance of solar photovoltaic (PV) systems under United Arab Emirates weather conditions | Hachicha, Al-Sawafta and Said, 2019 | Renewable Energy, volume 141, pages 287 to 297 | Indoor and outdoor experiments in Sharjah characterising deposited dust, with particle sizes from 1.61 to 38.40 micrometres, and its effect on PV electrical performance. Includes five months of outdoor exposure and a comparison of panel tilt angles. | Normalised power fell 1.7 percent per g per square metre of dust. Efficiency loss by tilt was 37.63 percent for horizontal panels, 14.11 percent at 25 degrees and 10.95 percent at 45 degrees. Over five months outdoors, soiling losses rose 12.7 percent as dust density reached 5.44 g per square metre. | Dust is a large and tilt dependent loss under UAE conditions, and a linear model of dust density predicts the drop in performance. | Abstract only | https://doi.org/10.1016/j.renene.2019.04.004

Sheet: What we found
# | What we found | What it rests on | How sure we are
1 | No study we read shows an LSTM beating simpler models at the horizons a task allocator needs. Where deep learning did appear at node level, it was only compared against EWMA or WCMA. | Makridakis 2018 (LSTM sMAPE 11.67 against ARIMA 7.19). We found no node level study comparing an LSTM against gradient boosting or a weather driven regression. | Well supported, with the caveat that M3 is monthly business data, not solar.
2 | Where machine learning does win, the winner is usually a tree model, and the gain comes from the inputs rather than the algorithm. | Kraemer 2023 (random forest beat SVM, XGBoost and neural networks indoors), Sharma 2011 (SVR beat linear regression by 2 W per square metre while both beat history by a wide margin), M5 2022 (LightGBM plus covariates). | Well supported across three papers.
3 | How the scheduler uses a forecast matters more than how accurate the forecast is. | Stricker 2022 (6 percent mean error still cost about a third of usable energy; a scaled down EWMA beat the most accurate predictor by 13 percent), Capuzzo 2022 (zero harvest and 5 second average both almost optimal against an oracle). | Well supported, and it is the finding that shapes our design.
4 | Simple threshold rules on measured storage voltage avoid power failures on hardware very like ours, without any prediction at all. | Sabovic 2022 (real e-peas hardware, no power failures, and the authors state they did not consider a predictive approach). | Demonstrated on hardware.
5 | Forecasts earn their place at horizons beyond a couple of hours, and that is where weather data, not model complexity, does the work. | Sharma 2010 (battery depleted on under 5 percent of days with forecasts against nearly 50 percent without), Nguyen and Musgens 2022 (horizon dominates all other factors). | Well supported.
6 | Reinforcement learning is a research project in its own right, and it drains supercapacitors while it learns. | Fraternali 2020 (two nodes ran flat during day by day learning; a server outage killed three more; needed a simulator plus 15 days of per node data). | Clear enough that we are not attempting it now.
7 | Our hardware, not the model, is the binding limit. One ENS160 reading needs about 21 J out of storage, and the 0.22 F supercapacitor holds about 0.56 J between the PMIC thresholds as rev 1 is wired. | Our own calculation from the ENS160 datasheet (29 mA for a 3 minute warm up at 3.3 V) and the stored energy formula. Not from any paper. | Calculation only. PPK2 measurements will replace it.
8 | The ENS160 has no cheap measuring mode, so the cost per reading cannot be tuned away in firmware. | ScioSense ENS160 datasheet version 1.3: average current 0.01 mA in deep sleep, 2 mA typical in idle, 29 mA in standard mode, with a 79 mA peak for under 5 ms. Warm up is required after idle periods as well as after power off. | From the datasheet.
9 | Each ENS160 needs a one time 24 hour burn in on a bench supply, or every duty cycled field reading comes back at start up quality. | ScioSense ENS160 datasheet version 1.3: status is stored in non volatile memory only after 24 hours of continuous operation, and if unpowered before that the sensor resumes initial start up mode. | From the datasheet.
10 | Dust is the local variable worth modelling in Sharjah, and our flat panel mounting is the worst case for it. | Hachicha 2019 (1.7 percent loss per g per square metre; 37.63 percent loss horizontal against 10.95 percent at 45 degrees), plus our enclosure design, which glues the panels flat to the lid. | Paper read at abstract level; the mounting is our own design choice.

Sheet: Decision
Item | Detail
The question | Do we continue with a stochastic or statistical approach, or move to machine learning?
Our answer | Statistical baseline plus a rule based allocator first. Keep one machine learning model as a challenger, judged on the same test as the baseline. Do not start with an LSTM.
Why, in one line | At our horizons and our data volume, the papers show simple methods are hard to beat, and the scheduler's safety margin matters more than forecast accuracy.
What the baseline is | A clear sky curve for Sharjah, scaled by the clear sky index measured over recent slots, plus persistence for the next slot, and a per node factor learned from predicted against achieved harvest. That factor absorbs soiling, shading and ageing.
What the allocator does | Two gates. The cheap SHT41 reading is an energy question: run it if stored energy minus the task leaves a reserve. The ENS160 reading is a power question until we fit a larger capacitor: run it only if predicted harvest power holds above the load for the warm up, using a low quantile rather than an average.
The one ML model worth trying | A quantile gradient boosting model shared across all five nodes, with clear sky, dust and aerosol inputs from the free Open-Meteo air quality feed. Scored on how many ENS160 runs complete rather than on RMSE.
What we are not doing | LSTM or other deep learning as the main predictor, and reinforcement learning. Neither is required for the project, and neither is supported by what we read for a fleet this size.
What would change our minds | If the rule is tuned and ENS160 runs still abort often, or if error tracks dust loading more than anything else, then the gradient boosting model with dust inputs becomes worth the effort.
How we will judge it | Completed against aborted ENS160 runs, brown outs, and missed uplinks, on the same replayed data for every method. Forecast error in joules or watts as a secondary measure, never MAPE, which breaks down at night.
Honest framing for the report | Comparing a statistical baseline against a machine learning challenger on our own data is a result either way. If the baseline wins, that is a finding, and the papers here predict it.
Every claim on this sheet traces to the Papers or What we found sheets, except the design choices, which are ours.
