ahm-adsaad/sdp-sensor-nodes/enclosure/out/lid.step

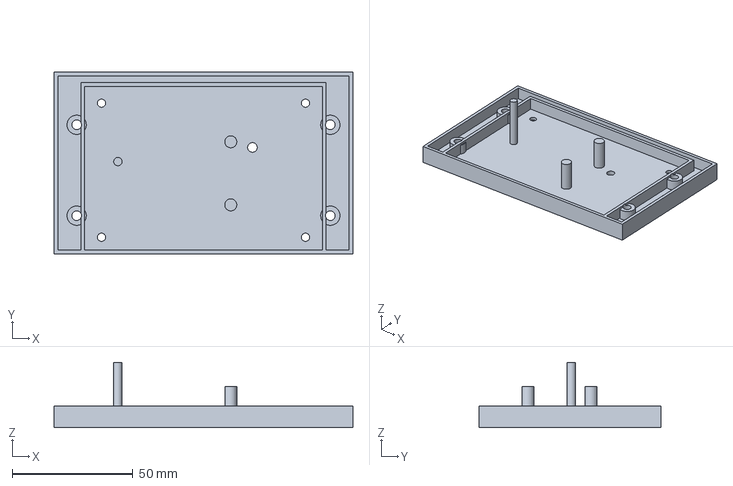
[picture p25: CAD file, 2026-10-21]
enclosure/out/lid.step
124.0 x 75.4 x 27.0 mm
