ahm-adsaad/sdp-sensor-nodes/enclosure/out/wedge.step

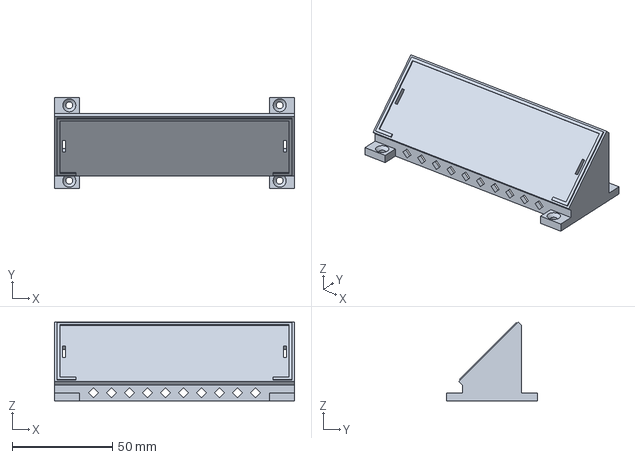
[picture p26: CAD file, 2026-10-21]
enclosure/out/wedge.step
120.0 x 45.7 x 39.4 mm
