ahm-adsaad/sdp-sensor-nodes/enclosure/out/fit_coupon.step

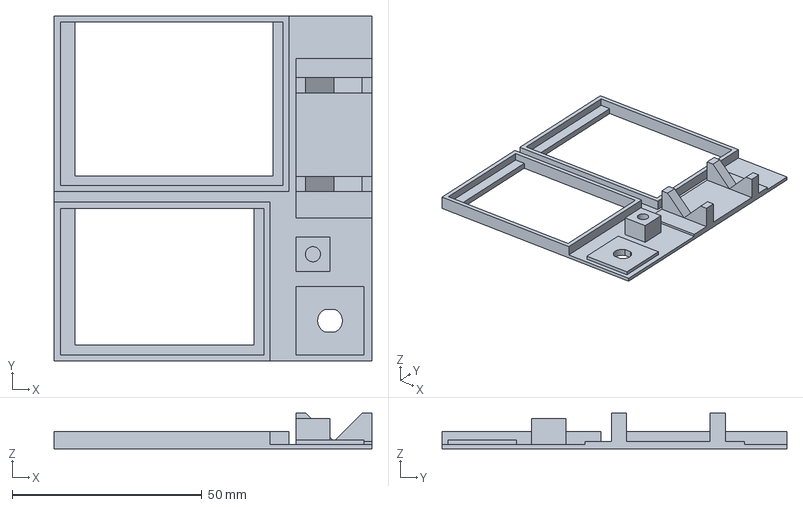
[picture p27: CAD file, 2026-10-21]
enclosure/out/fit_coupon.step
83.6 x 90.8 x 9.42 mm
