ahm-adsaad/sdp-sensor-nodes/enclosure/out/body.step

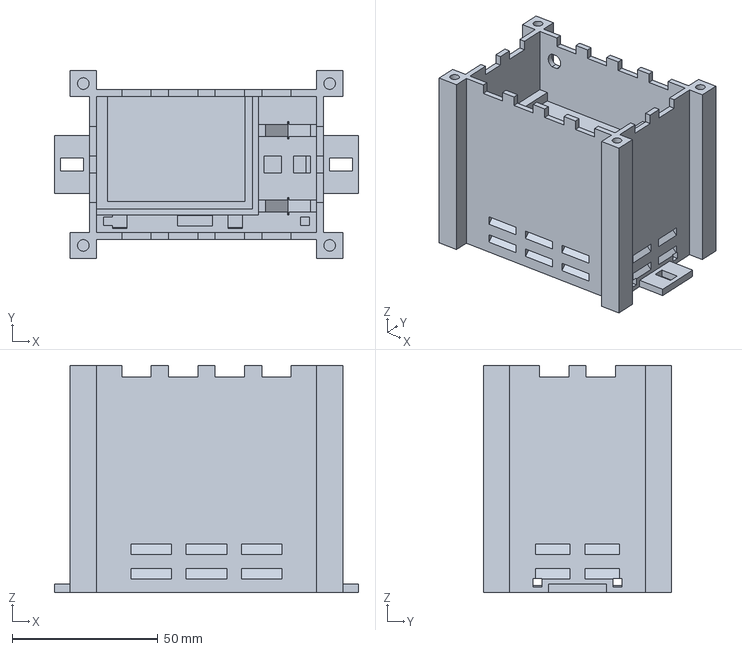
[picture p28: CAD file, 2026-10-21]
enclosure/out/body.step
104.4 x 64.6 x 78.1 mm
