ahm-adsaad/sdp-sensor-nodes/enclosure/out/lid_1panel.step

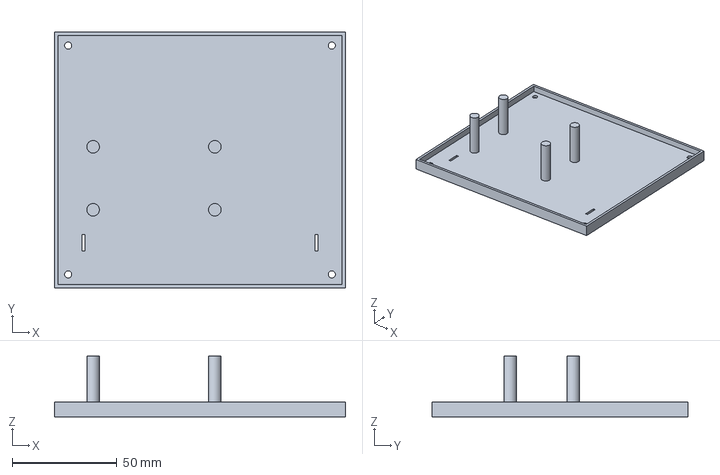
[picture p29: CAD file, 2026-10-05]
enclosure/out/lid_1panel.step
138.6 x 122.0 x 29.0 mm
