ahm-adsaad/sdp-sensor-nodes/(list of files, cad)

Other CAD files:
enclosure/out/lid_2panel.step
enclosure/out/lid_3panel.step
enclosure/out/body.3mf
enclosure/out/body.stl
enclosure/out/fit_coupon.3mf
enclosure/out/fit_coupon.stl
enclosure/out/lid.3mf
enclosure/out/lid.stl
enclosure/out/lid_1panel.3mf
enclosure/out/lid_1panel.stl
enclosure/out/lid_2panel.3mf
enclosure/out/lid_2panel.stl
enclosure/out/lid_3panel.3mf
enclosure/out/lid_3panel.stl
enclosure/out/wedge.3mf
enclosure/out/wedge.stl
