ahm-adsaad/sdp-sensor-nodes/enclosure/out/renders/assembly_back.png

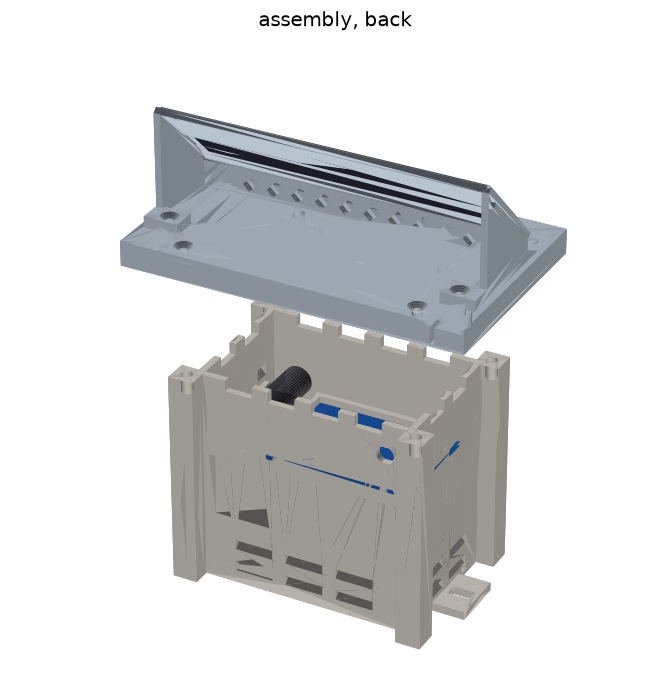
enclosure/out/renders/assembly_back.png
