ahm-adsaad/sdp-sensor-nodes/enclosure/out/renders/assembly_front.png

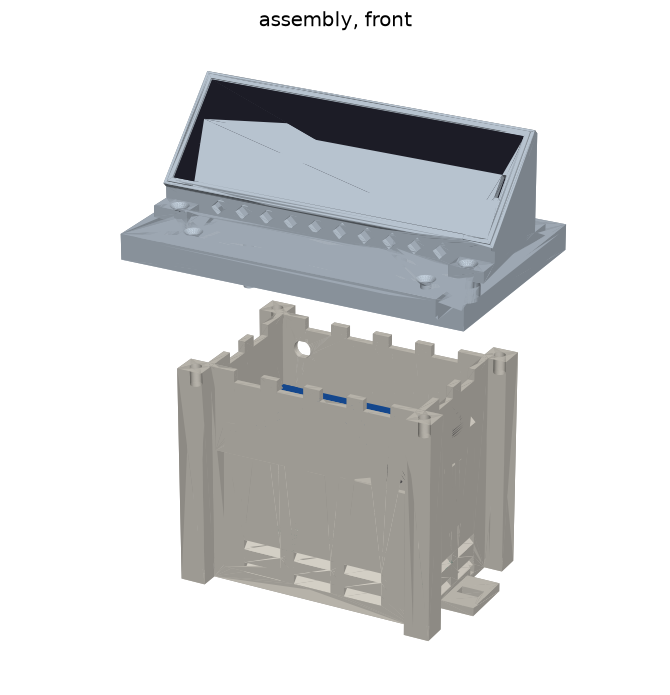
enclosure/out/renders/assembly_front.png
