ahm-adsaad/sdp-sensor-nodes/enclosure/out/renders/assembly_top.png

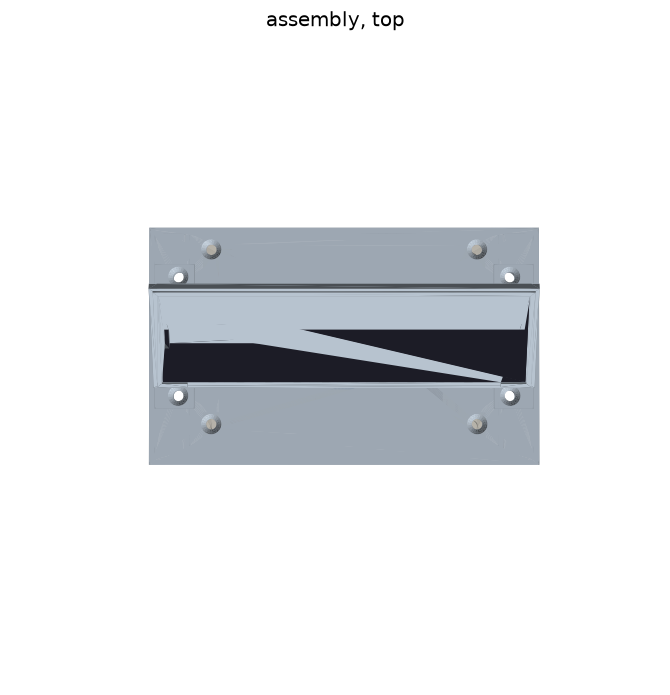
enclosure/out/renders/assembly_top.png
