ahm-adsaad/sdp-sensor-nodes/enclosure/out/renders/assembly_under.png

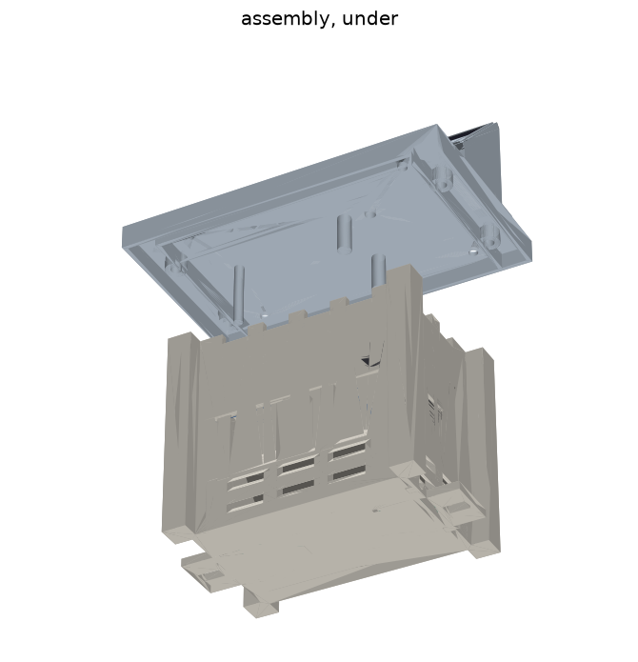
enclosure/out/renders/assembly_under.png
