ahm-adsaad/sdp-sensor-nodes/forecast/tests/fixtures/ppk2_sample.csv

Timestamp(ms) | Current(uA)
0 | 10000.000
10000 | 10000.000
20000 | 10000.000
30000 | 10000.000
40000 | 10000.000
50000 | 10000.000
60000 | 10000.000
70000 | 10000.000
80000 | 10000.000
90000 | 10000.000
100000 | 10000.000
110000 | 10000.000
120000 | 10000.000
130000 | 10000.000
140000 | 10000.000
150000 | 10000.000
160000 | 10000.000
170000 | 10000.000
180000 | 10000.000
190000 | 10000.000
200000 | 10000.000
210000 | 10000.000
220000 | 10000.000
230000 | 10000.000
240000 | 10000.000
250000 | 10000.000
260000 | 10000.000
270000 | 10000.000
280000 | 10000.000
290000 | 10000.000
300000 | 10000.000
310000 | 10000.000
320000 | 10000.000
330000 | 10000.000
340000 | 10000.000
350000 | 10000.000
360000 | 10000.000
370000 | 10000.000
380000 | 10000.000
390000 | 10000.000
400000 | 10000.000
410000 | 10000.000
420000 | 10000.000
430000 | 10000.000
440000 | 10000.000
450000 | 10000.000
460000 | 10000.000
470000 | 10000.000
480000 | 10000.000
490000 | 10000.000
500000 | 10000.000
510000 | 10000.000
520000 | 10000.000
530000 | 10000.000
540000 | 10000.000
550000 | 10000.000
560000 | 10000.000
570000 | 10000.000
580000 | 10000.000
590000 | 10000.000
600000 | 10000.000
610000 | 10000.000
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
