ahm-adsaad/sdp-sensor-nodes/sensor-nodes-hardware/Schematic_MAIN-EH-Sensor-Node-SDP-MAIN-copy_2026-10-05.pdf

# GND 10 DIO3 11 DIO4 12 VCC 13 DIO0 14 DIO1 15 DIO2 16

## XL1276 LoRa

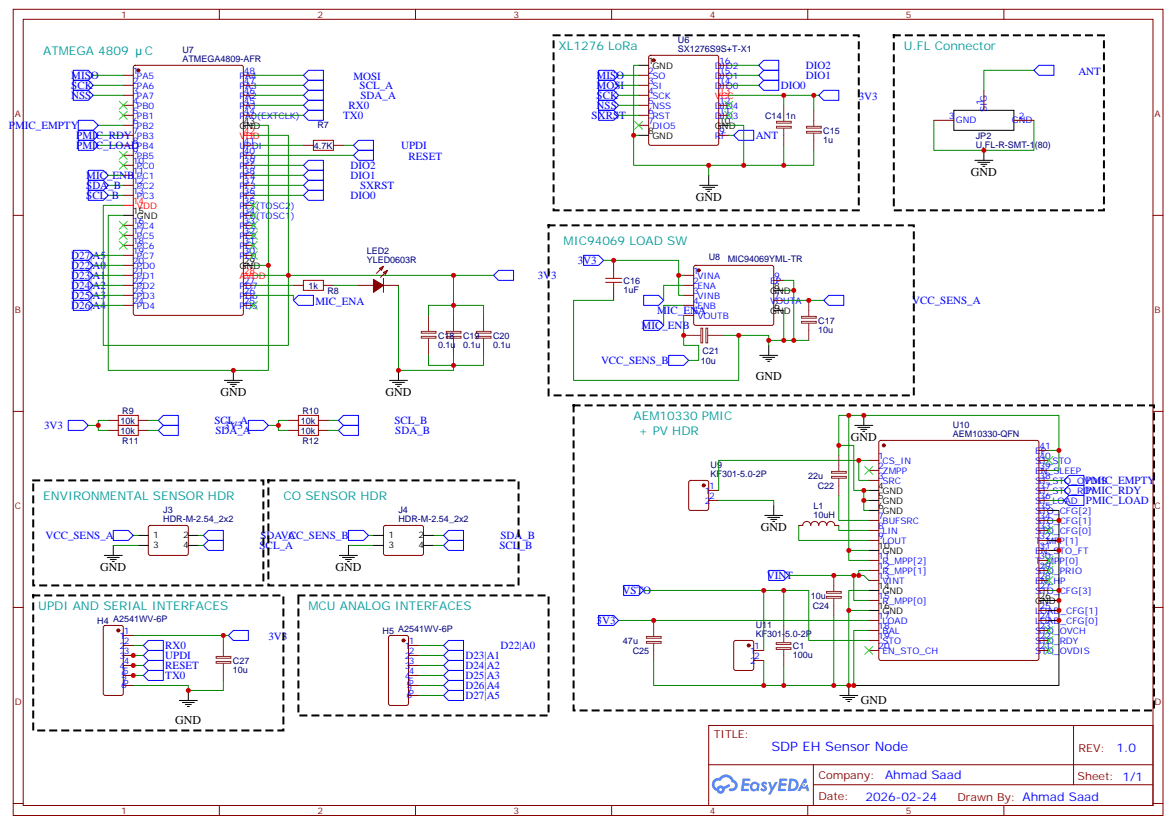
[picture p34: page 1]

UPDI AND SERIAL INTERFACES

Drawn By: Ahmad Saad
