ahm-adsaad/sdp-sensor-nodes/sensor-nodes-hardware/PCB_PCB_MAIN-EH-Sensor-Node-SDP-MAIN-copy_2026-10-05.pdf

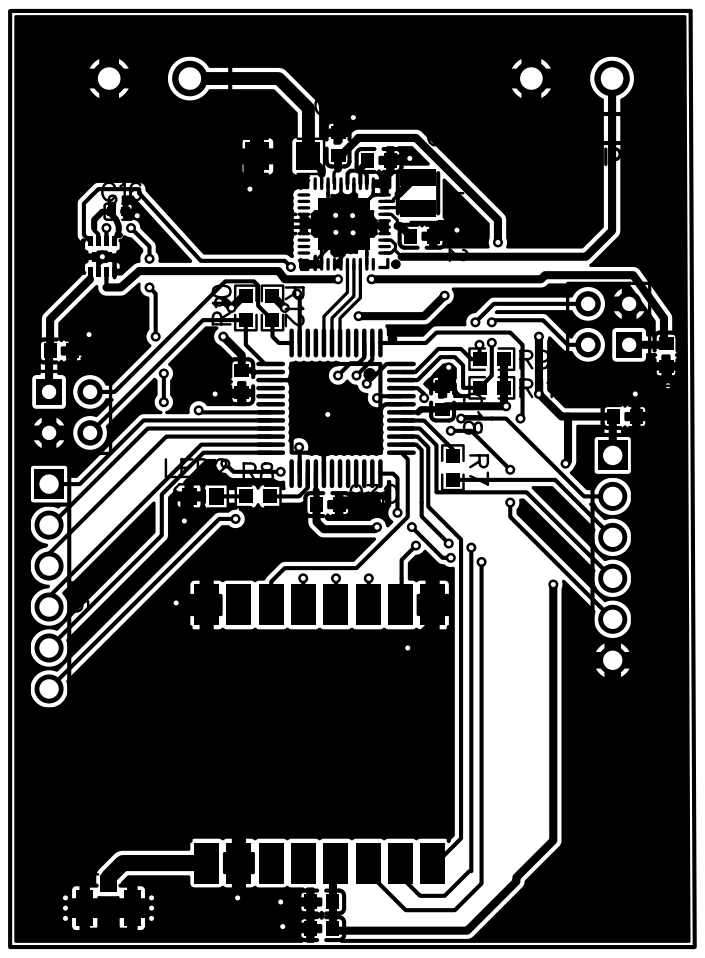
[picture p36: page 1]
