ahm-adsaad/sdp-sensor-nodes/sensor-nodes-hardware/PCB_PCB_MAIN-EH-Sensor-Node-SDP-MAIN-copy_2026-10-02.pdf

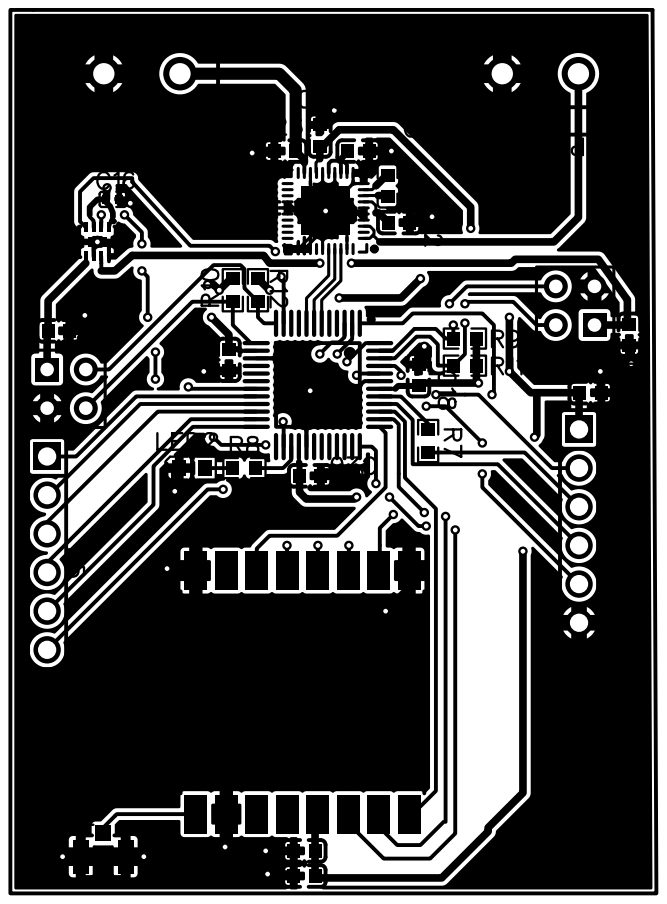
[picture p37: page 1]
