ahm-adsaad/sdp-sensor-nodes/(list of files, drawings)

Other design files:
sensor-nodes-hardware/sensor-node-pcbdoc.pcbdoc
