ahm-adsaad/sdp-sensor-nodes/sensor node tdma/sensor_node_1_tdma/secrets.h

// OTAA keys for NODE 1. Not in git (see .gitignore); copy secrets.example.h for a new node.
#pragma once

static const u1_t PROGMEM APPEUI[8] = { 0x00, 0x00, 0x00, 0x00, 0x00, 0x00, 0x00, 0x00 };

// DevEUI a382a57121e8bd08, byte-reversed (LSB first) as LMIC requires
static const u1_t PROGMEM DEVEUI[8] = { 0x08, 0xBD, 0xE8, 0x21, 0x71, 0xA5, 0x82, 0xA3 };

// AppKey, normal (MSB-first) order
static const u1_t PROGMEM APPKEY[16] = { 0x94, 0x46, 0xE3, 0x56, 0xC3, 0xB9, 0x07, 0xBC,
                                          0x9B, 0x12, 0xE3, 0xBE, 0xFD, 0xC2, 0xE8, 0x60 };
