ahm-adsaad/sdp-sensor-nodes/(commit log)

2026-08-28 Add PCB sources and the sensor bring-up design docs
2026-08-28 Set up PlatformIO project with board pin map and blink test app
2026-08-28 Add sensor rail power control and an I2C bus scan to the test app
2026-08-28 Add SHT41 wrapper and print temperature and humidity every 2 s
2026-08-28 Add serial commands to toggle the sensor rail and rescan, plus a README
2026-08-28 Fix driver reset idiom, guard against a stuck I2C bus, and tidy the bring-up app
2026-09-02 Add a photo of the assembled rev 1.0 node for enclosure work
2026-09-02 Add sleep/wake to the ENS160 and SHT41 wrappers with serial toggles
    Both sensors share the one switched rail on rev 1.0, so per-sensor power has to
    be done over I2C. ENS160 sleep() writes OPMODE DEEP SLEEP (~10 uA vs 29 mA) and
    wake() goes back through IDLE to STANDARD and reads the mode back. The SHT4x has
    no sleep command and idles below 1 uA on its own, so its sleep()/wake() only
    gate read() to keep the two interfaces the same. sensor_test gets t/e commands
    to toggle each sensor for bench current measurements.
2026-09-02 Require NEWDAT before accepting an ENS160 sample
    First read after wake() came back as eCO2=0 TVOC=0 AQI=0 with the validity
    flag at NORMAL, because the DATA registers had not been filled yet. Check the
    NEWDAT bit first and report no sample instead.
2026-09-14 Add enclosure design spec for the sensor node case
2026-09-14 Add enclosure implementation plan and tighten the spec
2026-09-14 Add enclosure layout parameters with tests
2026-09-14 Model the enclosure body
2026-09-14 Export print files and renders for the enclosure
2026-09-14 Add a browser viewer for the enclosure assembly
2026-09-14 Fix blank enclosure viewer: update world matrices before framing the camera
2026-09-14 Add placement labels, sensor boards and a top view to the enclosure viewer
2026-09-14 Give viewer labels and view buttons more breathing room
2026-09-16 Drop the accent stripe on the handover page and widen the lid button padding
2026-10-05 add a one-panel lid and a fit review for the enclosure
2026-10-05 add the 2 October schematic and PCB exports
2026-10-05 add the fabricated rev-2 schematic and PCB exports, update forecast spec inputs
2026-10-10 fetch the Open-Meteo feeds as hourly frames and record test fixtures
2026-10-10 convert sky ratios to node energy and track the per-node ratio
2026-10-10 treat PPK2 recording gaps as unknown and fix the negative-current test
2026-10-10 record the PPK2 gap rule and the fixed negative-current test in the plan
2026-10-10 publish node forecasts and node ratios to InfluxDB on timers
2026-10-10 measure the node ratio on harvesting power from the PPK2 trace
2026-10-19 drop the 3 uW cold-start figure, it only holds when the store is already charged
2026-10-19 add a sustainability-led version of the poster as a second pdf
2026-10-19 add the LoRaWAN node sketches with power-down sleep and a switched SHT41 rail
    Both nodes now sleep in power-down between 60 s uplinks (RTC PIT wake,
    LMIC clock credited after sleep), answer downlink tasks straight away,
    power the sensor rail only while reading, and run at 8 MHz with a 2 %
    LMIC clock error. OTAA keys moved to a git-ignored secrets.h.
2026-10-19 cap the node's transmit power so joins don't brown out the PMIC rail
    The AEM10330 LOAD output only gives about 60 mA and LMIC sends joins at
    16 dBm on PA_BOOST, so the board reset on every JoinRequest (reset flags
    0x02) and never heard the JoinAccept. Clamp every frame to TX_POWER_DBM
    (10 dBm for now) in EV_TXSTART.
2026-10-21 lay out the rev-2 enclosure: louvred sensor shield, chimney body, tilted panel
2026-10-21 export the rev-2 print files and renders
2026-10-21 add the rev-2 enclosure viewer and refresh the enclosure docs
2026-10-21 record the enclosure viewer's typefaces in the impeccable config
2026-10-21 drive the viewer's dimension table from the parameters and list the rev-2 print files
2026-10-21 turn the wedge feet outward, drop the SMA under the drip skirt, web the chimney holes, move the lead hole behind the wall
2026-10-27 read the storage voltage through a divider on H5 pin 1 and append it to the status packet
    R1/R2 bodge from the storage terminal to PD0 (AIN0), internal 2.5 V reference, long ADC sampling window so it works without a cap. Status packet grows to 11 bytes, bytes 9-10 = VSTO in mV. Compile-tested only.
2026-10-28 read the ENS160 into the packets and harden the join against rail brown-outs
    ENS160 driven by a small register-level header (nothing to install),
    compensated with the SHT41 reading, held in deep sleep until the join is
    accepted. Status packet grows to 15 bytes: AQI, ENS160 validity, the TX
    power cap and the boot's reset flags; gas replies carry AQI and validity.
    The TX power cap now learns: a brown-out reset while the radio is
    transmitting lowers it by 2 dB (floor 2 dBm) and the result lives in
    EEPROM, together with the OTAA DevNonce so a reboot never repeats a nonce
    ChirpStack has already accepted. ChirpStack codec added next to the
    sketches. Compile-tested only.
2026-10-28 keep the node awake while LMIC has a frame queued, so it no longer freezes after a MAC downlink
    After a downlink carrying MAC commands LMIC queues its own uplink with the
    answers (OP_POLL) and only sends it while loop() keeps running. do_send and
    loop() looked at OP_TXRXPEND alone, so the board slept, or LMIC_setTxData2
    failed with LMIC_ERROR_TX_BUSY and it slept a whole cycle, and it stopped
    sending for good (seen on node 1, 2026-10-20). lmicTxBusy() checks
    OP_TXRXPEND | OP_TXDATA | OP_POLL | OP_JOINING: do_send waits 1 s and retries
    while it is set, a failed LMIC_setTxData2 retries in 1 s, and loop() sleeps
    only once it is clear. Same change in both nodes, described in the header.
2026-10-28 add the TDMA version of the sensor node firmware in its own folder
    sensor node tdma/ holds the TDMA variant of sensor_node_1 / sensor_node_2 (the
    ALOHA sketches in sensor node to send/ are unchanged), as flashed on both boards
    on 2026-10-28. One uplink per 30 s frame in the node's own slot, schedule and
    slot correction from the TDMA downlinks on fPort 20, tasks answered in the next
    slot, energy (0..200 from the storage voltage, 2.80-3.60 V) appended to every
    uplink, tasks the node cannot afford skipped. Brown-out back-off (rest 30 s,
    60 s, ... before switching anything on, radio only from the 3rd brown-out in a
    row, sensors retried hourly) and a pulsed soft start for the sensor rail.
    Runs wi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
2026-10-28 stamp the uplink time before LMIC can start the radio, so slot corrections hit
    LMIC_setTxData2 starts the transmission inside the call when the duty cycle
    allows, so EV_TXSTART fired before do_send set dataFrameInFlight, txStartedAt
    was never updated, and each slot correction was applied to a stale uplink time:
    the boards landed 11-15 s off where the server asked for a full frame (seen in
    the server's timing log on 2026-10-28). dataFrameInFlight is now set before the
    call and cleared again if it fails. Compile-tested; not yet flashed.
2026-10-28 power the sensors per task, on either header, with a bench-tested switch-on ramp
    TDMA firmware (sensor node tdma/), as flashed on SN-1 on 2026-10-28:
    - Sensors are powered only for the task that needs them: temperature and
    humidity switch the SHT41's header on in the reply slot; a gas task switches
    the ENS160's header on as soon as it arrives and heats it until the reply slot
    a frame (30 s) later. Status packets switch nothing on and mark the sensor
    fields "not measured" (0x7FFE, gas status 0xFC).
    - Both headers are used: each sensor is found on J3 or J4 at boot and the one
    TWI is moved to its header (Wire.swap) before every access.
    - Headers switch on with a pulsed ramp (50-800 us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
2026-10-28 power nothing at boot, and stop blocking the sensors after radio brown-outs
    TDMA firmware (sensor node tdma/):
    - No sensor header is switched on at boot any more. The first task that needs
    the SHT41 or the ENS160 looks for it on J3, then J4 (findSensor), once per
    boot, so a header is only ever powered for a task.
    - Removed the "start without the sensors" mode. After 3 unexplained brown-outs
    in a row the node used to block both sensors for an hour, but SN-1's run on
    2026-10-28 browned out during transmissions and the join at 2.92 V storage,
    with every sensor already off: blocking them changed nothing and would have
    left the node answering tasks with "no reading". Unexplained brown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
2026-11-01 tick the sleep clock at 16 Hz so the node idles 0.1 s, not 2 s, before each slot
    TDMA firmware (sensor node tdma/), both sketches:
    - The RTC PIT ticks at 16 Hz (1.024 kHz / 64) instead of 1 Hz. sleepUntil()
    itself is unchanged, but its wait for a tick edge and its idle tail before
    the target shrink from about 2 s (0-1 s plus 1-2 s) to about 0.125 s. That
    idle ran at about 0.86 mA in every 30 s frame (audit estimate 16 J/day) and
    bought no accuracy: millis() is credited by calculation, not measured.
    - PIT_TICKS_PER_S sets the rate, and the default usPerTick, the boot
    calibration (64 ticks, still about 4 s) and the brown-out rest (seconds x 16
    ticks, so rests stay 30 s doubling to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
2026-11-01 idle through the boot calibration and the ENS160 poll, and park the TWI pins at boot
    - measurePitTick() idles between its checks instead of spinning for about 4 s
    at full speed (audit: about 30 mJ per boot). The PIT and the 1 ms millis
    tick both wake the CPU, so an edge is still seen within 1 ms of the 4 s.
    - The ENS160 NEWDAT poll waits its 100 ms in idle instead of delay(100). The
    15-try limit, its log line and the values it returns are unchanged;
    gasStart()'s reset and idle dwells (100 ms, 10 ms) stay as they were.
    - PA2/PA3 and PC2/PC3 are input-disabled at boot, the state headerOff()
    leaves them in. headerOn() re-enables a head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
2026-11-01 put the radio to sleep first thing at boot, so a brown-out rest really rests
    - New radioSleepEarly(), called in setup() right after the header enables
    are driven low and before brownOutBackOff(). It drives NSS high, starts
    SPI, waits 10 ms for the SX1276's power-on reset, reads RegOpMode (0x01)
    and writes it back with the mode bits (2:0) at 000 = sleep, keeping every
    other bit as read.
    - Until now the radio sat in standby (about 1.6 mA, datasheet from memory)
    from reset until os_init(), which runs after the brown-out rest and the 4 s
    calibration: up to about 2.5 J against an 8 min rest that is meant to let
    the storage recharge,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
2026-11-01 skip a gas task the node cannot afford before the heater runs, not after
    - When a gas task arrives (EV_TXCOMPLETE), the energy is checked before
    gasStart(). Below the gas cost the task is skipped there and then:
    tasksSkipped++, "Skipping task 0x3 at arrival: needs N, energy M",
    pendingCommand = 0, and the heater is not started. The next slot sends a
    status packet, as a skipped task does today.
    - Before, the check only ran in the reply slot, one frame later, after the
    ENS160 had already heated for about 29 s at 29 mA (about 2.8 J), so the
    skip saved nothing. The reply-slot check stays as it was and still covers
    the T/RH tasks.
    -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
2026-11-01 power down between join attempts and LMIC waits instead of idling all day
    - loop() only power-downed through the per-frame slot sleep, which needs
    sleepPending and LMIC not busy. Not joined, OP_JOINING keeps LMIC "busy"
    for good, so the node idled at about 1 mA between join attempts around the
    clock (audit: about 287 J/day, the 384 J store empty in about 1.3 days
    while the gateway is unreachable). The same idle covered the random 0-8 s
    before the first JoinRequest and the duty-cycle wait (about 7 s) before an
    uplink LMIC queues itself for MAC answers.
    - The idle branch now power-downs in chunks of up to 2 s through
    sleepUntil()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
2026-11-01 describe the 16 Hz sleep clock, the early radio sleep and the arrival-time gas check
    TDMA README (sensor node tdma/README.md):
    - New "Sleep" section: power-down between frames, between join attempts and
    during LMIC's duty-cycle waits, idle only while a TX/RX cycle runs; the RTC
    PIT ticks at 16 Hz and is measured against the main clock at boot.
    - "Brown-outs": the radio is put to sleep before the rest.
    - "Sensors: powered per task": with TEST_IGNORE_ENERGY 0 a gas task the node
    cannot afford is skipped as it arrives, before the heater runs.
    Final check of the sketches as committed, compile-tested only, not flashed:
    node 1 37718 B flash / 1604 B RAM, node 2 37720 / 1605 (f99731d: 37124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
2026-11-01 fix the sleep comments so they match the naps and the early radio sleep
    The freeze-fix notes at the top and above lmicTxBusy() still said loop()
    never sleeps while LMIC is busy. It now takes short naps (NAP_MS) that end
    at least 1 s before LMIC's next timed job, so both notes name that one
    exception and say a slot sleep or a send still waits.
    The README said the node idles only during a TX/RX cycle. It also idles
    for the last 1-3 s before each LMIC job and while LMIC holds a frame past
    the slot, so the bullet says so. The header bullet on power-down now
    mentions join attempts and LMIC waits too.
    At the tick credit in sleepUntil(), a note that millis() runs about 0.02 %
    fast in power-down (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
2026-11-01 record the energy audit of the TDMA firmware and the plan the sleep fixes followed
    docs/superpowers/specs/2026-11-01-tdma-energy-audit.md is a read-only review of
    the firmware at f99731d: a per-frame timeline, the energy sinks ranked, the
    functional contract the fixes were held to, bench measurement points, and the
    open questions (which receive window the TDMA downlink uses, gas heating time,
    R9-R12 back-feed, cadence). Nothing in it was measured; every figure is
    labelled datasheet, from memory, or assumed.
    docs/superpowers/plans/2026-11-01-tdma-energy-optimisation.md is the plan the
    six firmware commits above followed, with what was deliberately left out.
2026-11-01 add a basic SHT41 + ENS160 serial test that powers the headers with the ramp
2026-11-01 print each step of the ENS160 gas start and retry it every 10 s
2026-11-09 add TDMA sketches for sensor nodes 3 and 4 and move the default schedule to 4 slots
    - sensor_node_3_tdma and sensor_node_4_tdma are copies of the node 1 sketch
    (plus ens160_min.h) with NODE_NUMBER 3 and 4 and a header that says so;
    each needs its own git-ignored secrets.h with the node's ChirpStack keys.
    - DEFAULT_SLOTS 2 -> 4 in all four sketches (15 s slots, 60 s frame), so the
    free-run schedule before the first downlink matches a 4-node server, plus a
    static_assert that NODE_NUMBER has a slot. The downlink still sets the real
    schedule.
    - Comments and README updated for the 60 s frame (the gas heater now runs a
    60 s frame before the reply slot) and for what the server needs: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
2026-11-09 add the DevEUIs of nodes 3, 4 and 5
    - README: table of all five DevEUIs with the byte-reversed form secrets.h
    needs, matching num_to_eui on the server. Node 5 is registered in
    ChirpStack but has no sketch yet. AppKeys stay out of the repo.
    - sensor_node_3_tdma / sensor_node_4_tdma: DevEUI in the header comment,
    like nodes 1 and 2.
2026-11-09 support TDMA frames up to 10 minutes and warm the gas sensor 60 s before its slot
    - Downlinks for frames over 65 s come as 8 bytes: frame length in seconds
    as uint16 and the slot correction in ms as uint24. The 6-byte form (one
    byte of frame, 16-bit correction) only reached 65 s. The node reads
    both, by downlink length, so the server keeps the 6-byte form for short
    frames and nodes on older firmware keep working.
    - MAX_FRAME_MS 1800 s -> 600 s (10 min). The longest sleep is now a frame
    plus a correction of up to a frame (20 min); the pitTicks static_assert
    and the sleepUntil overflow note follow that. A correction longer than
    the frame is ignored as corrupt.
    - Gas task: the ENS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
2026-11-09 node 4: read temperature and humidity from a DHT11 on J3
    Node 4 now has a 3-pin DHT11 instead of the SHT41: VCC on VCC_SENS_A,
    data on SDA_A (PA2), GND. With the SHT41 the node hung on the I2C bus
    during every temperature / humidity task and the watchdog reset it.
    - USE_DHT11 (on for node 4): a temperature or humidity task powers J3
    with the same ramp and brown-out tracking as before, waits 1.1 s for the
    sensor to start, reads it over its single-wire protocol on PA2
    (interrupts off for about 5 ms, one retry after 1.1 s on a bad checksum
    or no answer) and switches J3 off. The data line uses the board's bus
    pull-up, so no extra resistor.
    - The reply packets are unchanged (C and %RH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
2026-11-09 do every task whatever the energy, and accept a negative slot correction
    - SKIP_UNAFFORDABLE_TASKS 0 replaces TEST_IGNORE_ENERGY 1 (team decision):
    the node does every task it is given, gas included, and still reports
    its energy. Before, a low node started the gas heater, which drained it
    below the gas cost, and then skipped the reading at its reply slot, so
    the server kept resending a task that never came back. Set it to 1 for
    the old skip behaviour.
    - Signed slot correction: bit 7 of downlink byte 1 marks the correction as
    int16 (6-byte form) or int24 (8-byte form). A node that came in late now
    gets a negative correction and waits a little less than a frame, instead
    of near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
2026-11-09 EXPERIMENTAL: stop a hung sensor from rebooting the node on every task
    Not tested on hardware yet; the approach and values may need changing.
    Both parts have their own switch at the top of each sketch (on); set it
    to 0 to go back to the old behaviour.
    - I2C_TIMEOUT_GUARD: MegaCoreX's Wire has no timeout, so a sensor that
    holds the bus left the node waiting until the 8 s watchdog reset it,
    and the next task did it again (node 4's SHT41). Every sensor access is
    now timed by the RTC PIT interrupt; after 3 s it ends the stuck transfer
    with the library's TWI_MasterTransactionFinished(), so the read fails as
    "no reading" and the header is switched off as usual.
    - WATCHDOG_COUNTS_AS_SENS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
